derek-weissinger-usafa/Astro-331-Lab-8/Past Documentation/Gemini Hardware Diagram/Gemini (Hamster Ball) .jpg

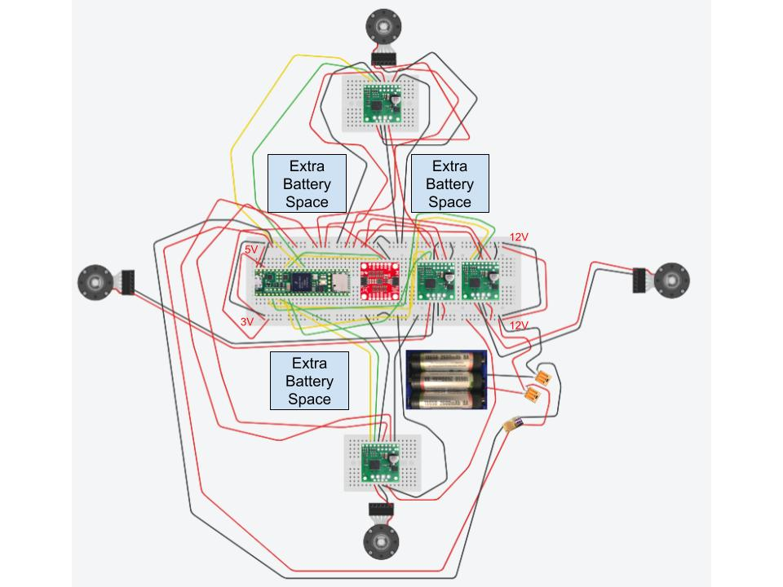
Past Documentation/Gemini Hardware Diagram/Gemini (Hamster Ball) .jpg
