derek-weissinger-usafa/Astro-331-Lab-8/Astro 331 Lab 8 Overview and Requirements.pptx

## Lab 8 3DOF RW Control

2/3 Body Problem
C2C Gowri Ramaprasad
C2C Derek Weissinger
C2C Owen Crawley

Notes: https://www.youtube.com/watch?v=jVXgWGK9Kr8

## Overview

- Using the small air bearing table, develop a reaction wheel control system in 3 degrees of freedom (pitch, yaw, roll).
- Develop a robust sensor fusion algorithm using gyroscopes, magnetometers and accelerometers to accurately determine attitude at any given state.

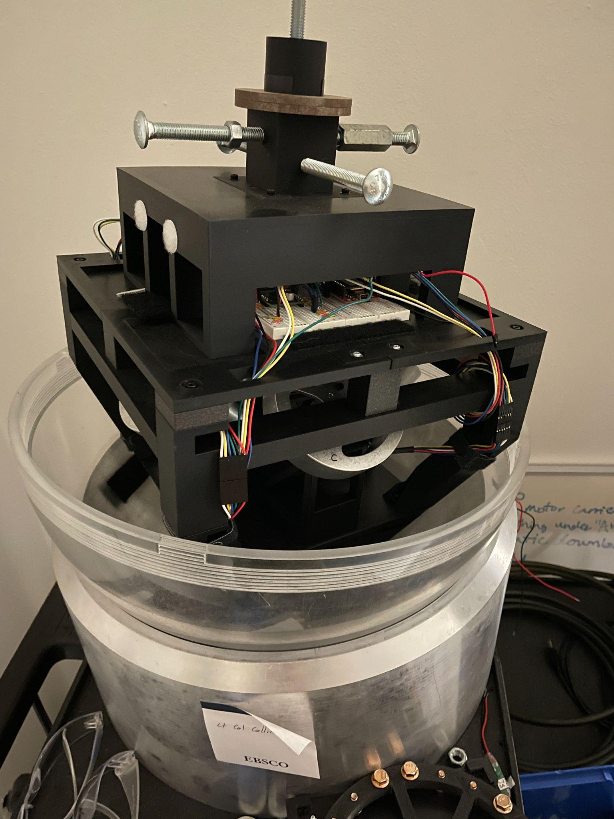
[picture p2: figure]
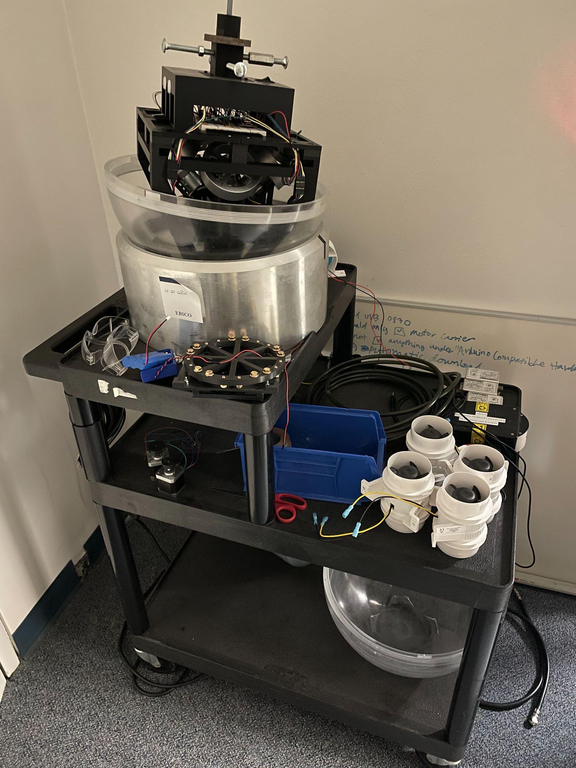
[picture p3: figure]

## Requirements

Primary Requirements:
1. The system shall maintain a specified heading without visible jitter or drift.
2. The system shall be able to determine true attitude +/- 1 degree in all 3 fundamental axes.
3. The system shall automatically detect simulated or real wheel failure and compensate, still fulfilling above requirements.
Stretch Requirement:
1. The system shall slew to a series of 4 points following the optimal path, coming within +/- 1 degree of each point in all 3 fundamental axes.
