derek-weissinger-usafa/Astro-331-Lab-8/Past Documentation/Air Bearing Table Sphere/Simulink Files/Arduino Command/Read me.docx

Read me to start the air bearing table

Matlab preparation:

1. Start Matlab
2. Load “Inertia.mat” file. In DCMotorCharacterization, load “motorResponse1.mat”, “motorResponse2.mat”, “motorResponse3.mat”, “motorResponse4.mat”.
3. Open “commandABT.slx” file
4. Go to Hardware Settings / Hardware Implementation / Target hardware resources / WiFi properties, enter the properties of your WiFi hotspot. In External mode, set XCP on WiFi.
5. Connect the computer to the hotspot.

Table preparation:

1. Check the tension level of the batteries (>12V)
2. Chek also the connection between the batteries and the pins.
3. Connect the Arduino alimentation pin: black to the ground and red to the VIN pin
4. Connect the Arduino board to the computer
5. Set the command angles

Click on “Run on hardware to lunch the table”

1. Once “Connecting to MKR1000” is displayed, disconnect the Arduino board from the computer
2. Maintain the table during the wheel initialization
3. Release when the wheels are initialized (the initial speeds are in the Simulink program, in the “controller” block.
