derek-weissinger-usafa/Astro-331-Lab-8/Notes/laser_scale_2480mm.pdf

+1.5

+2°

+2.5

+3°

+3.5

+4°

+4.5

+5°

this bar must measure 100 mm (print at 100 % / Actual size)

Laser heading scale, wall 2480 mm from the rotation axis: x = 2480 mm × tan θ Ticks: 0.5° to ±5°, 0.1° within ±1°. Positive = table turns counter-clockwise from above (firmware yaw +): dot moves LEFT.

LEFT page (+ side), page 1 of 3. Tape the pages so the shared ticks overlap exactly.

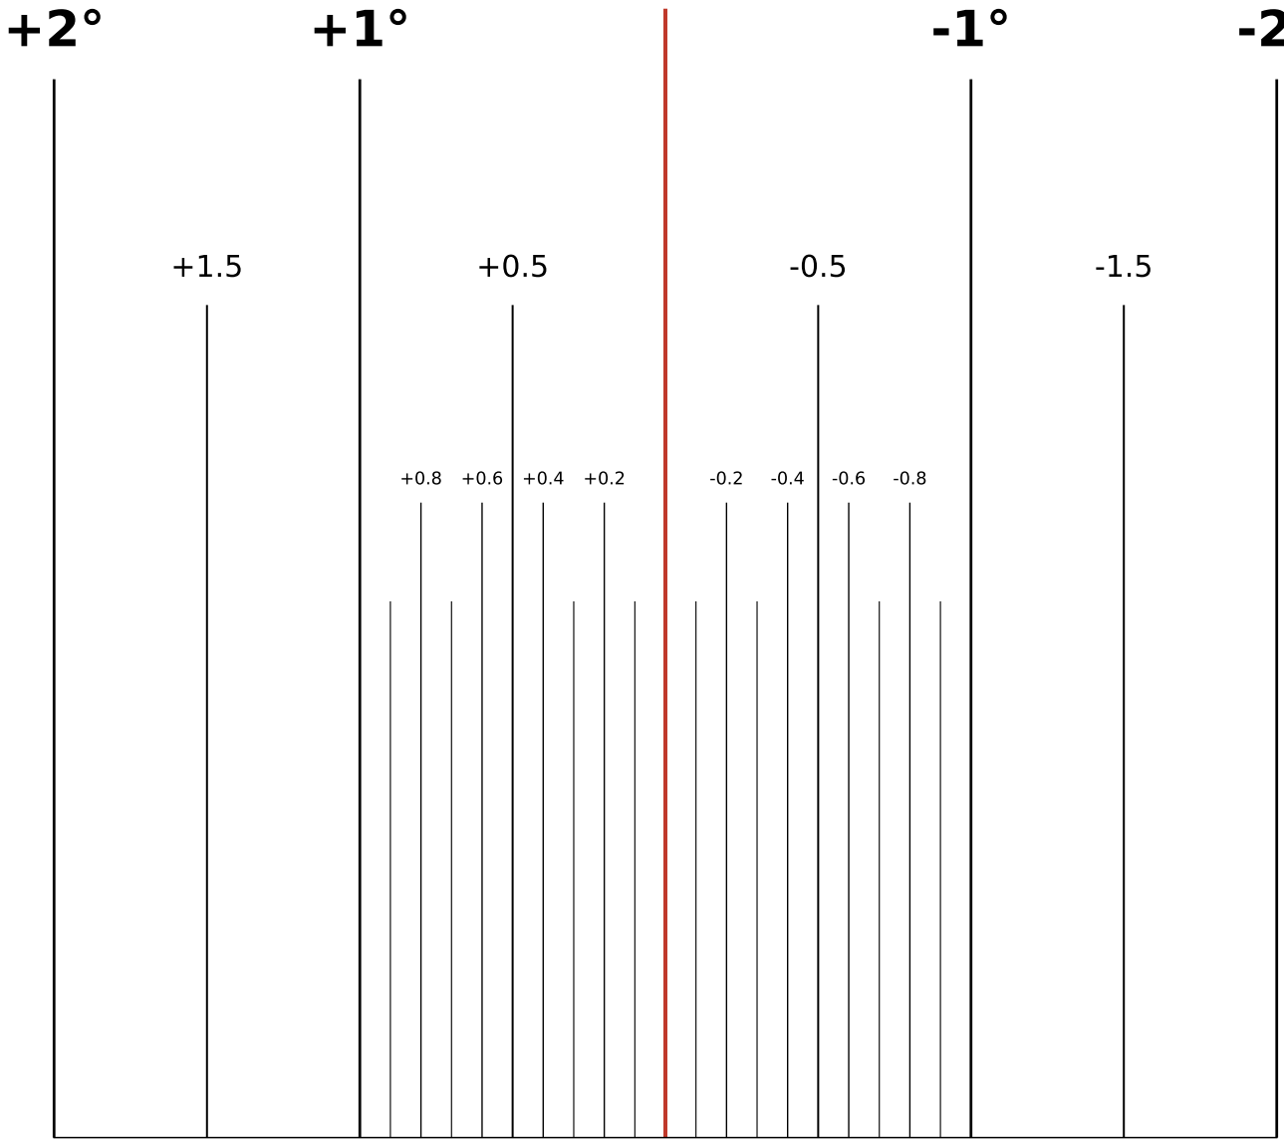
[picture p77: figure]

-2°

0°

Laser heading scale, wall 2480 mm from the rotation axis: x = 2480 mm × tan θ

CENTRE page, page 2 of 3. Tape the pages so the shared ticks overlap exactly.

-5°

-4.5

-4°

-3.5

-3°

-2.5

-2°

-1.5

Laser heading scale, wall 2480 mm from the rotation axis: x = 2480 mm × tan θ

RIGHT page (− side), page 3 of 3. Tape the pages so the shared ticks overlap exactly.
