derek-weissinger-usafa/Astro-331-Lab-8/Reports/figures/writeup_2026-10-31/sim_fixed.csv

t_s | yaw_deg | yaw_ref_deg | roll_deg | pitch_deg | wA | wB | wC | wD | phase | target
0.00 | 17.1893 | 17.1892 | -0.9899 | 0.2198 | -0.018 | -0.018 | -0.019 | -0.019 | S | 0
0.10 | 17.1968 | 17.1961 | -0.9901 | 0.2195 | -0.204 | -0.197 | -0.204 | -0.211 | S | 0
0.20 | 17.2158 | 17.2145 | -0.9904 | 0.2188 | -0.391 | -0.379 | -0.388 | -0.401 | S | 0
0.30 | 17.2463 | 17.2442 | -0.9909 | 0.2178 | -0.580 | -0.563 | -0.570 | -0.587 | S | 0
0.40 | 17.2883 | 17.2854 | -0.9915 | 0.2165 | -0.770 | -0.749 | -0.751 | -0.771 | S | 0
0.50 | 17.3416 | 17.3380 | -0.9921 | 0.2151 | -0.961 | -0.937 | -0.930 | -0.954 | S | 0
0.60 | 17.4064 | 17.4020 | -0.9927 | 0.2135 | -1.152 | -1.124 | -1.108 | -1.136 | S | 0
0.70 | 17.4826 | 17.4774 | -0.9934 | 0.2120 | -1.342 | -1.311 | -1.286 | -1.317 | S | 0
0.80 | 17.5701 | 17.5640 | -0.9939 | 0.2104 | -1.532 | -1.497 | -1.462 | -1.498 | S | 0
0.90 | 17.6689 | 17.6620 | -0.9944 | 0.2090 | -1.721 | -1.680 | -1.639 | -1.680 | S | 0
1.00 | 17.7790 | 17.7711 | -0.9947 | 0.2076 | -1.908 | -1.861 | -1.815 | -1.862 | S | 0
1.10 | 17.9002 | 17.8914 | -0.9950 | 0.2064 | -2.094 | -2.040 | -1.991 | -2.045 | S | 0
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
