derek-weissinger-usafa/Astro-331-Lab-8/Reports/figures/writeup_2026-10-31/sim_slewyaw.csv

t_s | yaw_deg | yaw_ref_deg | roll_deg | pitch_deg | wA | wB | wC | wD | phase | target
0.00 | 17.1893 | 17.1893 | -0.9899 | 0.2198 | -0.018 | -0.018 | -0.019 | -0.019 | S | 0
0.10 | 17.1968 | 17.1961 | -0.9901 | 0.2196 | -0.204 | -0.200 | -0.204 | -0.208 | S | 0
0.20 | 17.2159 | 17.2145 | -0.9904 | 0.2190 | -0.391 | -0.386 | -0.388 | -0.393 | S | 0
0.30 | 17.2463 | 17.2442 | -0.9909 | 0.2181 | -0.580 | -0.574 | -0.570 | -0.576 | S | 0
0.40 | 17.2883 | 17.2854 | -0.9915 | 0.2170 | -0.769 | -0.764 | -0.752 | -0.757 | S | 0
0.50 | 17.3417 | 17.3381 | -0.9921 | 0.2158 | -0.959 | -0.955 | -0.932 | -0.937 | S | 0
0.60 | 17.4065 | 17.4021 | -0.9928 | 0.2145 | -1.149 | -1.145 | -1.111 | -1.115 | S | 0
0.70 | 17.4826 | 17.4774 | -0.9935 | 0.2133 | -1.338 | -1.336 | -1.290 | -1.293 | S | 0
0.80 | 17.5701 | 17.5641 | -0.9941 | 0.2120 | -1.526 | -1.525 | -1.469 | -1.470 | S | 0
0.90 | 17.6690 | 17.6620 | -0.9947 | 0.2108 | -1.713 | -1.713 | -1.647 | -1.647 | S | 0
1.00 | 17.7790 | 17.7711 | -0.9952 | 0.2098 | -1.899 | -1.900 | -1.825 | -1.824 | S | 0
1.10 | 17.9003 | 17.8915 | -0.9956 | 0.2088 | -2.082 | -2.084 | -2.003 | -2.001 | S | 0
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
