derek-weissinger-usafa/Astro-331-Lab-8/Reports/figures/Battery Holder CAD.png

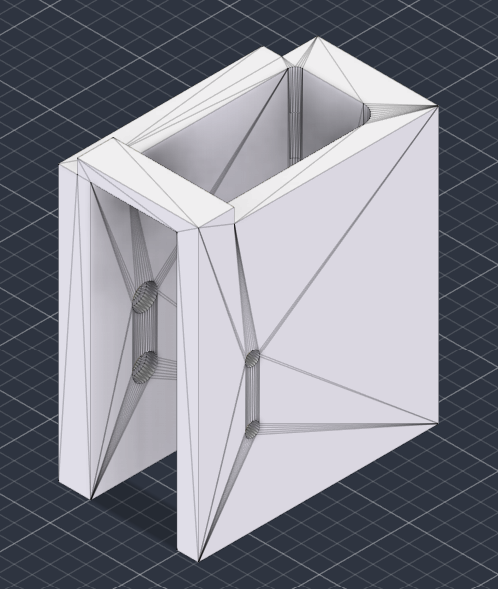
Reports/figures/Battery Holder CAD.png
