derek-weissinger-usafa/Astro-331-Lab-8/Reports/figures/demo_all_2026-11-01/fig1_overview.png

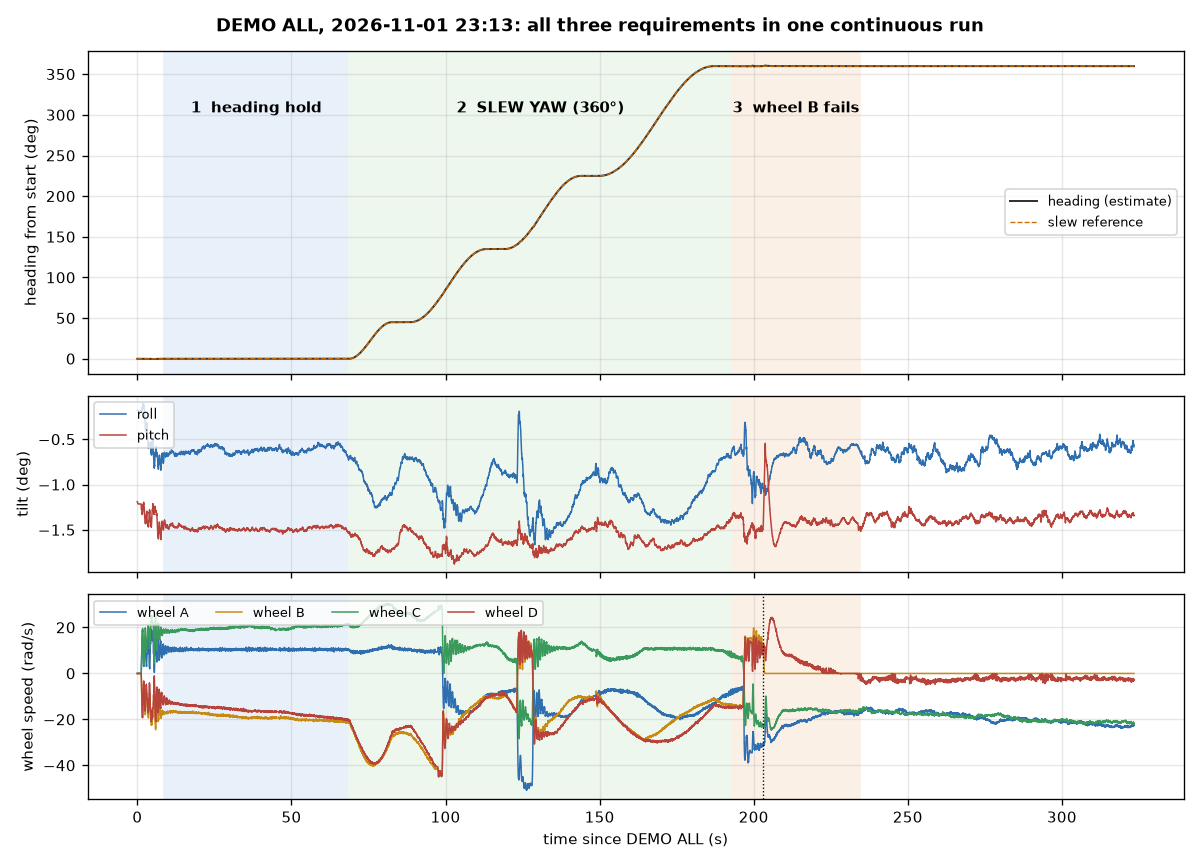
Reports/figures/demo_all_2026-11-01/fig1_overview.png
