derek-weissinger-usafa/Astro-331-Lab-8/Reports/figures/demo_all_2026-11-01/fig2_req1_hold.png

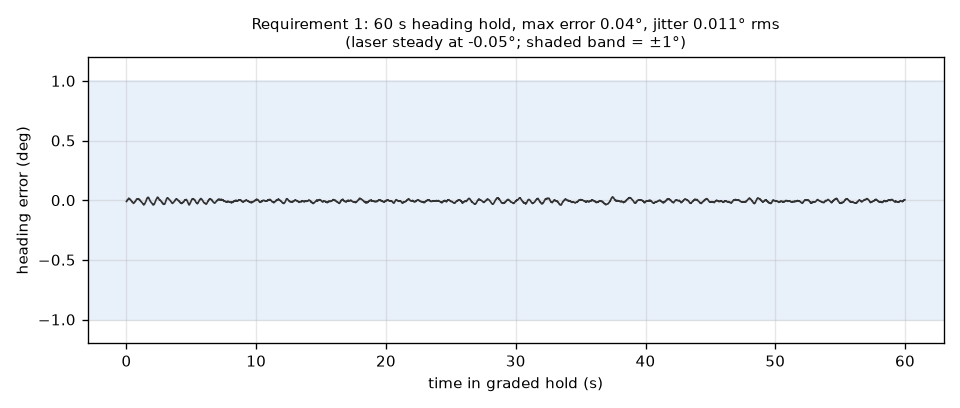
Reports/figures/demo_all_2026-11-01/fig2_req1_hold.png
