derek-weissinger-usafa/Astro-331-Lab-8/Reports/figures/demo_all_2026-11-01/fig3_req2_slews.png

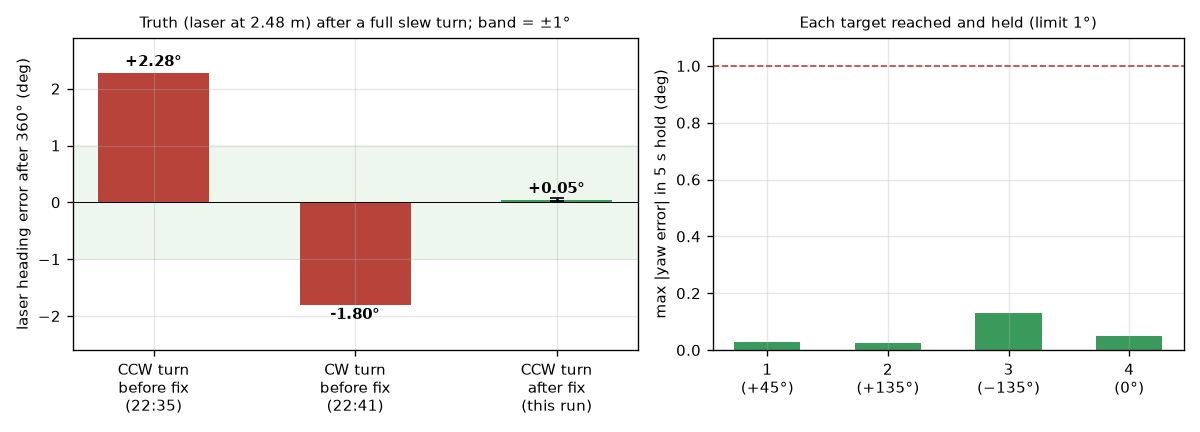
Reports/figures/demo_all_2026-11-01/fig3_req2_slews.png
