derek-weissinger-usafa/Astro-331-Lab-8/Reports/figures/diag_control_loop.png

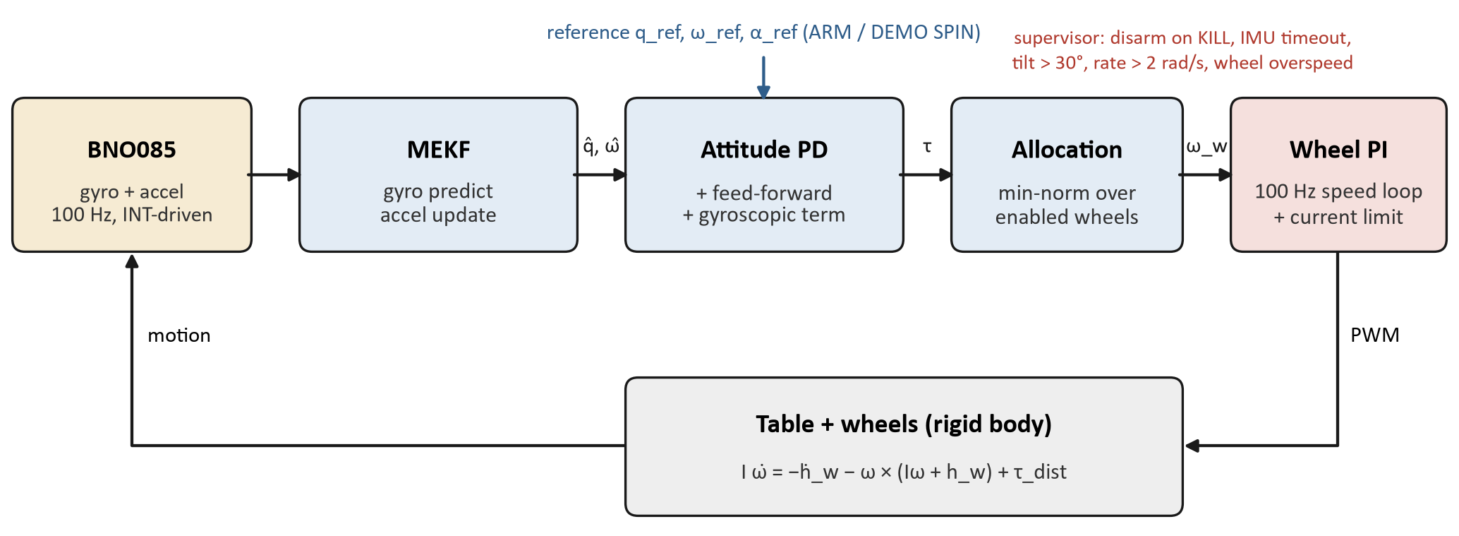
Reports/figures/diag_control_loop.png
