derek-weissinger-usafa/Astro-331-Lab-8/Reports/figures/diag_control_loop_io.png

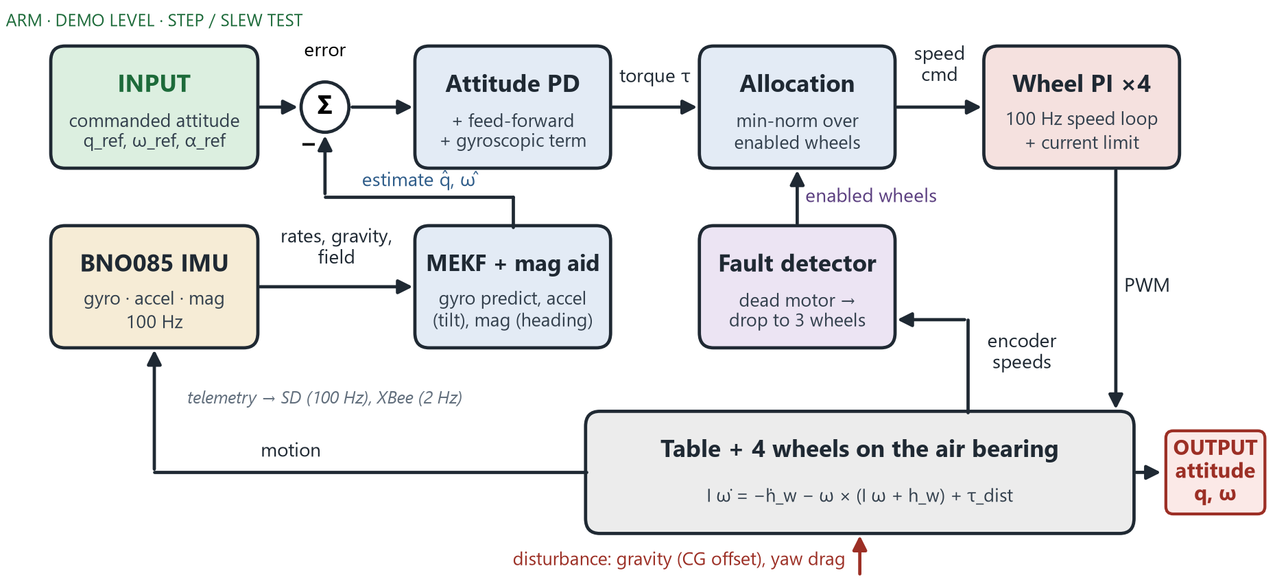
Reports/figures/diag_control_loop_io.png
