derek-weissinger-usafa/Astro-331-Lab-8/Reports/figures/diag_hardware.png

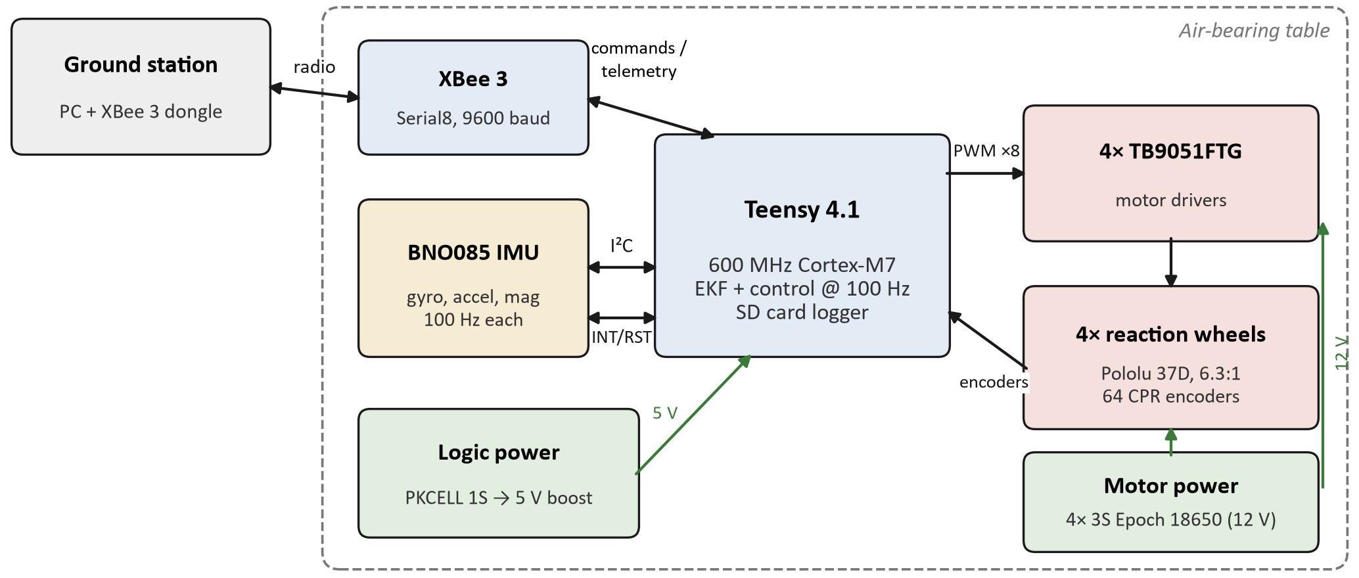
Reports/figures/diag_hardware.png
