derek-weissinger-usafa/Astro-331-Lab-8/Reports/figures/diag_wheel_pyramid.png

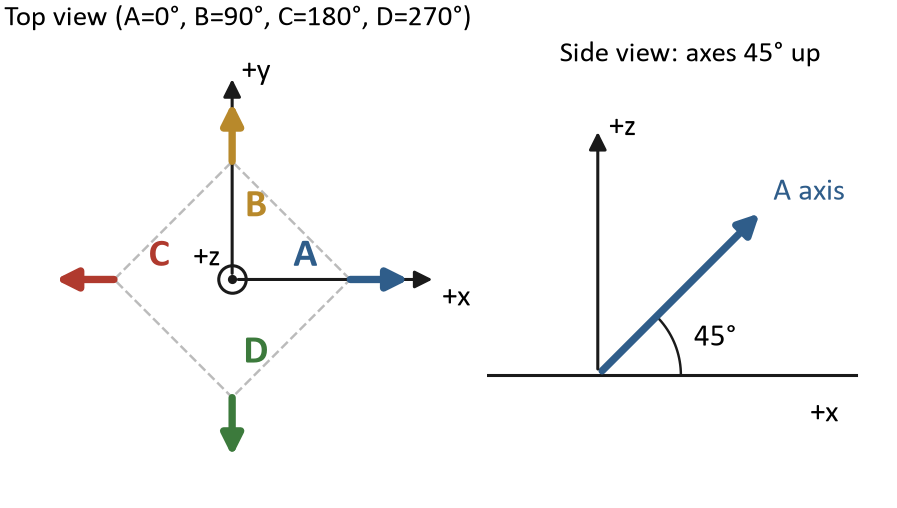
Reports/figures/diag_wheel_pyramid.png
