derek-weissinger-usafa/Astro-331-Lab-8/Reports/figures/fig1_wheel_speed_sweep.png

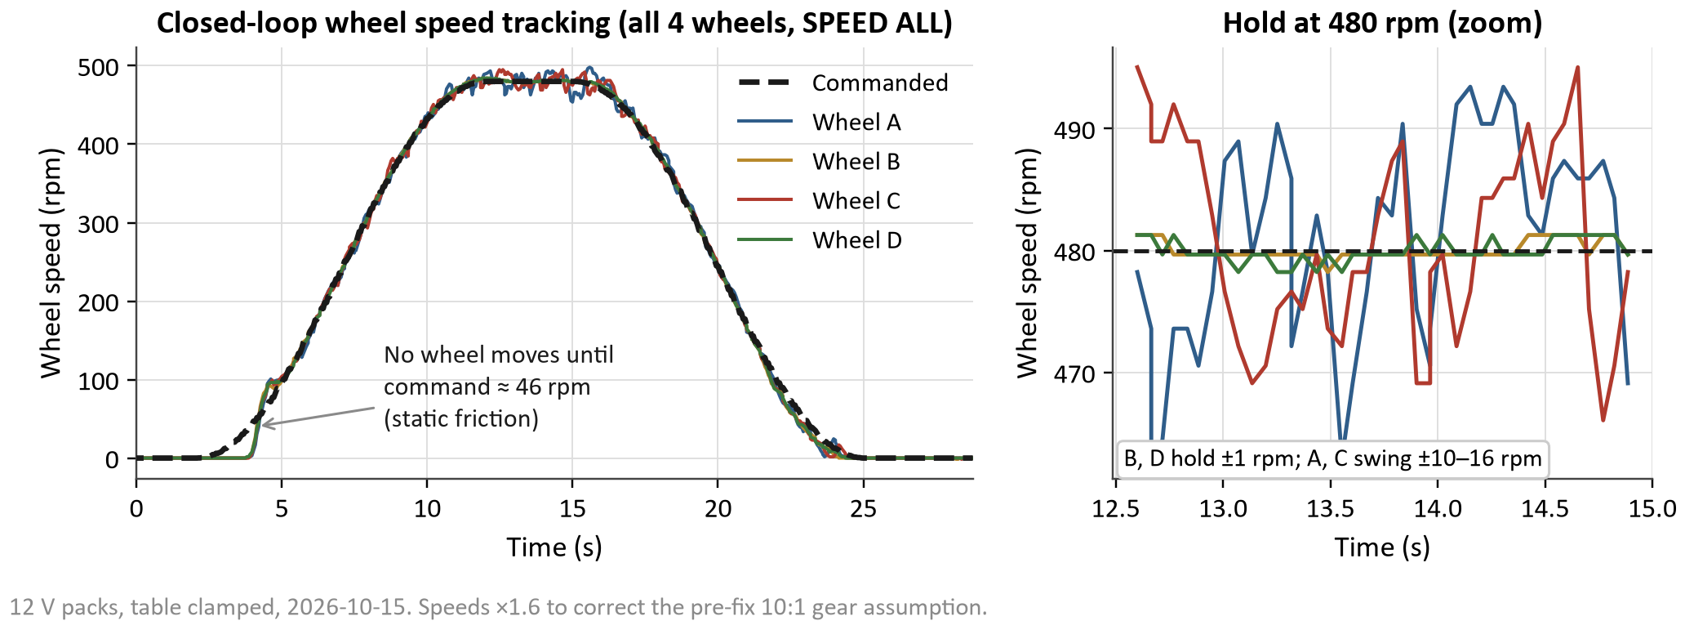
Reports/figures/fig1_wheel_speed_sweep.png
