derek-weissinger-usafa/Astro-331-Lab-8/Reports/figures/fig2_static_attitude.png

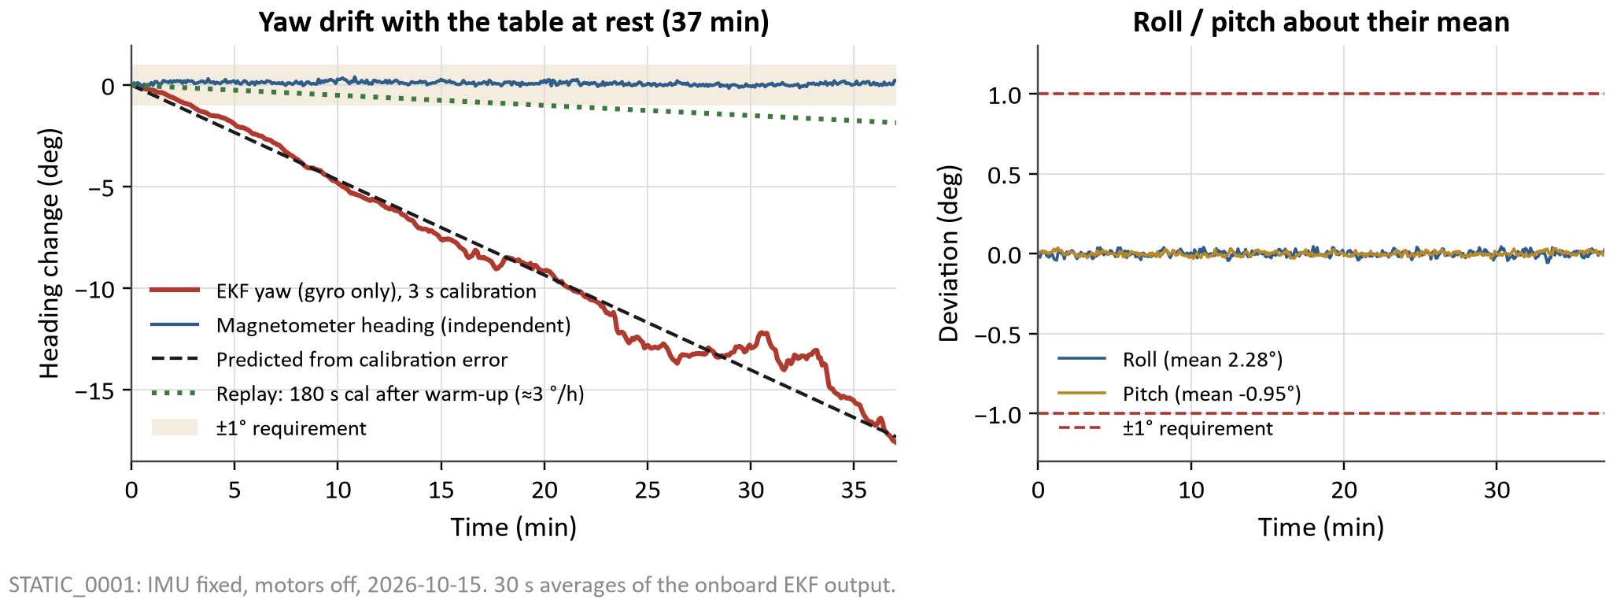
Reports/figures/fig2_static_attitude.png
