derek-weissinger-usafa/Astro-331-Lab-8/Reports/figures/fig3_imu_integrity.png

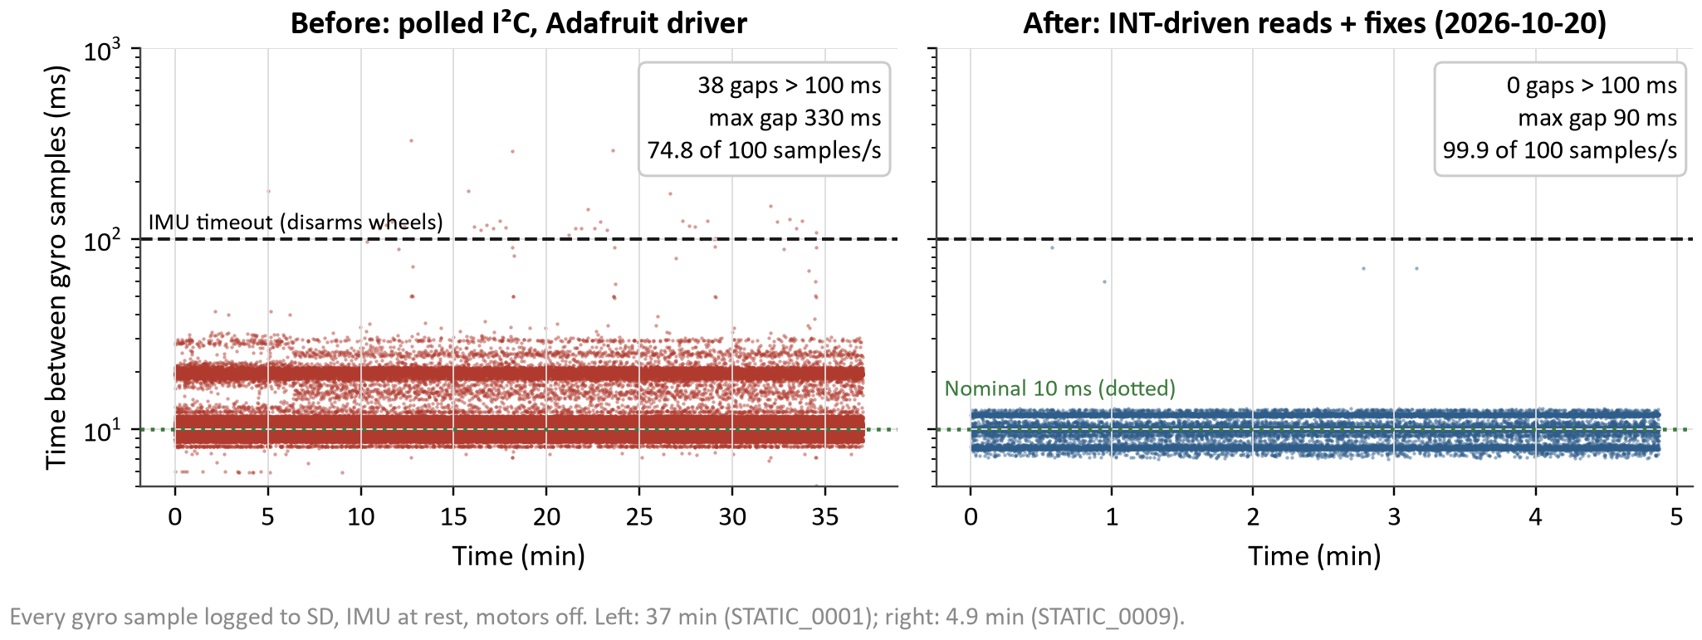
Reports/figures/fig3_imu_integrity.png
