derek-weissinger-usafa/Astro-331-Lab-8/Reports/figures/fig4_mag_disturbance.png

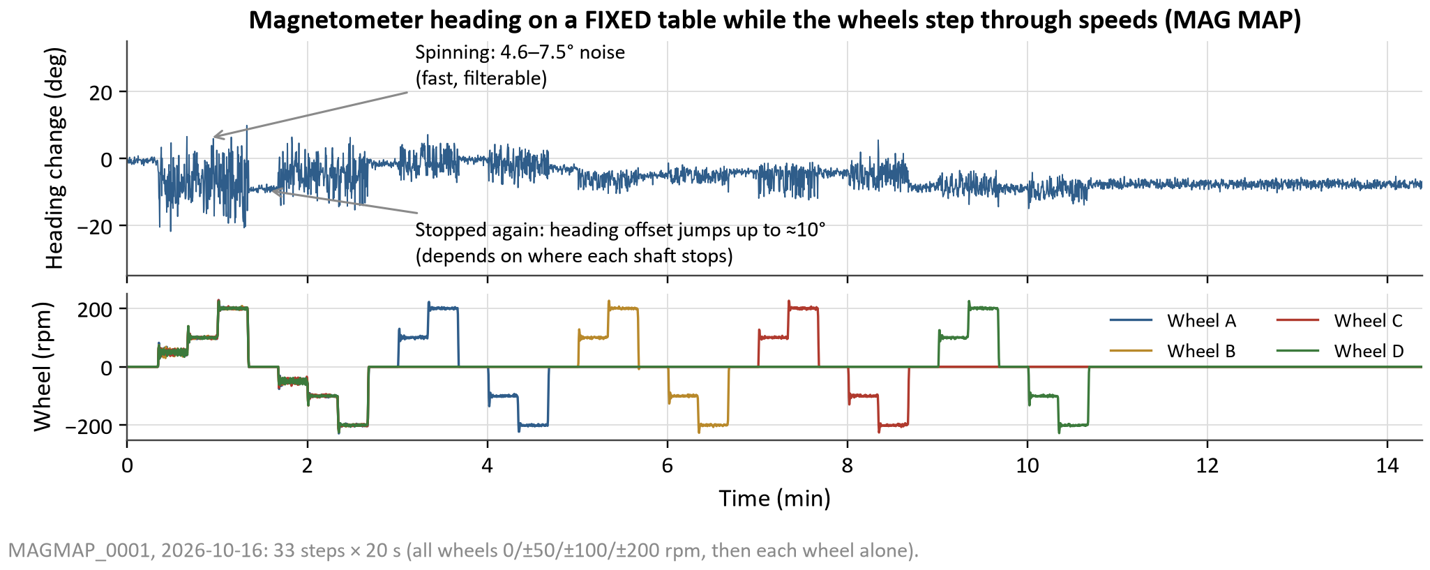
Reports/figures/fig4_mag_disturbance.png
