derek-weissinger-usafa/Astro-331-Lab-8/Reports/figures/fig5_demo_pendulum.png

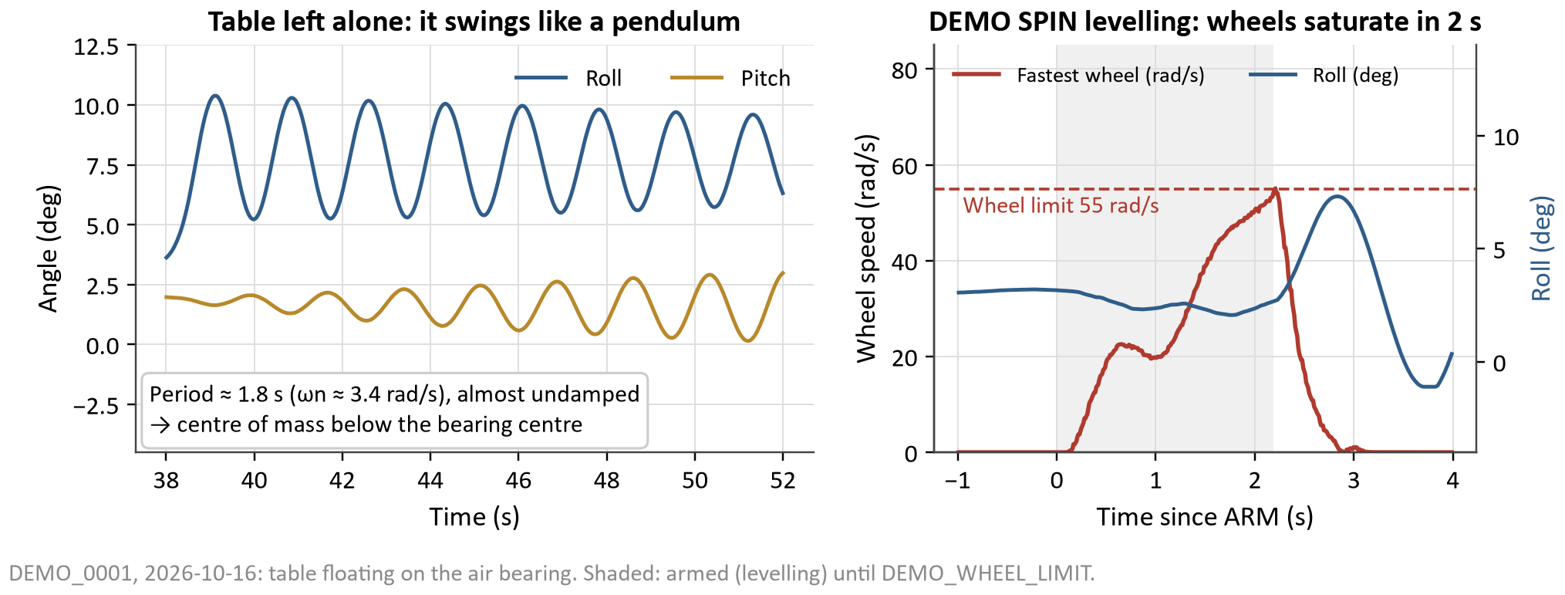
Reports/figures/fig5_demo_pendulum.png
