derek-weissinger-usafa/Astro-331-Lab-8/Reports/figures/fig6_demo2_balanced.png

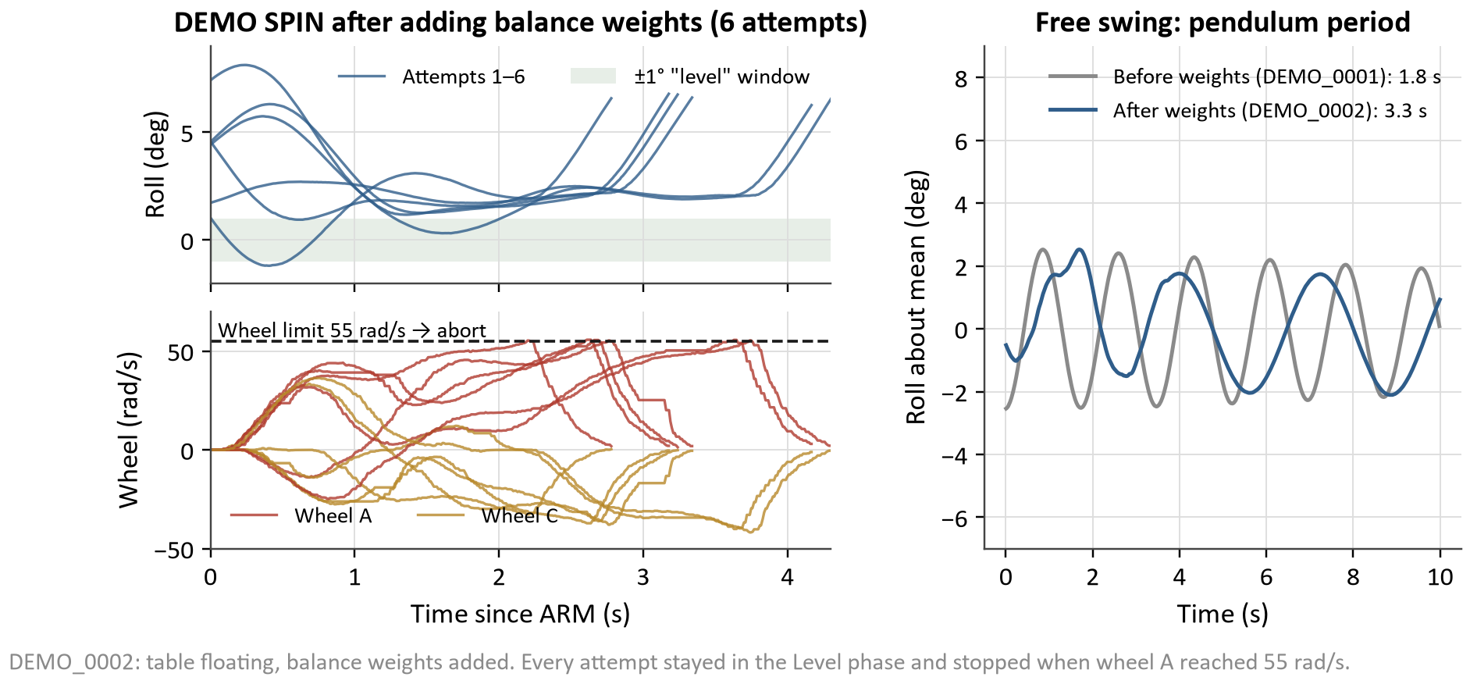
Reports/figures/fig6_demo2_balanced.png
