derek-weissinger-usafa/Astro-331-Lab-8/Reports/figures/fig7_demo_level.png

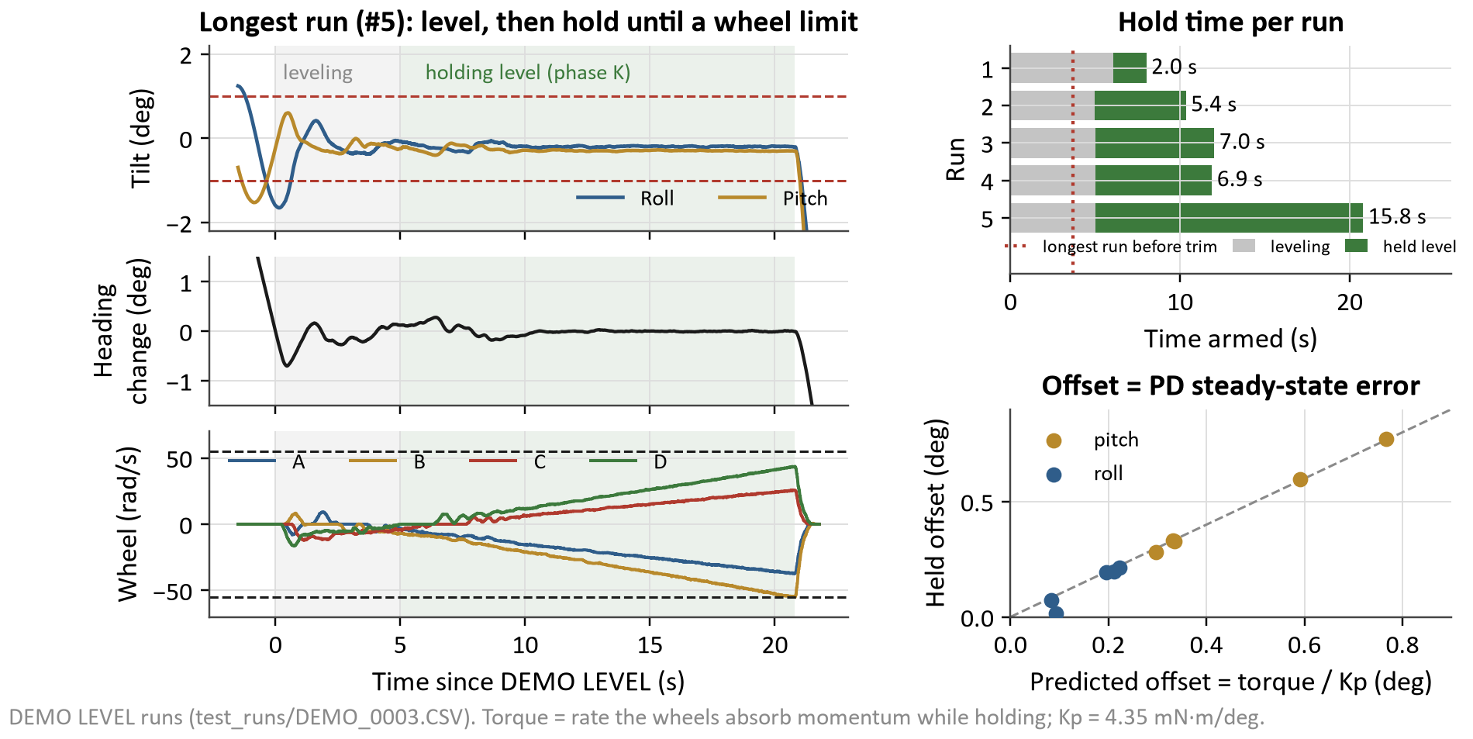
Reports/figures/fig7_demo_level.png
