derek-weissinger-usafa/Astro-331-Lab-8/Reports/figures/fig9_magtest.png

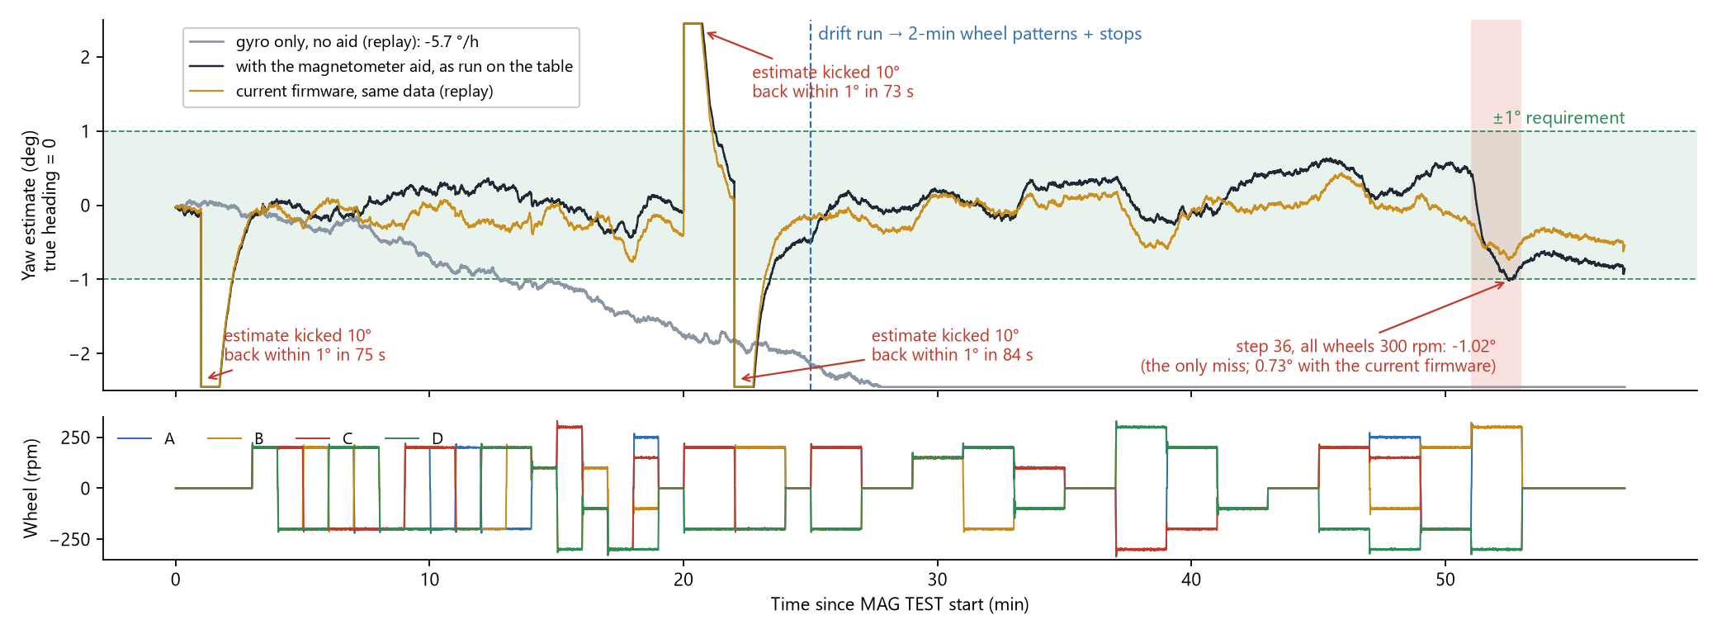
Reports/figures/fig9_magtest.png
