derek-weissinger-usafa/Astro-331-Lab-8/Reports/figures/final_2026-11-02/d3_laser_holds.png

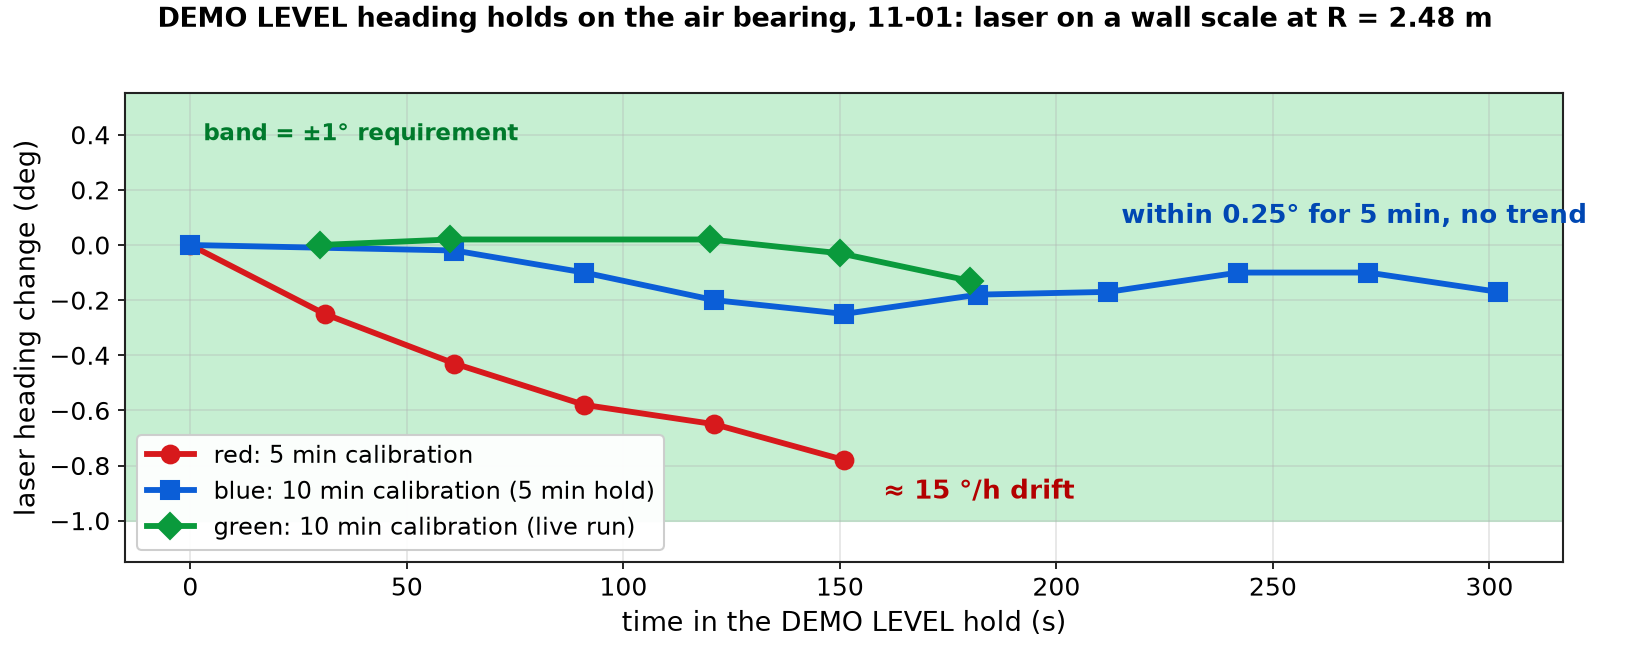
Reports/figures/final_2026-11-02/d3_laser_holds.png
