derek-weissinger-usafa/Astro-331-Lab-8/Reports/figures/final_2026-11-02/d4_heading_leak.png

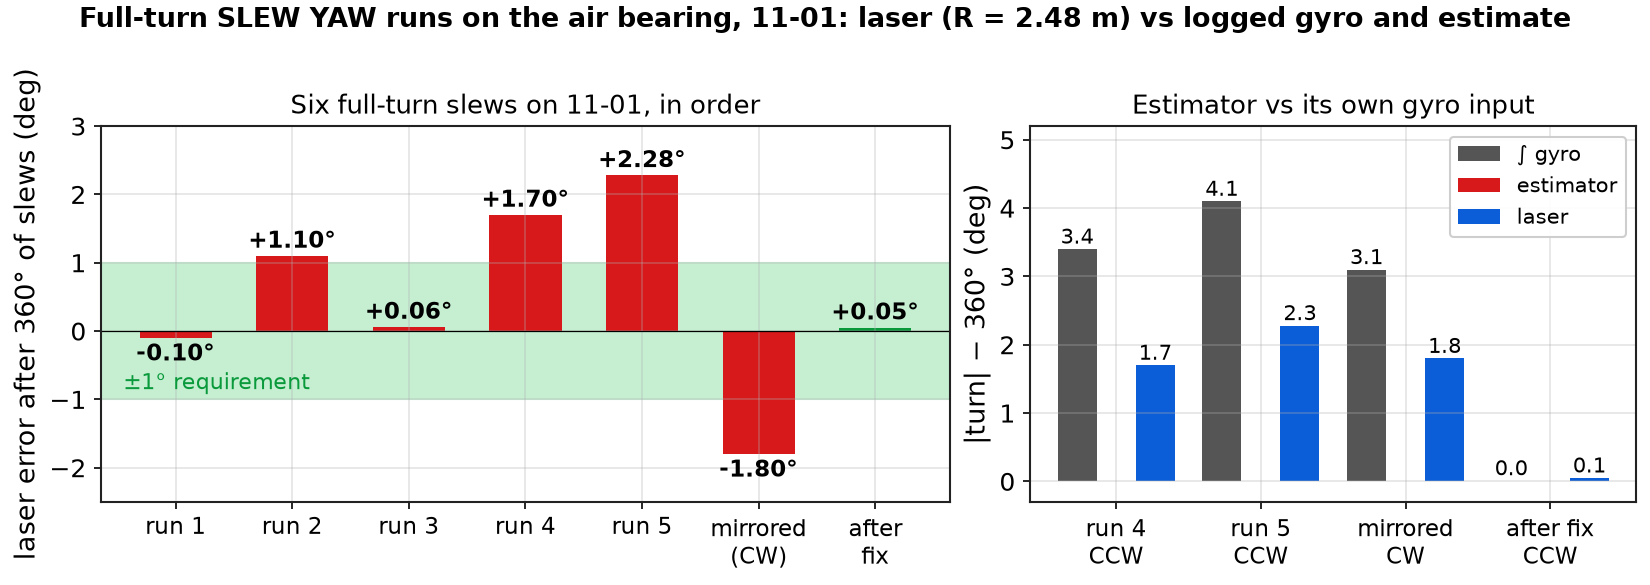
Reports/figures/final_2026-11-02/d4_heading_leak.png
