derek-weissinger-usafa/Astro-331-Lab-8/Reports/figures/final_2026-11-02/d8_req3.png

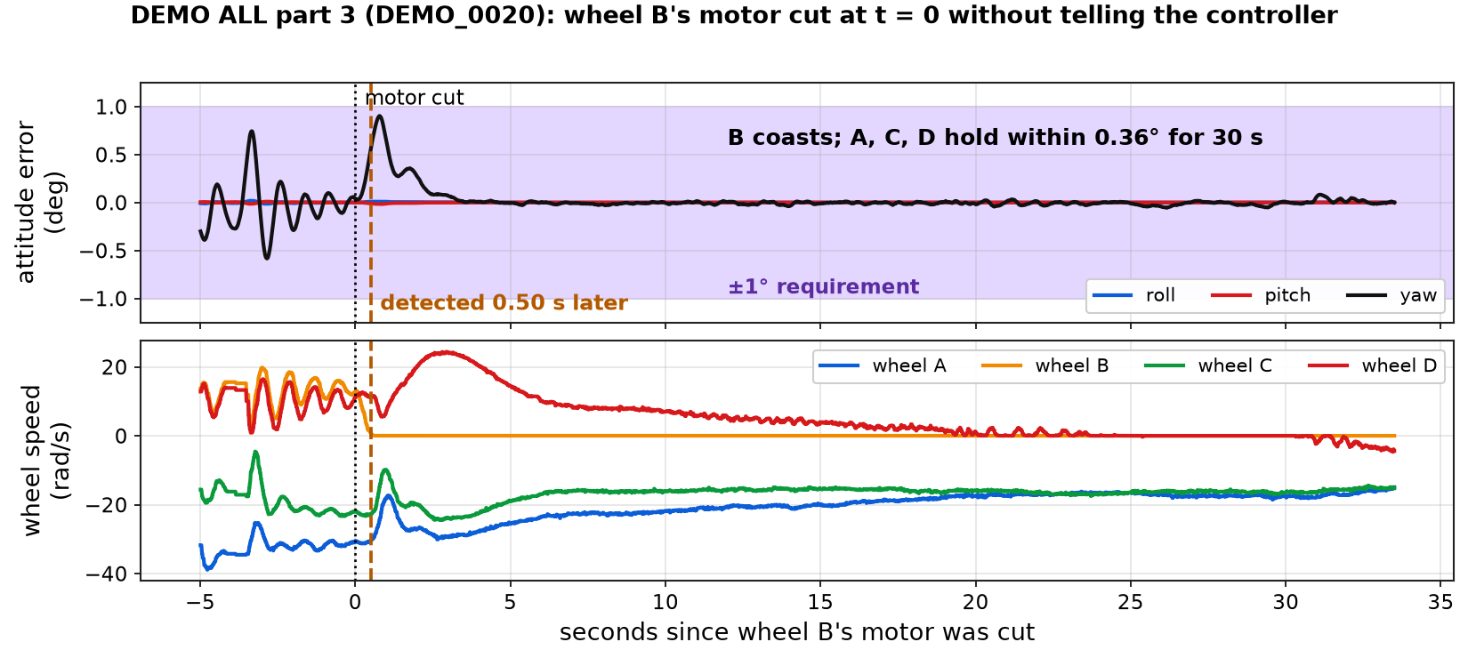
Reports/figures/final_2026-11-02/d8_req3.png
