derek-weissinger-usafa/Astro-331-Lab-8/Reports/figures/sim4_momentum_saturation.png

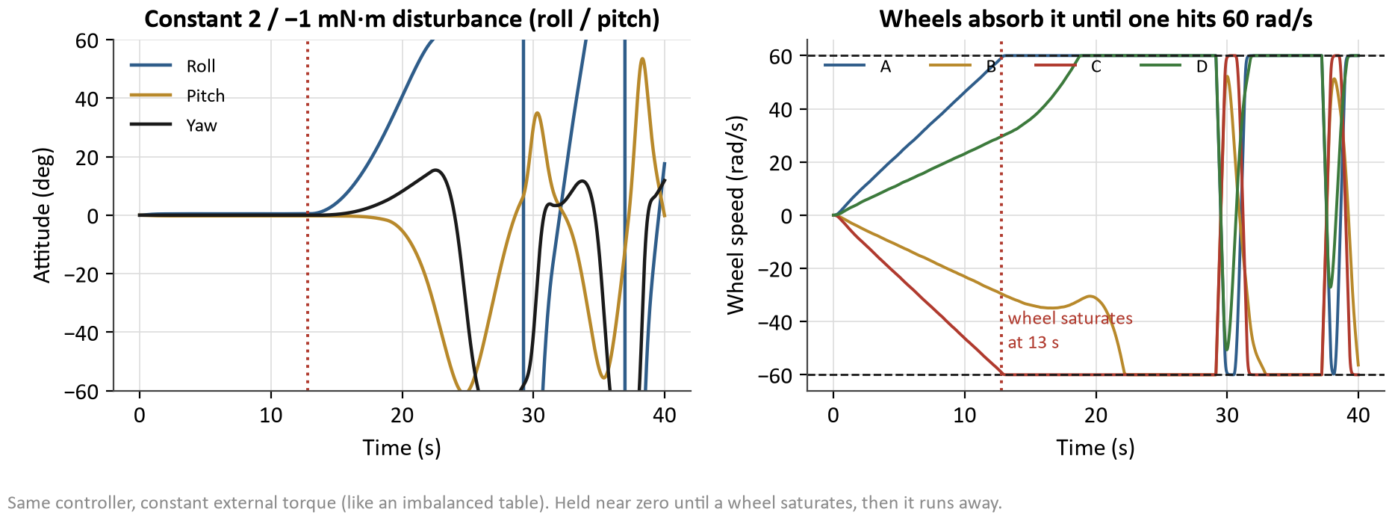
Reports/figures/sim4_momentum_saturation.png
