derek-weissinger-usafa/Astro-331-Lab-8/Reports/figures/sim5_demo_spin.png

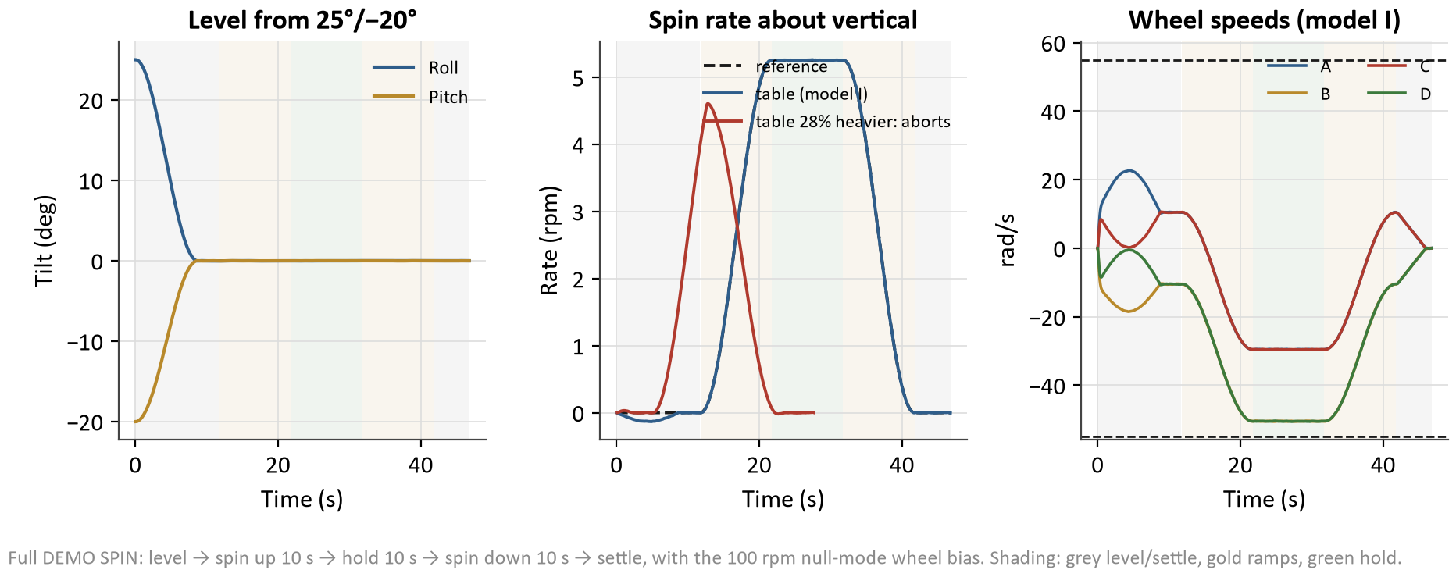
Reports/figures/sim5_demo_spin.png
