derek-weissinger-usafa/Astro-331-Lab-8/Reports/figures/sim6_demo_level_rest.png

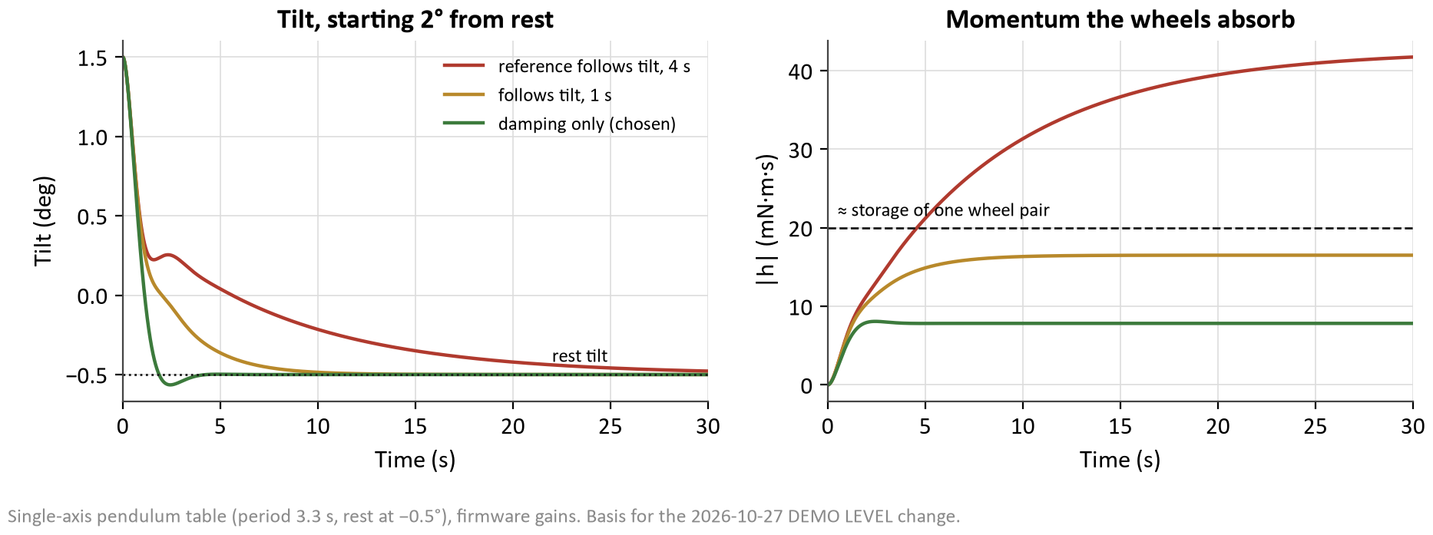
Reports/figures/sim6_demo_level_rest.png
