derek-weissinger-usafa/Astro-331-Lab-8/Reports/figures/sim8_slew_cases.png

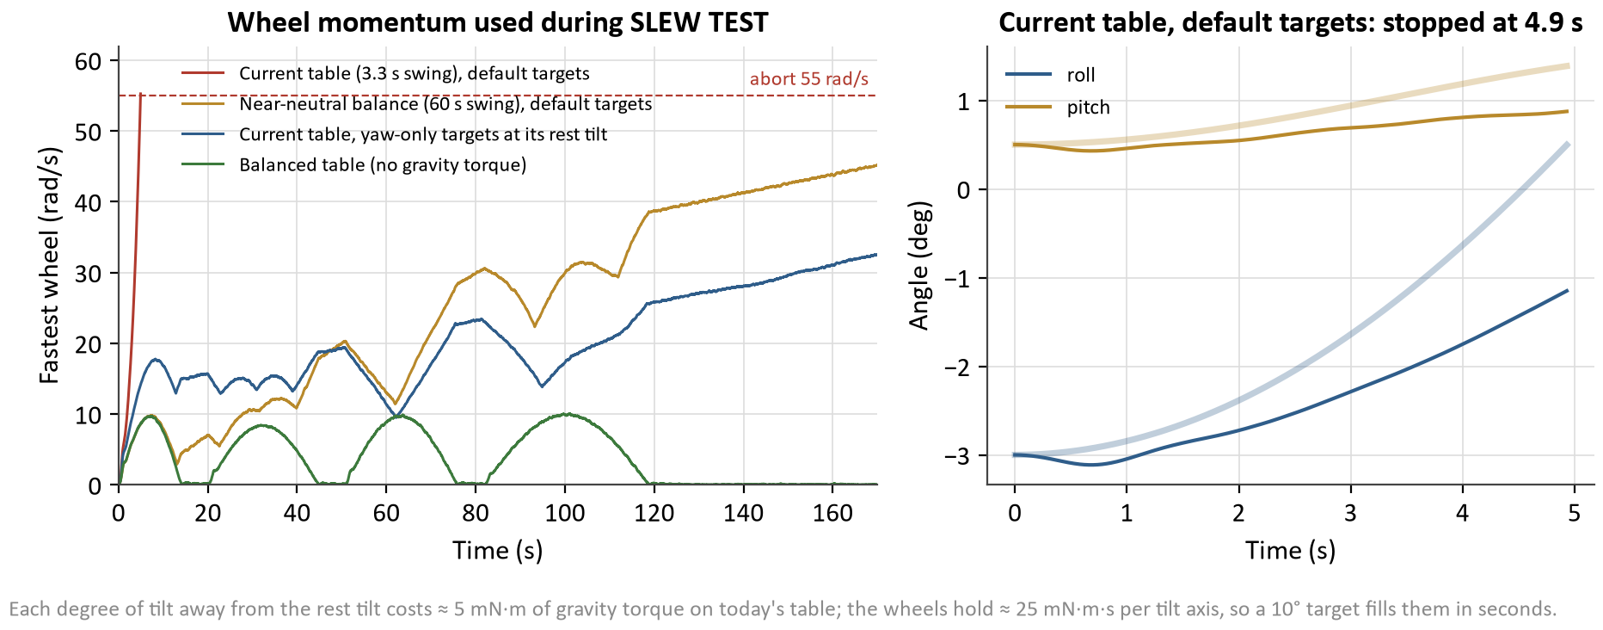
Reports/figures/sim8_slew_cases.png
