derek-weissinger-usafa/Astro-331-Lab-8/Reports/figures/sim9_fault_level.png

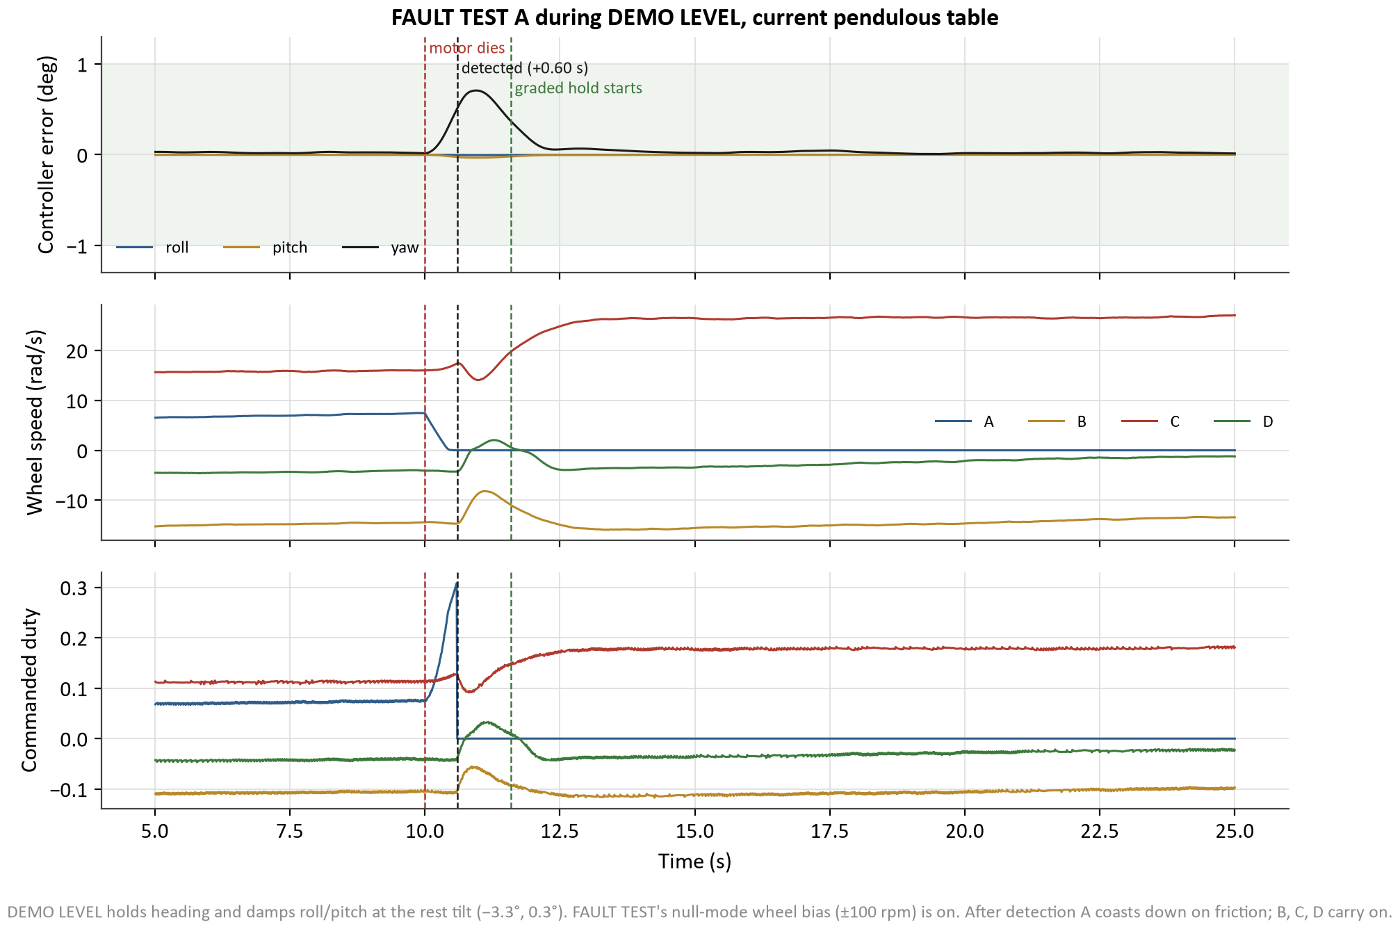
Reports/figures/sim9_fault_level.png
