derek-weissinger-usafa/Astro-331-Lab-8/Reports/figures/sim10_fault_slew.png

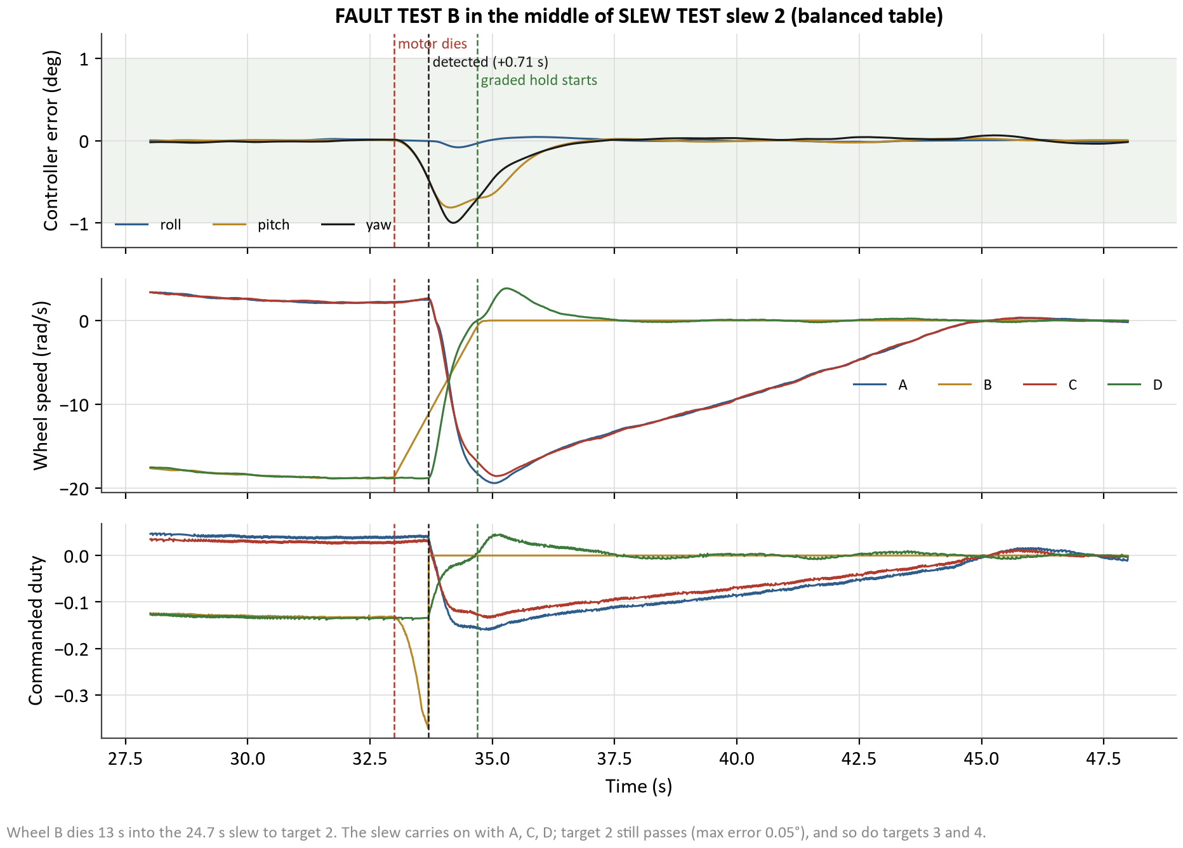
Reports/figures/sim10_fault_slew.png
