derek-weissinger-usafa/Astro-331-Lab-8/Reports/figures/sim11_detector_margin.png

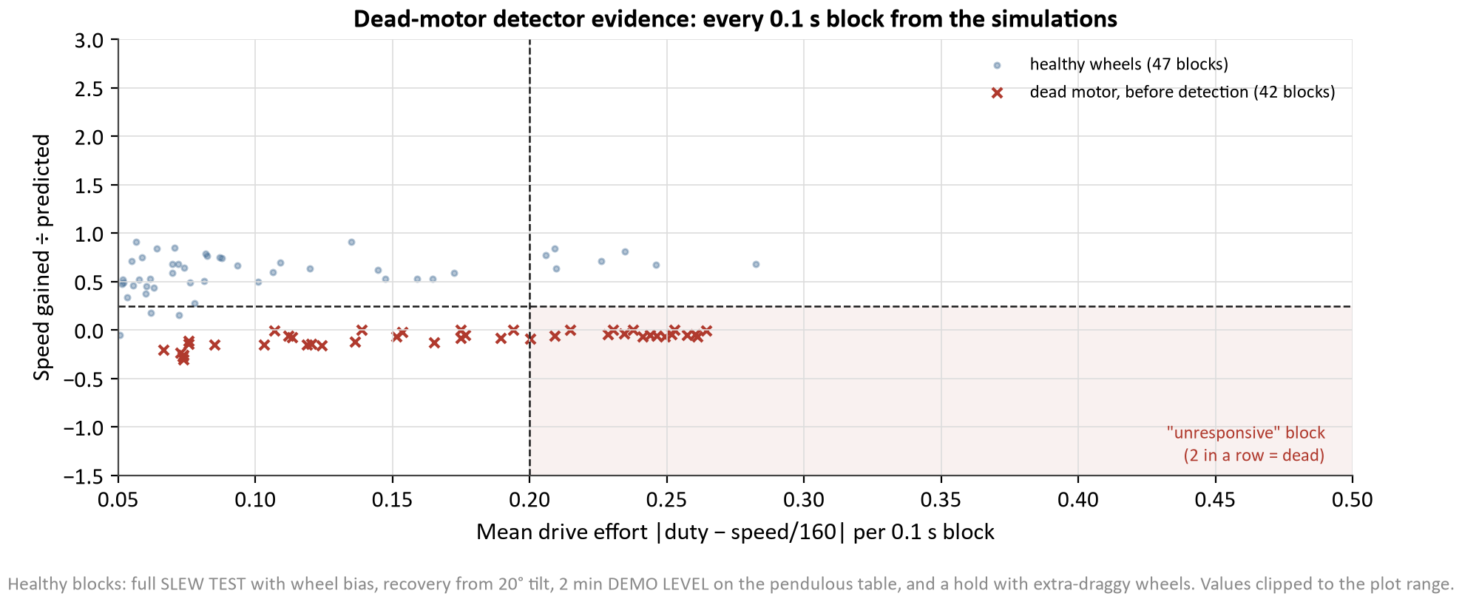
Reports/figures/sim11_detector_margin.png
