derek-weissinger-usafa/Astro-331-Lab-8/Reports/figures/writeup_2026-10-31/f01_magtest.png

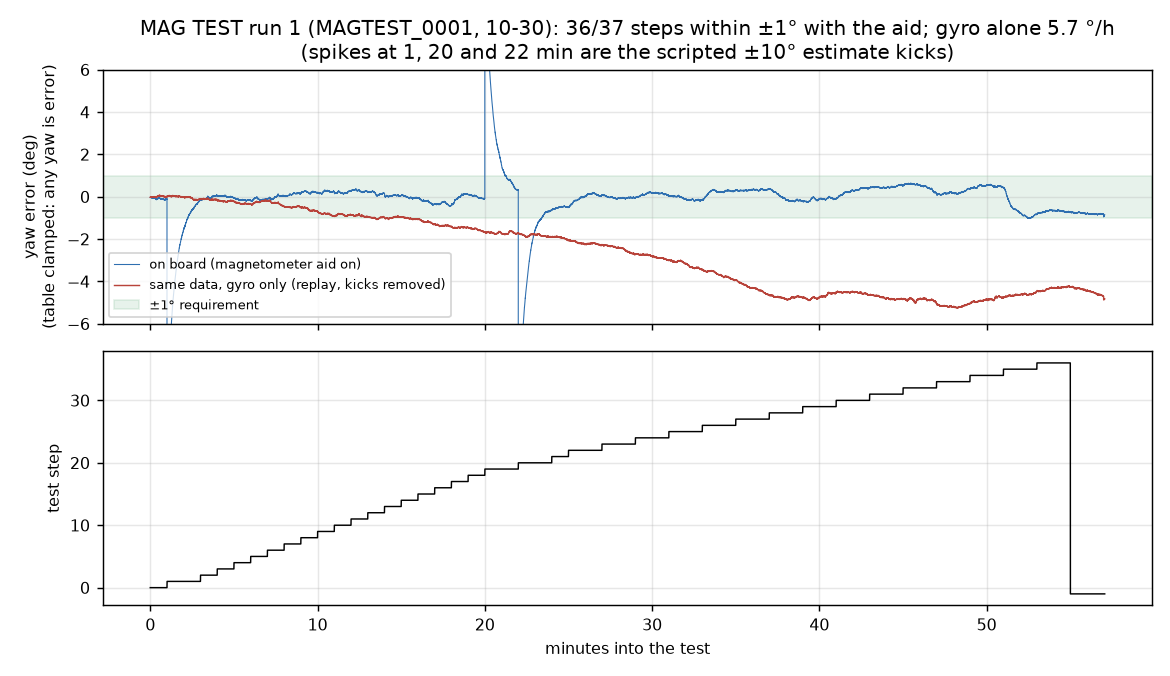
Reports/figures/writeup_2026-10-31/f01_magtest.png
