derek-weissinger-usafa/Astro-331-Lab-8/Reports/figures/writeup_2026-10-31/f02_balance.png

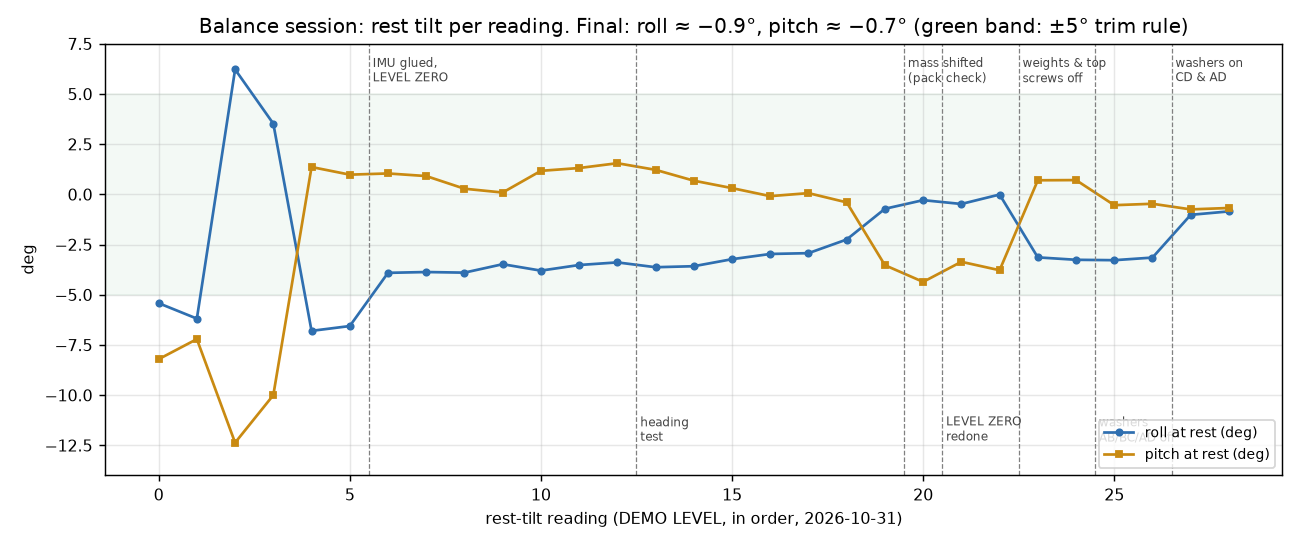
Reports/figures/writeup_2026-10-31/f02_balance.png
