derek-weissinger-usafa/Astro-331-Lab-8/Reports/figures/writeup_2026-10-31/f04_vibration_gaps.png

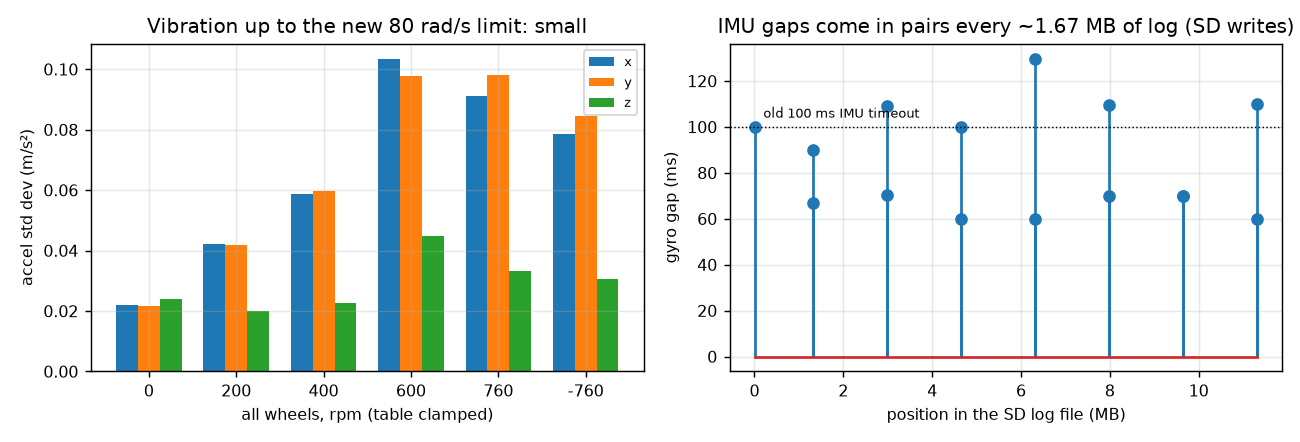
Reports/figures/writeup_2026-10-31/f04_vibration_gaps.png
