derek-weissinger-usafa/Astro-331-Lab-8/Reports/figures/writeup_2026-10-31/f05_heading_hardiron.png

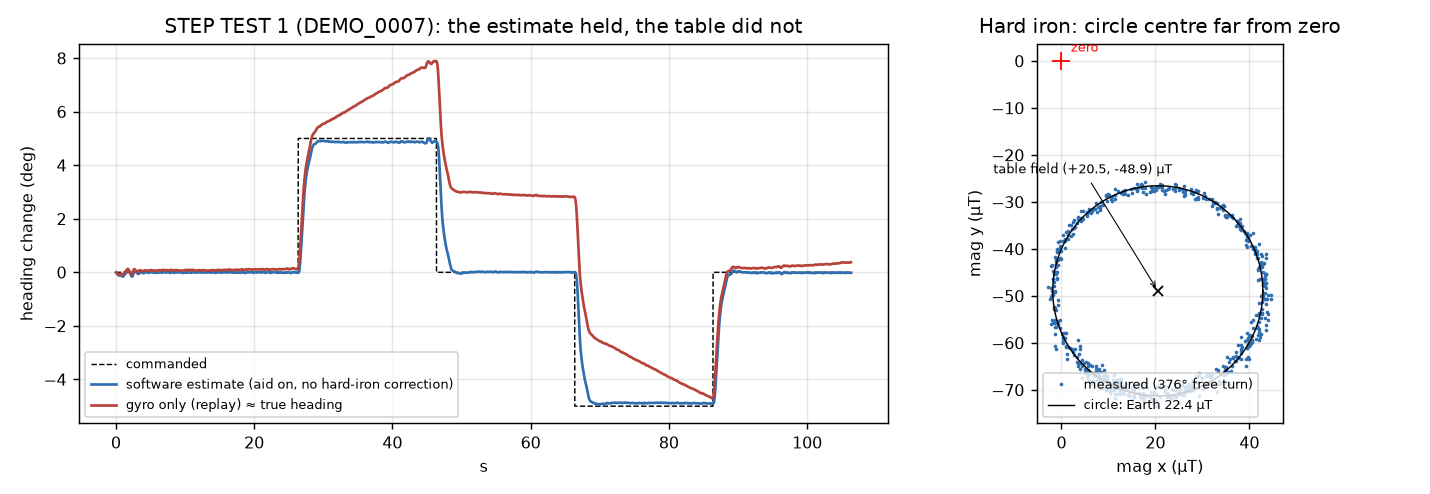
Reports/figures/writeup_2026-10-31/f05_heading_hardiron.png
