derek-weissinger-usafa/Astro-331-Lab-8/Reports/figures/writeup_2026-10-31/f09_fixedtilt_vs_sim.png

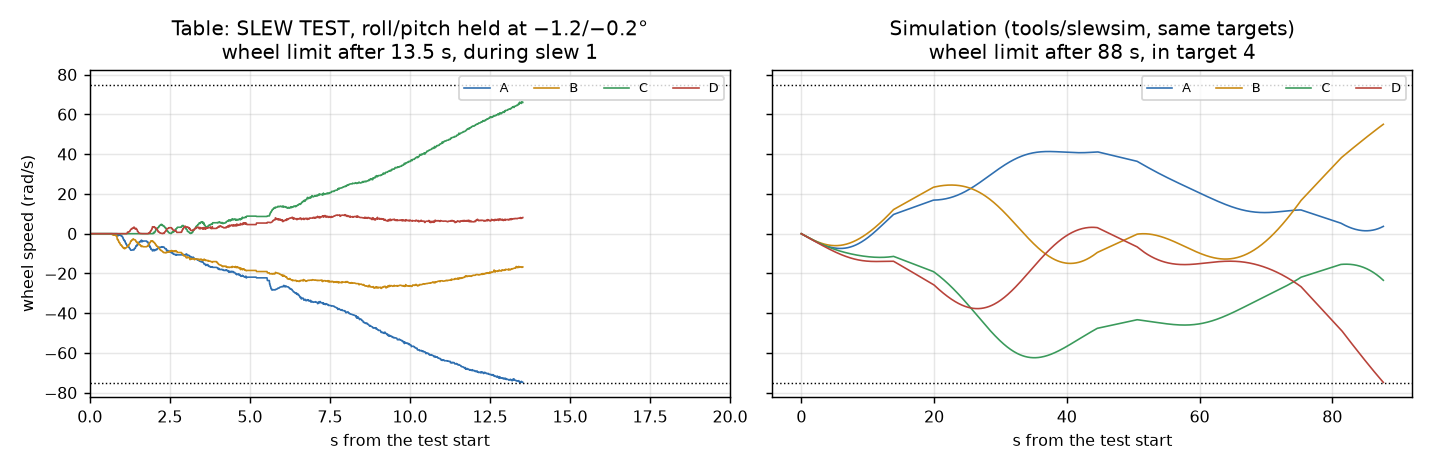
Reports/figures/writeup_2026-10-31/f09_fixedtilt_vs_sim.png
