derek-weissinger-usafa/Astro-331-Lab-8/Reports/figures/writeup_2026-10-31/f10_slewyaw_vs_sim.png

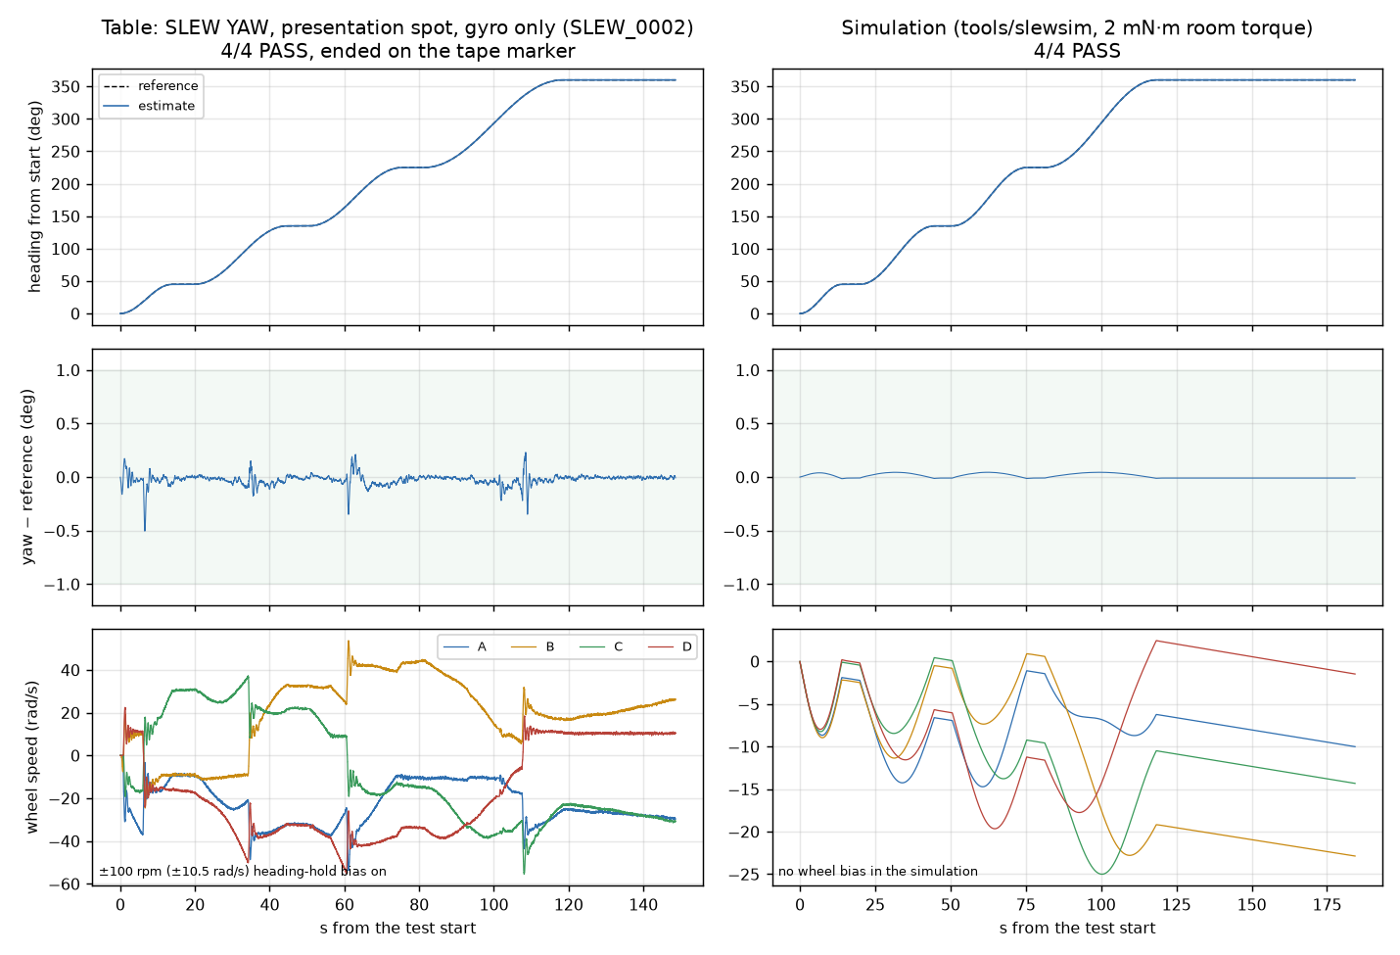
Reports/figures/writeup_2026-10-31/f10_slewyaw_vs_sim.png
