derek-weissinger-usafa/Astro-331-Lab-8/Reports/figures/writeup_2026-10-31/f11_room_distortion.png

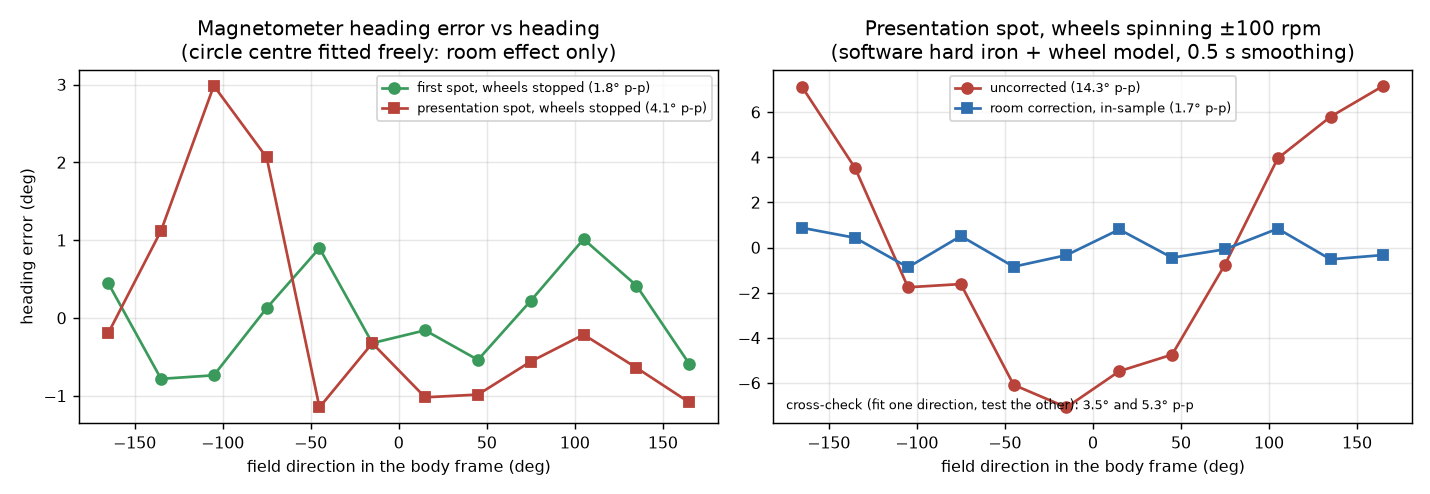
Reports/figures/writeup_2026-10-31/f11_room_distortion.png
