derek-weissinger-usafa/Astro-331-Lab-8/Reports/figures/writeup_2026-10-31/f12_gyroscale.png

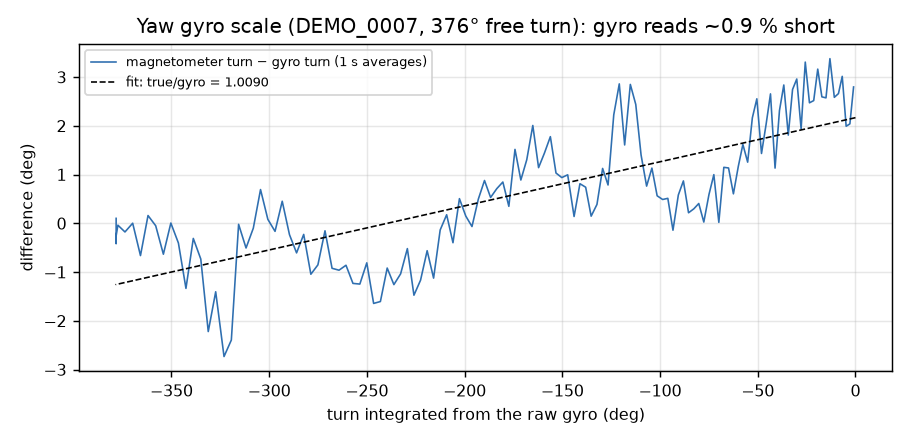
Reports/figures/writeup_2026-10-31/f12_gyroscale.png
