derek-weissinger-usafa/Astro-331-Lab-8/Past Documentation/Air Bearing Table Sphere/CAD/3D Printer/High Bar.stl

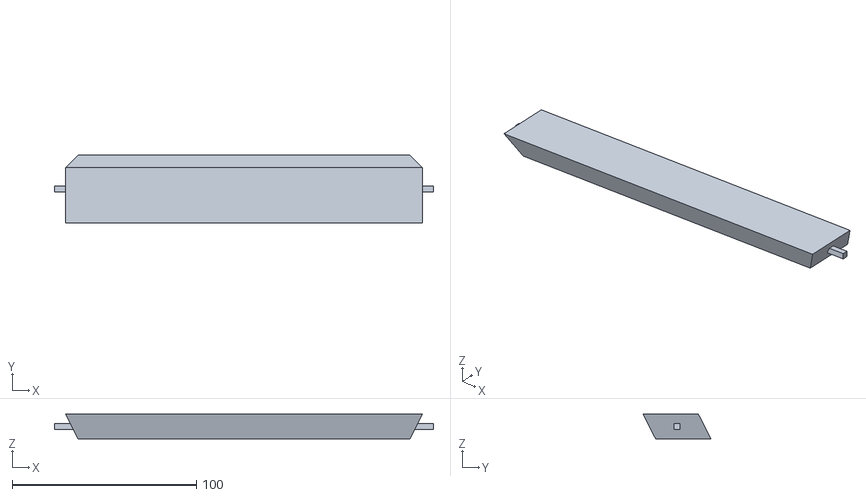
[picture p128: CAD file, 2026-09-30]
Past Documentation/Air Bearing Table Sphere/CAD/3D Printer/High Bar.stl
205.5 x 36.7 x 13.4
