derek-weissinger-usafa/Astro-331-Lab-8/Past Documentation/Air Bearing Table Sphere/Simulink Files/Models/geometry/Carrier.step

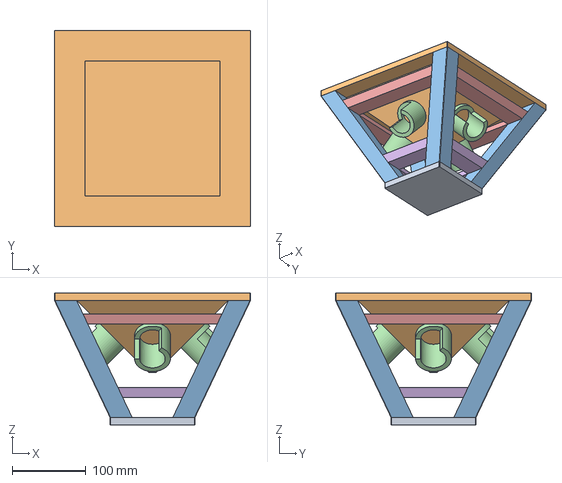
[picture p129: CAD file, 2026-09-30]
Past Documentation/Air Bearing Table Sphere/Simulink Files/Models/geometry/Carrier.step
265.2 x 265.2 x 178.0 mm
