derek-weissinger-usafa/Astro-331-Lab-8/Past Documentation/Air Bearing Table Sphere/CAD/3D Printer/Low Bar.stl

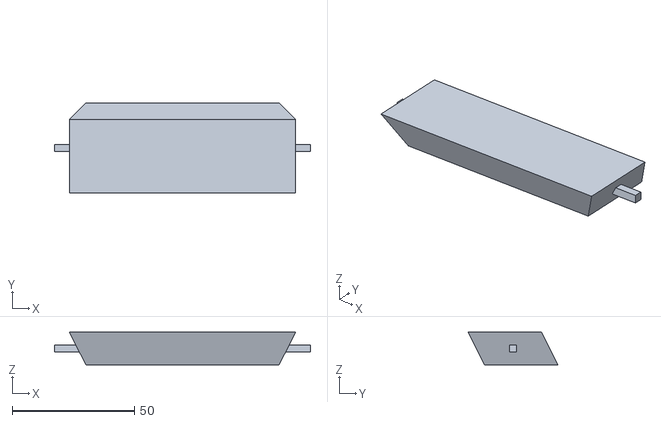
[picture p130: CAD file, 2026-09-30]
Past Documentation/Air Bearing Table Sphere/CAD/3D Printer/Low Bar.stl
104.6 x 36.7 x 13.4
