derek-weissinger-usafa/Astro-331-Lab-8/Past Documentation/Air Bearing Table Sphere/Simulink Files/Models/geometry/Sphere.step

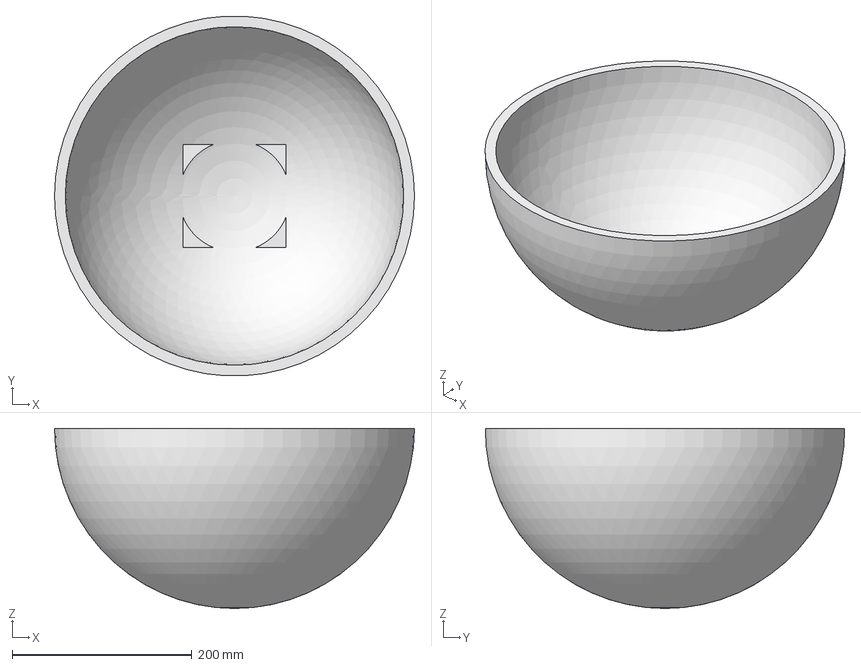
[picture p131: CAD file, 2026-09-30]
Past Documentation/Air Bearing Table Sphere/Simulink Files/Models/geometry/Sphere.step
401.0 x 400.4 x 200.5 mm
