derek-weissinger-usafa/Astro-331-Lab-8/Past Documentation/Air Bearing Table Sphere/CAD/3D Printer/Platform1.stl

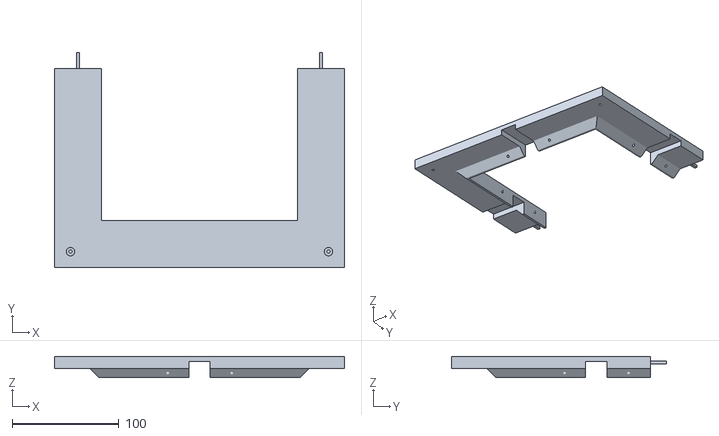
[picture p132: CAD file, 2026-09-30]
Past Documentation/Air Bearing Table Sphere/CAD/3D Printer/Platform1.stl
271.5 x 201.6 x 20.0
