derek-weissinger-usafa/Astro-331-Lab-8/Past Documentation/Air Bearing Table Sphere/Simulink Files/Models/geometry/ReactionWheel.step

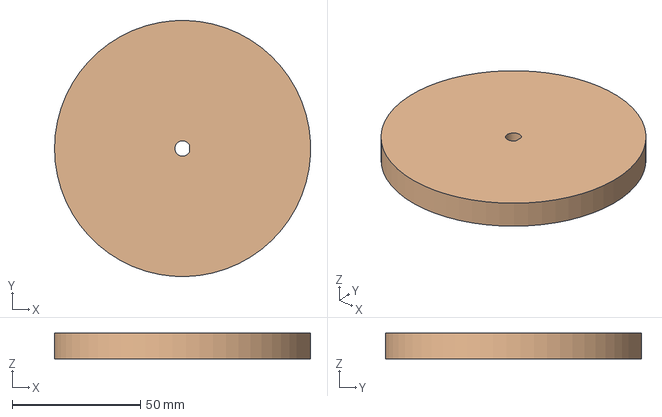
[picture p133: CAD file, 2026-09-30]
Past Documentation/Air Bearing Table Sphere/Simulink Files/Models/geometry/ReactionWheel.step
99.9 x 100.0 x 10.0 mm
