derek-weissinger-usafa/Astro-331-Lab-8/Past Documentation/Air Bearing Table Sphere/CAD/3D Printer/Pyramid.stl

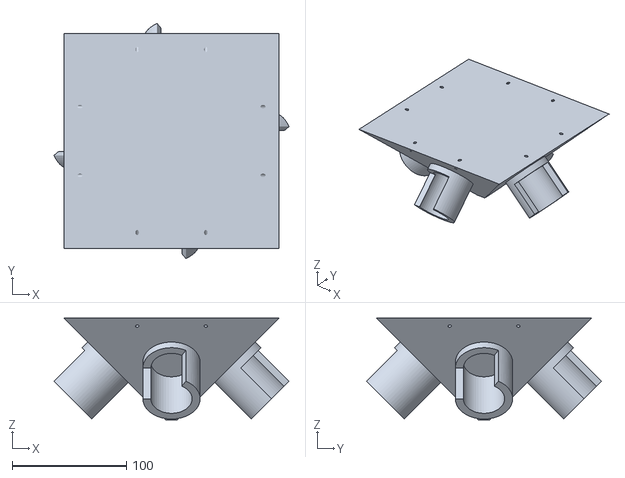
[picture p134: CAD file, 2026-09-30]
Past Documentation/Air Bearing Table Sphere/CAD/3D Printer/Pyramid.stl
205.3 x 205.3 x 89.1
