derek-weissinger-usafa/Astro-331-Lab-8/Past Documentation/Air Bearing Table Sphere/Simulink Files/Models/geometry/Gearmotor_37D_100.step

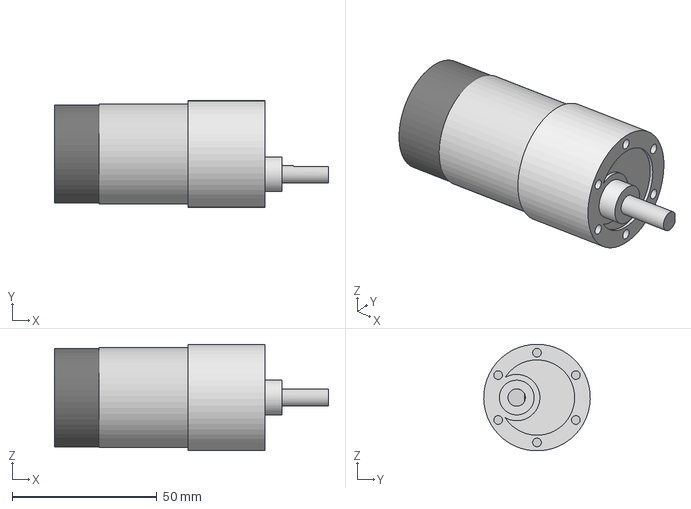
[picture p135: CAD file, 2026-09-30]
Past Documentation/Air Bearing Table Sphere/Simulink Files/Models/geometry/Gearmotor_37D_100.step
94.6 x 36.8 x 36.8 mm
