derek-weissinger-usafa/Astro-331-Lab-8/Past Documentation/Air Bearing Table Sphere/CAD/3D Printer/Platform2.stl

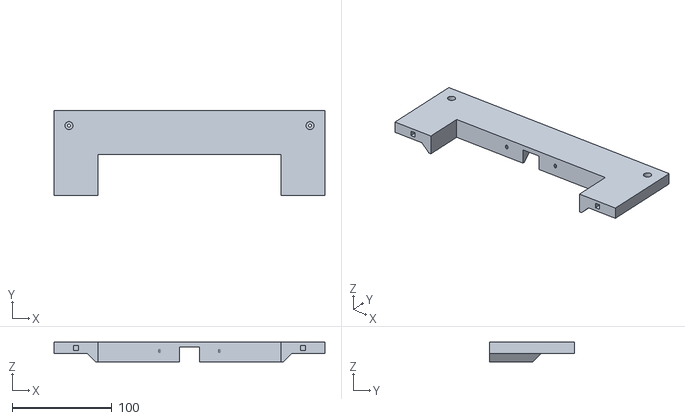
[picture p136: CAD file, 2026-09-30]
Past Documentation/Air Bearing Table Sphere/CAD/3D Printer/Platform2.stl
271.5 x 85.0 x 20.0
