derek-weissinger-usafa/Astro-331-Lab-8/Lab 8 Small Washer Holder 1.3mf

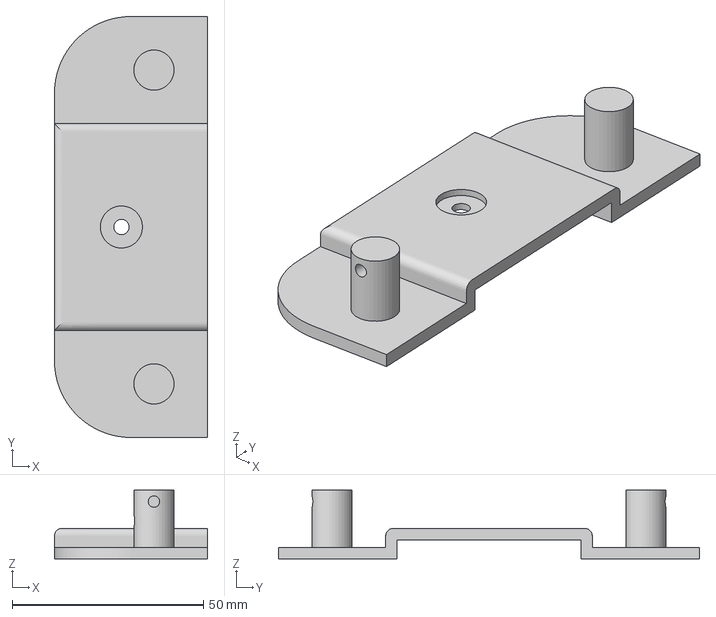
[picture p141: CAD file, 2026-10-29]
Lab 8 Small Washer Holder 1.3mf
40.0 x 110.0 x 18.0 mm
