derek-weissinger-usafa/Astro-331-Lab-8/(list of files, cad)

Other CAD files:
Past Documentation/Air Bearing Table Sphere/CAD/Assembly.f3z
Past Documentation/Air Bearing Table Sphere/CAD/High Bar.f3d
Past Documentation/Air Bearing Table Sphere/CAD/Low Bar.f3d
Past Documentation/Air Bearing Table Sphere/CAD/Pillar.f3d
Past Documentation/CAD files V2/Carrier V6.f3d
Past Documentation/CAD files V2/Motor holder.f3d
Past Documentation/CAD files V2/Mouting hub.f3d
Past Documentation/CAD files V2/ReactionWheel V2.f3d
