derek-weissinger-usafa/Astro-331-Lab-8/power_wiring.html

Astro 331 Lab 8 · Power subsystem · bench sheet

# Motor and logic power wiring

Four 3S Epoch packs (one per wheel), one PKCELL pack for the electronics through a Pololu U3V70F5 5 V boost, a single-pole motor switch on the motor packs' combined negative, and one star ground point.

Before plugging in any pack

1. On every driver, remove the short orange wire that ties VIN to VCC. VIN gets only the pack +, VCC gets only the 5 V rail. Left tied, 12 V reaches the Teensy.
2. Disconnect the drivers from the Teensy's VIN pin. The Teensy VIN is fed only by the U3V70F5 now.
3. Cut the VIN–VUSB trace on the bottom of the Teensy.

## System overview

Pack + (9–12.6 V) 5 V rail Ground / pack − PWM signals ● = connection · lines crossing without a dot do not connect

The orange bundle stands for each driver's own two PWM wires (orange and blue) from the Teensy; they are not shared. The pack + leads never touch each other; only the negatives are joined, and only through the motor switch.

## One driver, pin by pin

Wire all four TB9051FTG carriers the same way. Wheel letter X is A, B, C or D; the table below gives each wheel's Teensy pins.

## Driver pin map

Driver pin | Wire | Goes to
VIN | Pack + (red) | Epoch pack X + only
GND | Ground | Star ground point (its own wire)
OUT1 | Motor red | Gearmotor X
OUT2 | Motor black | Gearmotor X
VCC | 5 V | U3V70F5 VOUT (5 V rail)
PWM1 | Orange | Teensy pin for wheel X (table below)
PWM2 | Blue | Teensy pin for wheel X (table below)
EN | Jumper | VCC (enabled)
ENB | Jumper | GND (enabled)
VM, OCM, DIAG, OCC, logic GND | None | Leave open

## Per-wheel connections

Wheel | Pack → VIN | PWM1 (orange) | PWM2 (blue) | Encoder A (yellow) | Encoder B (white) | Deck spot
A | Epoch pack A | 22 | 23 | 8 | 4 | Corner by driver A
B | Epoch pack B | 14 | 15 | 9 | 5 | Corner by driver B
C | Epoch pack C | 36 | 37 | 10 | 6 | Corner by driver C
D | Epoch pack D | 24 | 25 | 11 | 7 | Corner by driver D

Encoders: blue → Teensy 3.3 V, green → GND, yellow/white → the pins above. They never connect to the driver.

## Rules that keep it safe

- Each pack + goes to one driver's VIN and nothing else. Never join two pack + leads.
- Pack negatives reach ground only through the motor switch.
- Every ground (four driver GNDs, motor switch, Teensy, PKCELL −/boost GND) gets its own wire to the star point.
- Add about 33 µF electrolytic across the U3V70F5's VIN and GND.
- Put a plug on each pack lead so packs come out for charging.

## Power-up order

1. Logic switch on. Wait a few seconds: firmware zeroes the PWM pins up to 3 s after boot.
2. Motor switch on.
3. To shut down: motor switch off, then logic switch off.
