derek-weissinger-usafa/Astro-331-Lab-8/Reports/figures/final_2026-11-02/n1_laser_setup.png

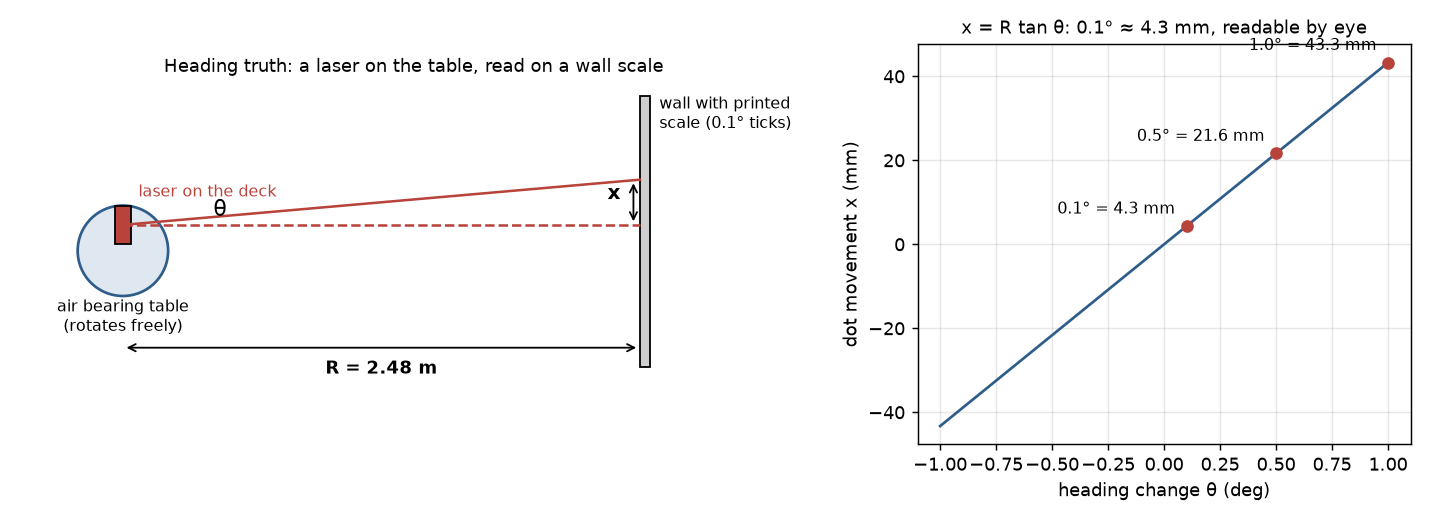
Reports/figures/final_2026-11-02/n1_laser_setup.png
