derek-weissinger-usafa/Astro-331-Lab-8/test_runs/2026-10-15_all4_300rpm_duty_telemetry.csv

host_time_s | line
1792102061.5736742 | 15928,0.99976,-0.02182,0.00281,-0.00025,2.501,-0.322,0.022,0.0536,-0.1175,-0.0330,0.112,0.114,0.541,0,0.0,0.0,0.0,0.0,I,0.000,0.000,0.000,0.000
1792102061.5736742 | S,I,2.5,-0.3,0.0,sig_yaw=0.54,0,0,0,0
1792102061.5736742 | 15978,0.99976,-0.02180,0.00277,-0.00025,2.498,-0.318,0.021,0.0536,-0.1175,-0.0330,0.112,0.114,0.541,0,0.0,0.0,0.0,0.0,I,0.000,0.000,0.000,0.000
1792102061.6767702 | 16038,0.99976,-0.02175,0.00272,-0.00026,2.492,-0.312,0.023,0.0536,-0.1175,-0.0330,0.111,0.114,0.542,0,0.0,0.0,0.0,0.0,I,0.000,0.000,0.000,0.000
1792102061.7405357 | 16088,0.99976,-0.02180,0.00270,-0.00031,2.499,-0.310,0.029,0.0536,-0.1175,-0.0330,0.111,0.114,0.542,0,0.0,0.0,0.0,0.0,I,0.000,0.000,0.000,0.000
1792102061.792238 | 16148,0.99976,-0.02177,0.00269,-0.00030,2.495,-0.309,0.027,0.0536,-0.1175,-0.0330,0.111,0.114,0.542,0,0.0,0.0,0.0,0.0,I,0.000,0.000,0.000,0.000
1792102061.792238 | 16198,0.99976,-0.02181,0.00272,-0.00033,2.500,-0.312,0.031,0.0536,-0.1175,-0.0330,0.111,0.114,0.542,0,0.0,0.0,0.0,0.0,I,0.000,0.000,0.000,0.000
1792102061.8936324 | 16268,0.99976,-0.02186,0.00274,-0.00033,2.505,-0.314,0.031,0.0536,-0.1175,-0.0330,0.111,0.114,0.543,0,0.0,0.0,0.0,0.0,I,0.000,0.000,0.000,0.000
1792102061.9439764 | 16318,0.99976,-0.02187,0.00270,-0.00031,2.506,-0.311,0.029,0.0536,-0.1175,-0.0330,0.111,0.114,0.543,0,0.0,0.0,0.0,0.0,I,0.000,0.000,0.000,0.000
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
1792102070.57258 | 24965,0.99976,-0.02059,0.00225,-0.00762,2.357,-0.276,0.867,0.0555,-0.1166,-0.0331,0.110,0.113,0.582,0,3.6,1.3,6.6,2.7,I,0.000,0.000,0.000,0.000
