derek-weissinger-usafa/Astro-331-Lab-8/test_runs/2026-10-15_all4_300rpm_telemetry.csv

host_time_s | line
1792101567.1701965 | S,I,2.5,-0.3,9.9,sig_yaw=12.71,0,-0,0,-0
1792101567.1701965 | 1652295,0.99603,-0.02201,0.00081,-0.08630,2.505,-0.311,9.898,0.0586,-0.1156,-0.0182,0.130,0.566,12.707,0,0.0,-0.0,0.0,-0.0,I
1792101567.222423 | 1652355,0.99603,-0.02204,0.00082,-0.08628,2.508,-0.312,9.895,0.0586,-0.1156,-0.0182,0.130,0.567,12.708,0,0.0,-0.0,0.0,-0.0,I
1792101567.2868726 | 1652405,0.99603,-0.02205,0.00084,-0.08625,2.510,-0.314,9.892,0.0586,-0.1156,-0.0182,0.130,0.567,12.708,0,0.0,-0.0,0.0,-0.0,I
1792101567.3382943 | 1652474,0.99603,-0.02199,0.00083,-0.08623,2.503,-0.312,9.889,0.0587,-0.1156,-0.0182,0.130,0.566,12.709,0,0.0,-0.0,0.0,-0.0,I
1792101567.3899522 | 1652537,0.99603,-0.02200,0.00083,-0.08624,2.503,-0.312,9.891,0.0586,-0.1156,-0.0182,0.130,0.566,12.710,0,0.0,-0.0,0.0,-0.0,I
1792101567.5051067 | 1652593,0.99603,-0.02195,0.00082,-0.08625,2.498,-0.310,9.891,0.0587,-0.1156,-0.0182,0.130,0.565,12.711,0,0.0,-0.0,0.0,-0.0,I
1792101567.5051067 | 1652654,0.99603,-0.02196,0.00084,-0.08624,2.499,-0.313,9.890,0.0587,-0.1156,-0.0182,0.130,0.566,12.712,0,0.0,-0.0,0.0,-0.0,I
1792101567.5573032 | 1652705,0.99604,-0.02191,0.00083,-0.08619,2.493,-0.311,9.885,0.0587,-0.1156,-0.0182,0.130,0.565,12.713,0,0.0,-0.0,0.0,-0.0,I
1792101567.6602767 | 1652764,0.99604,-0.02187,0.00088,-0.08613,2.489,-0.316,9.877,0.0587,-0.1156,-0.0182,0.130,0.564,12.714,0,0.0,-0.0,0.0,-0.0,I
1792101567.6602767 | # MANUAL rpm A=300 B=300 C=300 D=300
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
1792101576.0850503 | 1661221,0.99159,-0.02119,-0.00078,-0.12770,2.420,-0.221,14.672,0.0595,-0.1170,-0.0217,0.133,0.552,12.722,0,5.9,2.8,8.3,3.9,I
1792101576.1491525 | 1661281,0.99189,-0.02116,-0.00059,-0.12530,2.414,-0.237,14.394,0.0596,-0.1169,-0.0214,0.133,0.552,12.716,0,2.5,1.8,6.8,2.5,I
