derek-weissinger-usafa/Astro-331-Lab-8/test_runs/2026-10-15_handturn_B_telemetry.csv

host_time_s | line
1792103319.9622748 | 1274110,0.89538,-0.01562,0.01037,0.44491,2.132,-0.268,-52.850,0.0656,-0.0922,-0.0506,0.111,0.194,4.334,0,-0.0,-1.6,0.0,0.0,I,0.000,0.000,0.000,0.000
1792103319.9622748 | 1274160,0.89540,-0.01555,0.01053,0.44487,2.133,-0.287,-52.846,0.0656,-0.0921,-0.0506,0.111,0.194,4.334,0,-0.0,-2.0,0.0,0.0,I,0.000,0.000,0.000,0.000
1792103319.9622748 | 1274219,0.89537,-0.01561,0.01046,0.44493,2.135,-0.277,-52.853,0.0656,-0.0922,-0.0506,0.111,0.195,4.334,0,-0.0,-2.4,0.0,0.0,I,0.000,0.000,0.000,0.000
1792103319.9622748 | 1274269,0.89533,-0.01545,0.01046,0.44502,2.119,-0.285,-52.864,0.0658,-0.0921,-0.0506,0.112,0.195,4.335,0,-0.0,-2.6,0.0,0.0,I,0.000,0.000,0.000,0.000
1792103320.1659858 | 1274329,0.89540,-0.01565,0.01030,0.44487,2.132,-0.259,-52.845,0.0656,-0.0923,-0.0506,0.111,0.195,4.335,0,-0.0,-2.1,0.0,0.0,I,0.000,0.000,0.000,0.000
1792103320.1659858 | 1274379,0.89532,-0.01543,0.01044,0.44504,2.116,-0.285,-52.867,0.0658,-0.0921,-0.0506,0.111,0.195,4.335,0,-0.0,-1.7,0.0,0.0,I,0.000,0.000,0.000,0.000
1792103320.1659858 | 1274449,0.89532,-0.01529,0.01044,0.44504,2.101,-0.291,-52.868,0.0660,-0.0921,-0.0506,0.112,0.195,4.336,0,-0.0,-0.8,0.0,0.0,I,0.000,0.000,0.000,0.000
1792103320.3686194 | 1274499,0.89534,-0.01535,0.01038,0.44499,2.105,-0.282,-52.861,0.0660,-0.0922,-0.0506,0.112,0.195,4.336,0,-0.0,-1.4,0.0,0.0,I,0.000,0.000,0.000,0.000
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
1792103358.6509206 | 1312818,0.90091,-0.01616,0.01127,0.43357,2.229,-0.360,-51.406,0.0633,-0.0955,-0.0505,0.115,0.204,4.454,0,-0.0,-0.0,0.0,0.0,I,0.000,0.000,0.000,0.000
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
