derek-weissinger-usafa/Astro-331-Lab-8/test_runs/2026-10-15_handturn_C_telemetry.csv

host_time_s | line
1792103082.5303197 | 1036693,0.96560,-0.02172,-0.00214,-0.25911,2.468,-0.408,30.033,0.0593,-0.1168,-0.0326,0.137,0.545,12.372,0,-0.0,-0.0,3.1,0.0,I,0.000,0.000,0.000,0.000
1792103082.5310018 | 1036743,0.96563,-0.02172,-0.00207,-0.25902,2.466,-0.415,30.022,0.0593,-0.1168,-0.0326,0.137,0.544,12.373,0,-0.0,-0.0,2.1,0.0,I,0.000,0.000,0.000,0.000
1792103082.5310018 | 1036813,0.96571,-0.02172,-0.00218,-0.25870,2.469,-0.403,29.984,0.0592,-0.1169,-0.0325,0.137,0.543,12.373,0,-0.0,-0.0,1.0,0.0,I,0.000,0.000,0.000,0.000
1792103082.5310018 | 1036864,0.96573,-0.02164,-0.00233,-0.25863,2.464,-0.383,29.977,0.0593,-0.1170,-0.0325,0.135,0.543,12.374,0,-0.0,-0.0,-0.2,0.0,I,0.000,0.000,0.000,0.000
1792103082.7325537 | 1036922,0.96571,-0.02184,-0.00207,-0.25869,2.479,-0.418,29.983,0.0593,-0.1169,-0.0325,0.139,0.547,12.375,0,-0.0,-0.0,-0.0,0.0,I,0.000,0.000,0.000,0.000
1792103082.7325537 | 1036972,0.96569,-0.02174,-0.00228,-0.25878,2.474,-0.392,29.994,0.0593,-0.1169,-0.0325,0.136,0.546,12.376,0,-0.0,-0.0,-0.0,0.0,I,0.000,0.000,0.000,0.000
1792103082.7325537 | 1037022,0.96570,-0.02180,-0.00222,-0.25874,2.480,-0.401,29.989,0.0593,-0.1169,-0.0325,0.137,0.546,12.376,0,-0.0,-0.0,0.3,0.0,I,0.000,0.000,0.000,0.000
1792103082.9473648 | 1037072,0.96565,-0.02181,-0.00230,-0.25890,2.482,-0.393,30.009,0.0593,-0.1169,-0.0325,0.136,0.547,12.377,0,-0.0,-0.0,1.4,0.0,I,0.000,0.000,0.000,0.000
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
1792103120.6209831 | 1074801,0.96742,-0.02193,-0.00180,-0.25223,2.485,-0.434,29.216,0.0579,-0.1145,-0.0309,0.146,0.560,12.638,0,-0.0,-0.0,0.0,0.0,I,0.000,0.000,0.000,0.000
1792103120.6209831 | 1074851,0.96742,-0.02187,-0.00179,-0.25224,2.477,-0.433,29.218,0.0579,-0.1145,-0.0309,0.146,0.558,12.639,0,-0.0,-0.0,0.0,0.0,I,0.000,0.000,0.000,0.000
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
