derek-weissinger-usafa/Astro-331-Lab-8/test_runs/2026-10-15_single_A_300rpm_telemetry.csv

host_time_s | line
1792102609.8759446 | S,I,2.5,-0.4,18.3,sig_yaw=6.43,-0,0,0,0
1792102609.8759446 | 564188,0.98700,-0.02202,-0.00030,-0.15923,2.497,-0.368,18.321,0.0601,-0.1159,-0.0334,0.117,0.301,6.430,0,-0.0,0.0,0.0,0.0,I,0.000,0.000,0.000,0.000
1792102609.9291937 | 564246,0.98700,-0.02204,-0.00031,-0.15923,2.499,-0.367,18.321,0.0601,-0.1159,-0.0334,0.117,0.301,6.431,0,-0.0,0.0,0.0,0.0,I,0.000,0.000,0.000,0.000
1792102609.9920871 | 564298,0.98699,-0.02204,-0.00032,-0.15925,2.500,-0.367,18.324,0.0601,-0.1159,-0.0334,0.117,0.301,6.431,0,-0.0,0.0,0.0,0.0,I,0.000,0.000,0.000,0.000
1792102609.9920871 | 564348,0.98699,-0.02205,-0.00031,-0.15928,2.501,-0.367,18.326,0.0601,-0.1158,-0.0334,0.117,0.301,6.432,0,-0.0,0.0,0.0,0.0,I,0.000,0.000,0.000,0.000
1792102610.0436418 | 564398,0.98699,-0.02206,-0.00027,-0.15924,2.501,-0.372,18.322,0.0601,-0.1158,-0.0334,0.117,0.301,6.433,0,-0.0,0.0,0.0,0.0,I,0.000,0.000,0.000,0.000
1792102610.107493 | 564448,0.98699,-0.02208,-0.00030,-0.15925,2.504,-0.369,18.323,0.0601,-0.1159,-0.0334,0.117,0.302,6.434,0,-0.0,0.0,0.0,0.0,I,0.000,0.000,0.000,0.000
1792102610.1617064 | 564508,0.98699,-0.02212,-0.00030,-0.15925,2.508,-0.369,18.323,0.0601,-0.1158,-0.0334,0.117,0.302,6.434,0,-0.0,0.0,0.0,0.0,I,0.000,0.000,0.000,0.000
1792102610.2268167 | 564558,0.98699,-0.02211,-0.00029,-0.15927,2.507,-0.370,18.325,0.0601,-0.1158,-0.0334,0.117,0.302,6.435,0,-0.0,0.0,0.0,0.0,I,0.000,0.000,0.000,0.000
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
1792102611.1274483 | 565448,0.98699,-0.02195,-0.00043,-0.15929,2.492,-0.352,18.328,0.0604,-0.1159,-0.0334,0.116,0.304,6.447,0,6.9,0.0,0.0,0.0,M,0.239,0.000,0.000,0.000
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
