derek-weissinger-usafa/Astro-331-Lab-8/Reports/figures/fig8_motor_bringup.png

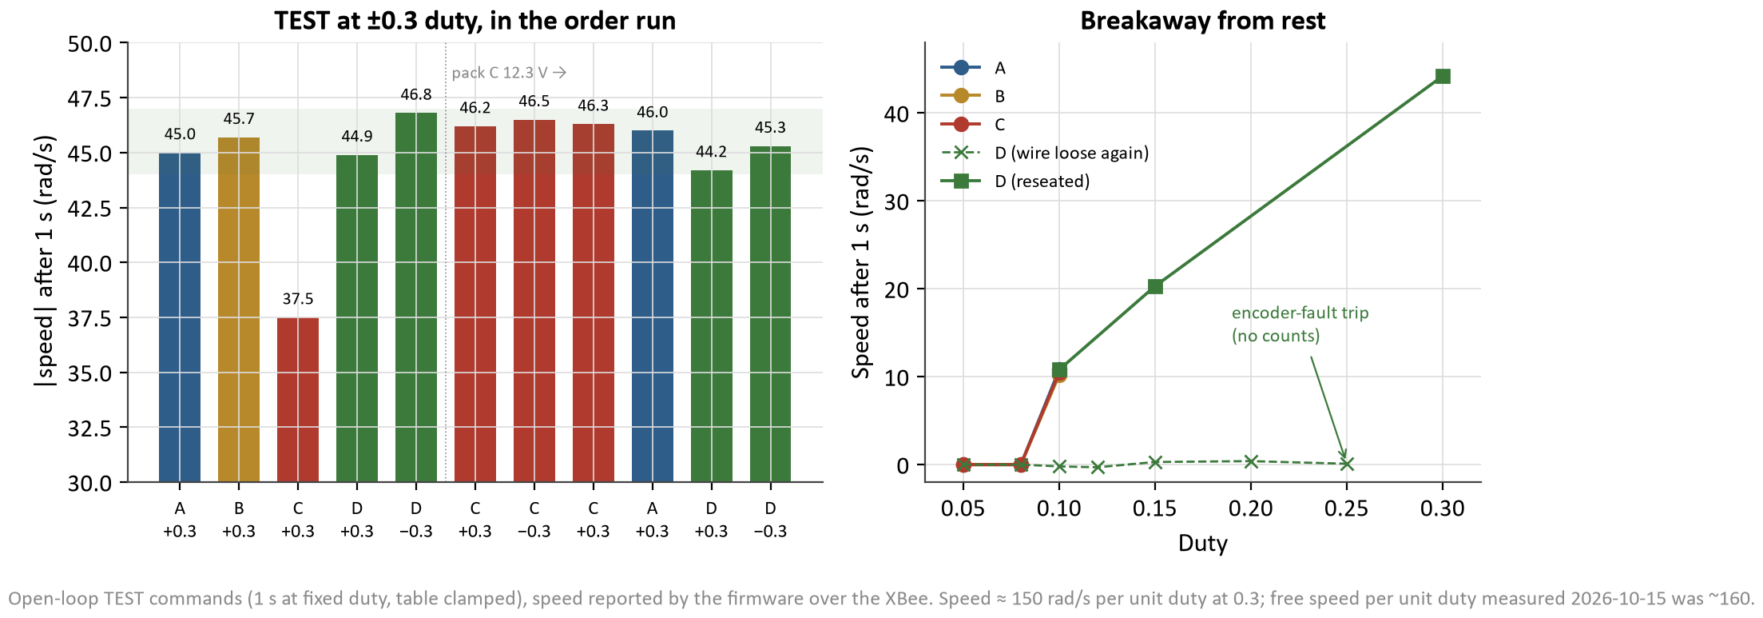
Reports/figures/fig8_motor_bringup.png
