derek-weissinger-usafa/Astro-331-Lab-8/Reports/figures/sim1_ekf_verification.png

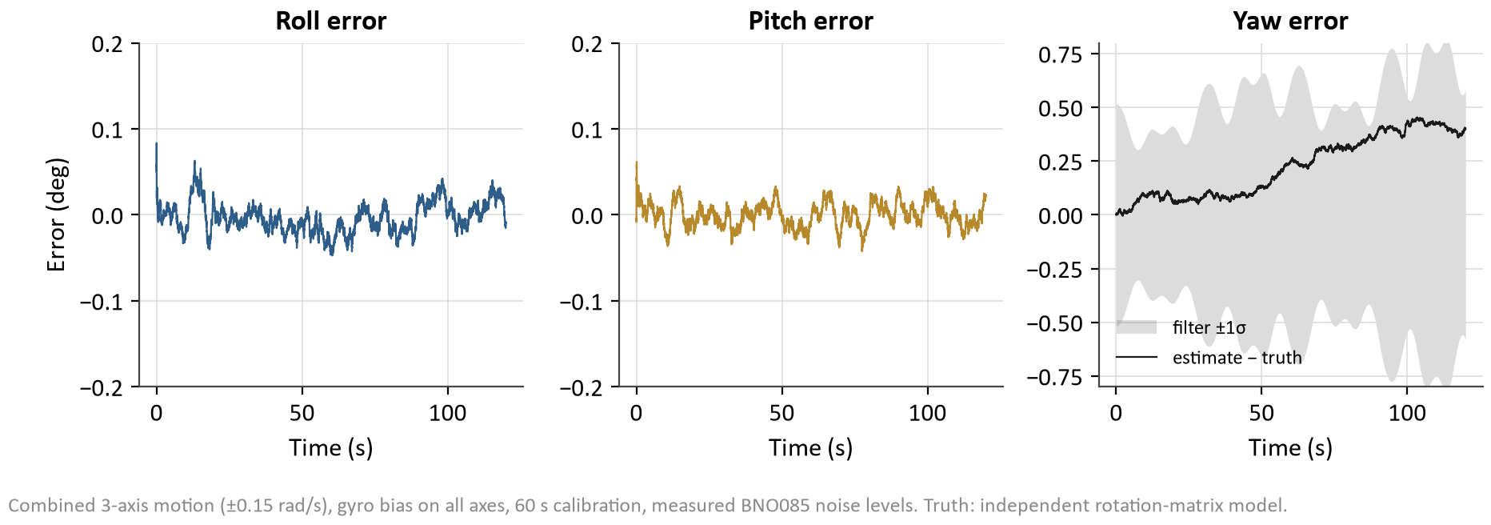
Reports/figures/sim1_ekf_verification.png
