derek-weissinger-usafa/Astro-331-Lab-8/Reports/figures/sim2_yaw_drift_calibration.png

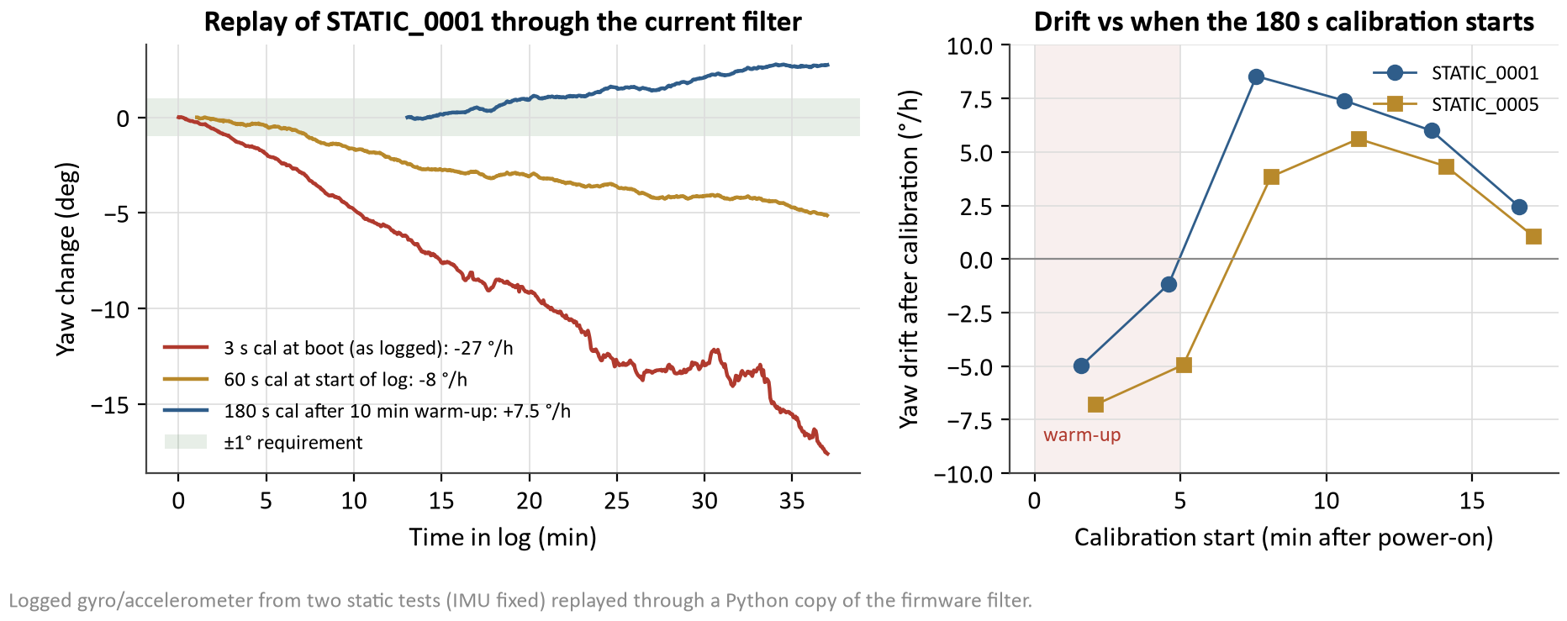
Reports/figures/sim2_yaw_drift_calibration.png
