derek-weissinger-usafa/Astro-331-Lab-8/Reports/figures/sim7_slew_test.png

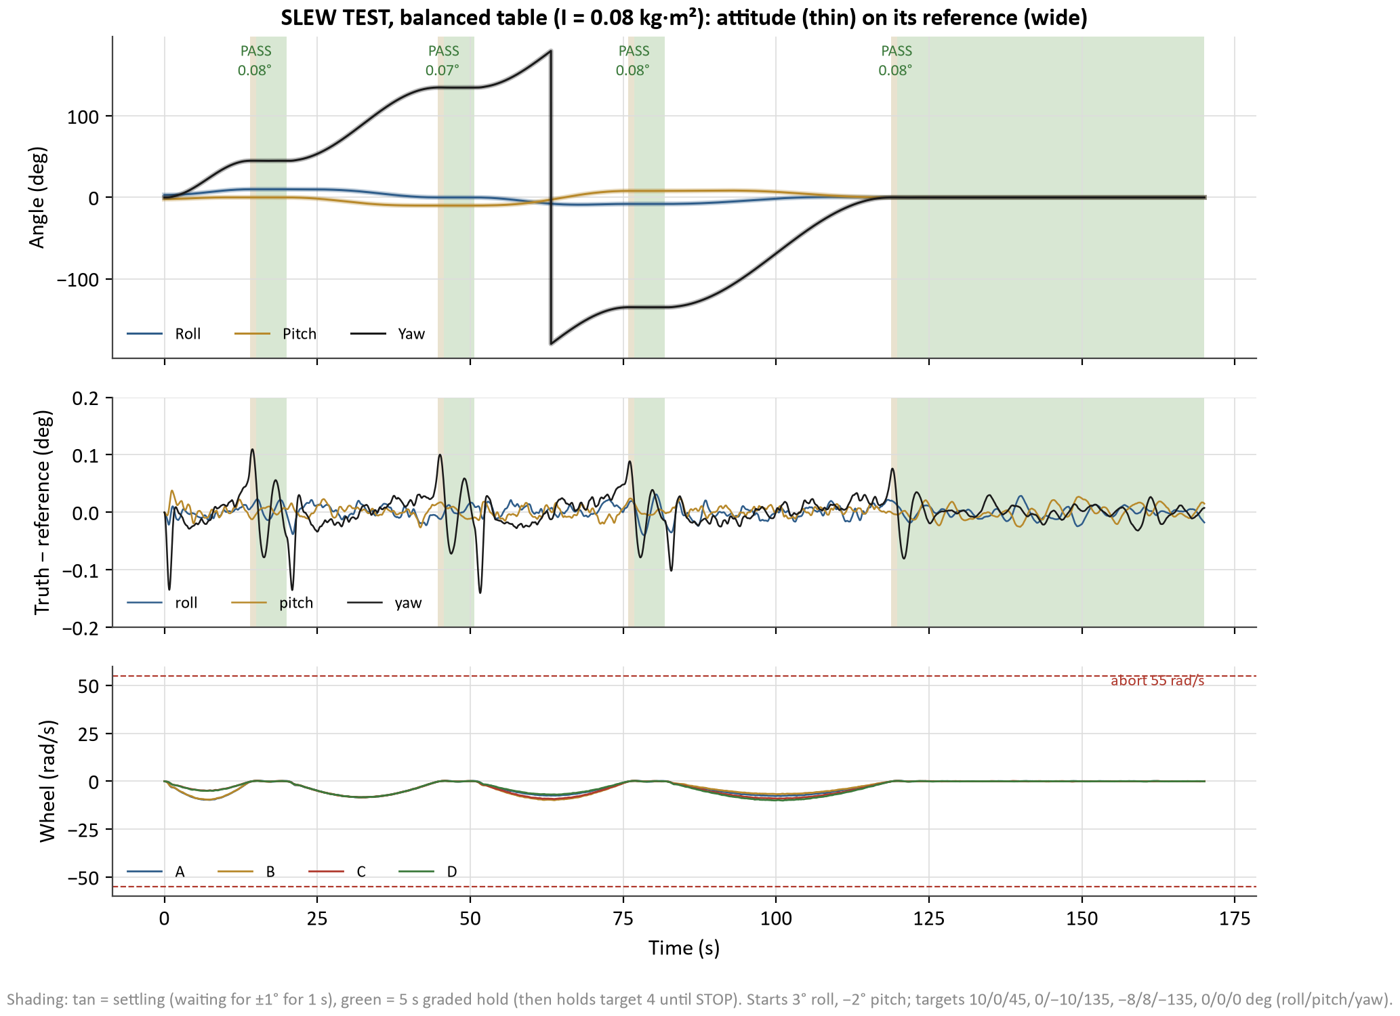
Reports/figures/sim7_slew_test.png
