derek-weissinger-usafa/Astro-331-Lab-8/PROGRESS_LOG.md

# Lab 8 progress log

Running record of what has been built, tested and found, for the team and for the progress
reports. Newest work is at the bottom of §2. Firmware details and commands live in `CLAUDE.md`,
the prioritised to-do list in `TODO.md`, and the 2026-10-15 bench notes in `HANDOFF_2026-10-15.md`.
Data and analysis pages are in `test_runs/` (index in §5).

Last updated 2026-10-21.

---

## 1. Status against the requirements

| Requirement | Status |
|---|---|
| 1. Hold a heading, no jitter or drift | Controller written and simulated; **not yet run closed-loop on the table**. Blocked by the gravity finding in §2.7: the table is bottom-heavy and rests ~3° off level, so the wheels can only hold level for ~1 s. Heading (yaw) has no gravity torque and is not blocked. |
| 2. Attitude to ±1° in all axes | Roll/pitch: accelerometer-aided EKF, well within ±1° when static. Yaw: gyro-only (magnetometer excluded), drift ~3 °/h after warm-up + 180 s calibration (replay). IMU data path now reliable (§2.8). |
| 3. Detect and compensate a wheel failure | `FAULT TEST` first draft (§2.14): dead-motor detection, 3-wheel control, graded test. Simulated 9/9 PASS; not yet run on the table. |
| Stretch: 4-attitude slew | `SLEW TEST` firmware first draft (§2.13): build-verified and simulated, not yet run on the table. |

---

## 2. Work completed (chronological)

### 2.1 Project setup and hardware identification (2026-09-29 → 10-02)
- PlatformIO project for the **Teensy 4.1**; `CLAUDE.md` documents hardware, pins, wiring, build steps.
- Identified the real hardware: Teensy 4.1, Adafruit **BNO085** IMU (I2C, STEMMA QT), Digi **XBee 3** radio,
  4× Pololu 37D gearmotors with TB9051FTG drivers. The past student's documentation (Arduino MKR1000,
  ICM-20948/MPU-6050, Simulink over Wi-Fi) is **outdated hardware**; it is used only for dynamics and
  motor-characterisation reference.
- Owen transcribed and confirmed the Teensy pin assignments (`teensy_pin_out.pdf`, `include/pins.h`).

### 2.2 Attitude determination (2026-10-02)
- **Multiplicative EKF** (`src/attitude_ekf.cpp`): 6-state error (attitude + gyro bias), gyro propagation,
  accelerometer update with magnitude gating. Frame: body z up, right-handed; x = roll, y = pitch, z = yaw.
- **Magnetometer deliberately excluded** (motor interference), so yaw is relative to power-on and drifts at
  the residual gyro-z bias. Magnetometer is logged for analysis only.

### 2.3 Power system and controller (2026-10-06 → 10-13)
- Owen: power plan and wiring (four 3S Epoch 18650 motor packs, one per wheel; separate PKCELL logic pack with
  a U3V70F5 5 V boost, verified 5.09 V; low-side motor switch; star ground; bench sheet `power_wiring.html`).
- **Attitude controller** (`src/attitude_ctrl.cpp`): quaternion PD with trajectory feed-forward and gyroscopic
  compensation. **Wheel geometry/allocation** (`include/wheel_geometry.h`): 4-wheel pyramid at 45°,
  minimum-norm allocation over the enabled wheels plus a null-mode speed term.
- **Wheel speed loop** (`src/wheel_motor.cpp`): encoder speed + 100 Hz PI, duty cap, slew limit, and a
  back-EMF current limit (no current sensor).
- **Data logger** (`src/data_logger.cpp`): CSV rows to SD and XBee. Found and fixed a silent bug: the
  Teensy's Serial8 TX buffer is 40 bytes, so every XBee line longer than that was dropped
  (`addMemoryForWrite`).
- Owen: encoder pins corrected to the as-built wiring, encoder signs, `SPEED` manual closed-loop mode with
  ramping and low-pass.

### 2.4 Bench session (2026-10-15) — see `HANDOFF_2026-10-15.md`
- **Gear ratio is 6.3:1, not 10:1** (gearbox labels + hand-turn `COUNTS`: ~400 counts per wheel turn).
  Wheel speeds logged before this fix read **1.6× low**.
- Measured free speed ~160–167 rad/s per unit duty at 12 V; speed-loop gains rescaled; 12 V settings.
- Added `COUNTS`/`ZERO` commands, duty telemetry, bench scripts (`tools/speed_sweep.py`, `tools/wheel_hold.py`).
- Findings: B and D healthy; **wheel A rubs** and its pack is ~1 V low; **wheel C** needs high duty and
  oscillates (cause still unknown).

### 2.5 Static IMU test #1 (2026-10-15) — `test_runs/STATIC_0001_analysis.html`
- `BEGIN STATIC TEST` SD logging added.
- **Yaw drift −27 °/h** with the original 3 s gyro calibration → calibration lengthened to **60 s**
  (`CALIBRATE [s]` added).
- Gyro z noise (Allan variance): ARW 2.17e-4 rad/s/√Hz, bias-instability floor ~2 °/h.
- Discovered **IMU sample loss**: ~1/3 of gyro samples missing and 38 freezes > 100 ms (fixed in §2.8).
- Accelerometer magnitude reads 0.981 g (small scale error; harmless, the filter only uses direction).

### 2.6 Motors-on static test and magnetometer map (2026-10-16)
- `test_runs/STATIC_motors_off_vs_on_analysis.html`: the BNO085 **z-gyro bias shifts ~0.007 °/s (~25 °/h of yaw)
  over the first ~5 min after power-on**. Procedure for yaw-sensitive runs: power on, wait ~10 min, `CALIBRATE 180`.
  EKF bias tuning tightened and the z bias locked to the calibration → replay drift **~3 °/h**.
- `MAG MAP` test (`test_runs/MAGMAP_0001_analysis.html`): spinning motors add fast (filterable) magnetometer noise;
  a **stopped** wheel leaves a static offset that depends on where its shaft stops (up to ~5 µT ≈ 5° of heading per
  wheel, ~9 µT for all four); vibration resonance near 50 rpm.
- `DEMO SPIN` (level, then spin about +z) now holds a **100 rpm null-mode wheel bias** so no shaft sits still.

### 2.7 First `DEMO SPIN` on the air bearing (2026-10-16) — `test_runs/DEMO_0001.CSV`
- Three attempts, each stopped by `DEMO_WHEEL_LIMIT` within 1–2 s of the levelling phase.
- **Root cause: the table is a pendulum.** When left alone it rocks in roll/pitch with a ~1.8 s period
  (ωn ≈ 3.3–3.5 rad/s, almost undamped), about a resting tilt of ~3° roll / 1–2° pitch. The centre of mass is
  below the bearing's centre of rotation and slightly off to one side.
  - Gravity stiffness ≈ I·ωn² ≈ **0.9 N·m/rad (~16 mN·m per degree)**. Holding level 3° from rest needs ~50 mN·m;
    the wheels store only ~24 mN·m·s about x, so they fill in ~0.5 s. The controller stiffness (0.25 N·m/rad) is
    weaker than gravity.
  - A pendulum + momentum fit of attempts 2–3 **verified the wheel geometry and signs** on all three axes and gave
    inertia estimates of **0.045–0.13 kg·m² (x/y)** and **0.074–0.082 kg·m² (z)** vs the 0.0623 model.
  - Attempt 1: the table did not respond at all (perfectly still for 35 s, no yaw drift), unlike every later
    idle period — it was probably held or not floating.
- Proposed fixes, **deferred by the team**: trim the balance so the resting attitude is level; change `DEMO SPIN`
  to hold the natural resting tilt (wheels only damp the swing) and spin about the true vertical; add a `BALANCE`
  command that reports the resting tilt and gravity torque for trimming.

### 2.8 IMU reliability: INT/RST wiring and sample-loss fixes (2026-10-20)
Wiring: BNO085 **INT → Teensy pin 20, RST → pin 21**. (During the work a loose ground left the breakout
unpowered; symptom: green LED blinking, nothing on the I2C bus.)

| Test | Gyro samples lost | Longest gap | Gaps > 100 ms |
|---|---|---|---|
| STATIC_0001 (before) | ~33% | 330 ms | 38 |
| SD logging on, first INT build | 102 in ~5 min | — (lat 40 ms) | — |
| + IMU serviced in `yield()` | 12 in ~5 min | — (lat 43 ms) | — |
| STATIC_0008 (+ SD DMA mode) | 370 (1.0%), 314 of them from 2 chip resets | 800 ms | 3 |
| **STATIC_0009 (current)** | **25 of ~29,250 (0.085%)** | **90 ms** | **0** |

What changed (`src/imu_bno085.cpp`, `src/main.cpp`, `src/data_logger.cpp`):
1. **Library bug (the main cause of the old ~1/3 loss):** Adafruit's `getSensorEvent()` keeps only the last
   report of each I2C transfer, and the BNO085 packs gyro + accel + mag into one transfer, so gyro reports were
   overwritten. The driver now registers its own SH2 callback and queues every report.
2. **RST:** the firmware hardware-resets the IMU before every start. Uploads no longer need a power cycle.
3. **INT:** the IMU is read when INT falls (edge captured in an interrupt), with a 5 ms backup poll.
   **INT must be a plain input** — with the Teensy's internal pull-up the line never read low and the chip sent
   nothing. Each sample is timestamped from the INT edge plus the chip's own report delay.
4. **SD stalls:** SD writes blocked `loop()` for up to ~40 ms. The firmware now reads the IMU inside `yield()`
   (which the SD driver calls while waiting), the SD card runs in **DMA mode** (FIFO mode busy-waits without
   yielding), and the logger skips a write while the card is busy.
5. **Remaining gaps are inside the BNO085:** 60–90 ms output stalls in pairs ~22.4 s apart, repeating every
   ~132 s (same pattern in STATIC_0008 and 0009). Disabling the chip's own calibration and calibration saves did
   not remove them; cause unknown. They are below the 100 ms IMU timeout, so they don't disarm the wheels.
6. **EKF across gaps:** the filter used to skip any gyro interval > 50 ms, losing the rotation during a stall
   (~3° of yaw per stall while spinning at 0.55 rad/s). It now integrates gaps up to the 100 ms IMU timeout.
7. **Diagnostics:** `STATUS` reports `miss` (lost samples), `lat` (worst INT-to-read delay, ms), `int`, `svc`,
   `ev`, `rst` (chip resets; 1 = the boot reset), `en`. If the IMU is missing at boot the firmware retries every
   second and prints which I2C addresses answered.

### 2.9 Preliminary data review deck (2026-10-21)
- `Reports/Astro 331 Lab 8_2_3 Body Problem_Prelim_Pres_FILLED.pptx`: 16 slides built on the team template
  (requirements verification table, theory, build progress, 5 data slides with Measure/Compare/Explain/Next,
  future plans, GenAI documentation). Figures and diagrams are in `Reports/figures/` for reuse in the final report.
- To confirm before submitting: slide 4 pass criteria (proposed thresholds), slide 16 GenAI format, Gowri's
  contributions, "2025 Fall" in the slide master, and adding a hardware photo.

### 2.10 DEMO SPIN after balancing, and DEMO LEVEL (2026-10-21)
- The team added balance weights. `test_runs/DEMO_0002.CSV`: six DEMO SPIN attempts. Every one stayed in the
  Level phase (the spin never started) and stopped when wheel A reached the 55 rad/s limit, 2.2–3.7 s after ARM.
- Roll came down from 4–7° to ~1–2° in ~1.3 s (looked level) but settled at ~2°, outside the ±1° needed to start
  the spin. Holding 2° takes ~8 mN·m against gravity, which fills wheel A in ~3 s; the stop then brakes the wheels
  and kicks the table (~8° roll swing).
- The weights worked on pitch and stiffness: free-swing period 1.8 → 3.3 s (gravity's pull ~3× weaker), resting
  pitch ≈ −0.3°. Roll still rests ≈ 3.3° (−y side heavy). Next: trim roll toward +y.
- New **`DEMO LEVEL`** command: level, then hold level with no spin and no wheel bias until STOP / wheel limit;
  reports the hold time. Prelim deck: new slide 14 "Data: DEMO SPIN After Balancing" (`Reports/figures/fig6_demo2_balanced.png`).

### 2.11 DEMO LEVEL tests after the roll trim — `test_runs/DEMO_LEVEL_analysis.html`
- `test_runs/DEMO_0003_OLD.CSV` (saved on the SD card as DEMO_0002; renamed 2026-10-31): five `DEMO LEVEL` runs. All reached level
  (±1° for 3 s) 5–6 s after the command and held steadily (roll/pitch σ ≤ 0.07°, heading within 0.5°) for
  2.0, 5.4, 7.0, 6.9 and **15.8 s** (20.8 s armed) before wheel B hit 55 rad/s.
- Leftover gravity torque fell from ≈ 8 mN·m (roll) to 1.3–3.3 mN·m (now pitch), so the pitch wheel (B) saturates.
- The tilt held while "level" (0.3–0.8° pitch, ≤ 0.2° roll, IMU frame) equals torque ÷ Kp: the expected PD
  steady-state error. A visibly larger deck tilt would be IMU mounting offset (to measure with a bubble level).
- Yaw disturbance ≈ 0.12 mN·m → ≈ 6–7 min of heading hold if roll/pitch hold the table's natural rest tilt
  (now within ≈ 0.5° of level) instead of exact level. Figure: `Reports/figures/fig7_demo_level.png`.
- **Firmware change (2026-10-27):** `DEMO LEVEL` now holds the natural rest tilt: heading held with the full PD,
  roll/pitch only damped (reference tilt = measured tilt), so gravity sets the tilt and the wheels carry no
  steady roll/pitch torque. Chosen over a slowly-tracking reference after a single-axis simulation: pure
  damping stored ~8 mN·m·s for a 2° start vs ~42 mN·m·s with 4 s tracking. Not yet run on the table.

---

### 2.12 Magnetometer calibration and yaw aid (2026-10-27) — `Reports/Magnetometer_Yaw_Aid_Report_2026-10-27.md`
- Fixed-table tests (raw 100 Hz USB stream): a stopped wheel's field depends on its shaft angle (1–5 µT ≈ 3–13°);
  a spinning wheel's mean is repeatable and nearly speed-independent, but reversing it shifts the mean 0.6–1.6 µT.
  Per-wheel direction/speed model fitted for A–C (≤ 0.8° per wheel).
- Firmware: heading-only magnetometer EKF update (also estimates the z gyro bias), `mag_aid` module, `MAG ON/OFF`,
  `KICK`, `RAW ON/OFF`, `WHEEL x ON|OFF`, automatic encoder-fault wheel disable.
- Result: wheels stopped, a 10° yaw error decays with τ ≈ 25 s; wheels spinning, not yet within ±1°
  (gating flicker, 1.4–2.9° error in mixed-direction combos).
- **Wheel D's encoder has a dead channel** (D spun ~500 rpm reading 0). Repair before 4-wheel tests.
- 2026-10-29: aid fixes (speed hysteresis, one reference per wheel-direction pattern, learning only while the
  estimate is fresh). Test 5 (spinning, wheels A+B; C wouldn't start, D off): yaw within ±0.94° in un-kicked
  combos, kicks recover while spinning (τ ≈ 25 s) with ~0.9° left after a kick. 3/4-wheel spinning untested.
- **2026-10-29: Teensy lost power after test 5** — boost outputs 5 V but no 5 V at the Teensy VIN pin, no
  3.3 V, no LEDs, not seen on USB. Blocks all testing; see report §1.7 and `TODO.md` §0.
- **2026-10-30: resolved with the spare Teensy.** The old board's 3.3 V rail was shorted on the board itself
  (0.8 Ω bare, very hot when powered): it is dead. No wiring cause found (driver VIN–VCC / VM–VCC and every
  motor-lead-to-encoder check read open). The spare was flashed (5ec01a5) and brought up
  in stages with 3.3 V and heat checks: IMU clean after reseating its wiring (1 reset, 0 lost samples), XBee OK,
  encoders A–C OK, `TEST x 0.3` A +45.0 / B +45.7 / C +37.5 rad/s (C ~17% slow). Its VIN–VUSB pads are still
  joined (the cut didn't separate them), so uploads are done over USB with the battery off and tests are run over
  the XBee (procedure in `CLAUDE.md`, "Uploading and running").
- **2026-10-30: wheel D's encoder** — a wire was almost pulled out. Reseated, `TEST D ±0.3` gives +44.9 / −46.8 rad/s,
  but it failed again ~30 min later and needed a second reseat: the connection is **intermittent** and must be soldered
  or crimped with strain relief. Wheel C's slow first start (37.5 rad/s) did not repeat: pack C 12.3 V, retests
  46.2–46.5 rad/s, same breakaway (0.08–0.10 duty) as A and B. Full write-up: `Reports/Teensy_Recovery_2026-10-30.html`.
- **2026-10-30: magnetometer wheel model recalibrated with all four wheels** (`MAG MAP`, fixed table, run over the XBee;
  `test_runs/MAGMAP_0003_analysis.html`). A–C repeat Owen's 2026-10-27 values within ~0.15 µT; wheel D measured for the
  first time; speed hardly matters; all four reversing together adds up within 0.2–0.45°. New constants in `mag_aid.cpp`
  (built, not yet uploaded). The raw field now carries a large table-fixed offset (|B| 64 µT vs ~52 µT Earth), so a
  hard-iron calibration is needed before tests where the table yaws.

### 2.13 SLEW TEST, stretch requirement (2026-10-29, first draft)
- New `SLEW TEST` command (`slew_test.h/.cpp`): four target attitudes, shortest-rotation (eigenaxis) slews on a
  smooth profile from any starting attitude, reach each within ±1° in roll/pitch/yaw and hold 5 s, PASS/FAIL per
  target. After the 4th target it keeps holding it until `STOP`. The tilt safety limit is 25° while it runs (the
  bubble has no top). `SLEW SET` / `SLEW LIST` change and show targets. Build-verified; not yet run on the table.
- 3-D simulation: balanced table 4/4 PASS (worst error ≈ 0.02°). The current pendulous table saturates a wheel
  2.3 s into the first slew; yaw-only targets at the natural rest tilt pass 4/4. The default ±10° tilts need the
  free-swing period ≳ 55 s (gravity stiffness ≤ 0.001 N·m/rad, CG within ~0.02 mm of the bearing centre).

### 2.14 FAULT TEST, requirement 3 (2026-10-29, first draft)
- **Detection** (`wheel_fault.h/.cpp`, always on while Armed): a motor driven hard (effort = duty − speed/160
  ≥ 0.2) whose wheel gains < 25% of the predicted speed for 0.2 s is declared dead, taken out of service and
  coasted at the zero-current duty (EN/ENB are hard-wired, so plain "off" would brake it and dump its momentum
  into the table). The other three wheels carry on with whatever is running; allocation already handled 3 wheels.
- **Test:** `FAULT TEST <A-D> [s]` kills that motor's output after the delay without telling the controller
  (the rest of the firmware still sees the commanded duty, like an open lead), with the wheels idling at ±100 rpm
  in the null mode so the failure shows up at once. Graded: right wheel detected within 1 s, back within ±1° within
  10 s, then ±1° for 30 s. `FAULT TEST REAL` grades a failure you cause yourself (pull a lead); `FAULT CLEAR` undoes it.
  Logs gain `wheel_status`, `err_roll/pitch/yaw_deg` (controller error) and `fault_phase`.
- **Motor-level simulation** (back-EMF, friction, pack differences, encoder quantisation, firmware speed loop):
  9/9 graded runs PASS: each wheel during DEMO LEVEL on today's pendulous table, mid-slew and mid-hold in SLEW TEST,
  and an unplugged motor. Detected 0.6–0.8 s after the failure, peak error ≤ 1.0°. 0 false alarms in 4 healthy
  runs. SLEW TEST re-simulated with the same model: balanced 4/4 PASS (≤ 0.08°); today's table with ±10° targets
  stops at the wheel limit 4.9 s in; yaw-only targets at the rest tilt pass 4/4.
  Deliverable: `Reports/Slew_and_Fault_Simulation.html`.

### 2.15 MAG TEST, fixed table, all four wheels (2026-10-30) — `test_runs/MAGTEST_0001_report.html`
- Run over the XBee: ~10 min warm-up, `CALIBRATE 180`, `MAG TEST` (37 graded steps, 57 min: stopped, 14 wheel direction
  patterns at 100–300 rpm, three ±10° estimate kicks, 30 min drift run). Log `test_runs/MAGTEST_0001.CSV`.
- **On board: 36/37 PASS.** Every step stayed within ±1° except step 36 (drift run, all wheels 300 rpm, pattern ++--): 1.02°.
  Kicks pulled back in 73–84 s. Aid in use 78–100% of each step (92% overall). Drift run: max 1.02°, trend −0.40 °/h.
- **Without the aid** (same log replayed on the PC with `MAG OFF`): yaw drifts **5.7 °/h** even after the warm-up and the
  180 s calibration, so it would leave ±1° after ~12 min.
- **Cause of the miss (log replay, `tools/replay`):** each new direction pattern's reference was learned at the yaw error
  of that moment, so errors random-walk from pattern to pattern (step 36 went in at −0.6°; its pattern was learned at
  200 rpm, and at 300 rpm the field sat a further +0.43° off). Replaying the same log with **predicted** references
  (each new pattern's reference from a known one via the MAGMAP_0003 wheel model, fitted on a different run) passes
  **37/37, worst 0.77°**, 0.25° rms vs 0.33°. Also tried and rejected: gating above 250 rpm (gyro gaps let drift in, 1.29°),
  slower correction σ 0.5 (13 fails, slow kick recovery), no stopped re-learn (no gain). σ 0.2 with prediction: 37/37,
  worst 0.67°, kicks back in 45–51 s — tuned on this same log, so try it on the table with `SET MAG_SIGMA 0.2`.
- **Firmware change:** prediction is now the default (`kMagPredictNewPatterns`, `mag_aid.h`); uploaded 2026-10-31, not yet run on the table.
- **Data loss:** 1,529 SD rows lost, all within one 4-min window (10–15 min in, steps 10–13) in short gaps ≤ 17 rows /
  249 ms: SD-card write stalls overflowing the 32 KB buffer; estimation on board was unaffected. 354 IMU samples missed
  (0.1%, steady ~30 per 5 min): the known BNO085 behaviour (STATIC_0009: 0.085%).
- The replay reproduces the logged yaw to 0.047° rms (0.18° max) over the whole run, aid included.

### 2.16 MAG TEST rerun with predicted references (2026-10-31) — `test_runs/MAGTEST_0002_report.html`
- Firmware with prediction as the default; ~3 min after power-on (board warm from the upload), `CALIBRATE 180`
  (z bias −0.0333 °/s), `MAG TEST`. **Stopped at step 15: 10/15 PASS**: steps 8, 9, 11, 12, 15 at 1.02–1.21°, all on or
  right after first visits to new wheel patterns (−−−−, +−−−, −−++).
- **Prediction failed this time.** Per pattern, the wheel-corrected field sat up to **+1.24° (−−−−) and +1.07° (+−−−)** off
  the ++++ reference (run 1: −0.1…+0.4°), growing with the number of reversed wheels: the reversal model moved ~1° between
  sessions. The raw field strength also differed (71.1 µT in run 1, 64.7 µT now; MAGMAP_0003 64.0): the magnetic
  surroundings changed between the runs (something magnetised near the IMU, or the table placed/turned differently).
- **Replays of both logs** (learned / predicted, worst outside kicks): run 1 1.02° / 0.77°, run 2 0.78° / 1.49°. Blends of
  the two, faster correction (σ 0.2) and no stopped re-learn were all inconsistent across the two runs (worst 0.8–1.3°).
  Each new pattern's reference carries 0.3–1.2° of error either way: that is the floor of this magnetometer placement.
- **Firmware:** back to learning new patterns in place (`kMagPredictNewPatterns = false`; prediction only when the aid is
  stale). Heading holds change pattern only once or twice (wheel-bias planner), where learning's random walk barely
  starts. **SD logger:** rows were again lost in a 5–6 min burst (2,398 rows, 7–13 min into the file). The logger now writes
  whole, sector-aligned blocks of up to 8 KB (it wrote one 512 B sector per call, and the 1 s flush left the file
  misaligned) and the RAM buffer is 96 KB (was 32 KB). Uploaded 2026-10-31, not yet tested on a long log.
- Moving the magnetometer away from the wheels (fields fall as 1/r³) would lower that floor, but the team can't change the
  IMU mounting, so it stays a fixed limit: keep pattern changes few during holds.
- **Final presentation not yet updated for this run** (deferred): it still shows the run-1 prediction replay as the
  current firmware (TODO.md).

### 2.17 DEMO LEVEL heading holds on the air bearing, aid on vs off (2026-10-31) — `test_runs/DEMO_0003.CSV`
(The 2026-10-21 DEMO LEVEL log that used this name is now `DEMO_0003_OLD.CSV`.) ~10 min warm-up, `CALIBRATE 180` on the
stand (z bias −0.0379 °/s), table floated, then two holds over the XBee; wheel bias on (100 rpm, `null_bias.h`).
- **Test 1, aid on (214 s):** settled at the rest tilt in 6.3 s (roll 0.89°, pitch −2.77°). Yaw estimate held ±0.2°
  (controller error 0.02° rms). The aid was in use 94% of the time (one +−+− reference learned, gated 1%), field residual
  +0.20° mean / 0.32° rms. Wheels ≤ 34 rad/s, no pattern changes.
- **Test 2, aid off (189 s):** settled in 6.1 s; estimate held, controller error 0.07° rms (0.65° max during the planner
  switching below). Wheels up to 46 rad/s.
- **Truth:** no laser yet; the heading marks showed the heading held by eye. An independent magnetometer heading
  (tilt-compensated, wheel-corrected, gyro-free) moved −0.3…−0.45° over test 1 and ≤ 0.16° over the first 95 s of test 2
  (−0.5° after the pattern change): heading held within ~0.5°, limited by the field's speed dependence as the wheels
  filled. Too short to separate aid on from off; that needs long holds and the laser.
- **Bias:** while the table turned freely before test 1 (~100° of yaw) the aid moved the z bias −0.0379 → −0.0419 °/s
  (uncorrected hard iron). Test 2's flat start says the aid's value was close to right: the stand calibration was off.
- **Wheel-bias planner chatter (fixed, uploaded):** in test 2, when wheel B reached the 45 rad/s peak budget at 112 s,
  the planner changed pattern (by design, to cut the peak 45 → 30 rad/s) and then flipped between two patterns 15 times in
  6 s: all candidates had ~7.6 rad/s clearance (a near tie), and a wheel stuck near 0 by static friction during each change
  moved the decision. Fix (`null_bias.h`): decide on 0.5 s low-passed speeds, treat clearances within 1 rad/s as equal,
  and hold each change ≥ 5 s (uploaded 2026-10-31). Replaying test 2's wheel speeds through it: 1 change; motor-level simulation unchanged
  (hold 370 s vs 347 s without bias, 2 changes, 0.1° yaw error, fault test still passes).
- **Balance (free swings after each STOP, `tools/balance.py`):** swing period 2.87 s (10-21: 3.2–3.5 s), centre of mass
  6.1 mm below the bearing centre (was 4.5 mm), 0.24 mm −x / 0.12 mm −y off-centre, rest tilt +1.17° roll / −2.25° pitch
  (was −0.14° / −0.18°). The period is independent of the IMU mount, so the mass distribution changed since 10-21.
- **SD logger fix:** 0 rows lost over 9 min / 17 MB (earlier losses began 7–13 min in, so a longer log is still needed).
  IMU: 168 samples missed (0.3%), and one chip reset while the table was being floated: strain-relieve the STEMMA/INT/RST
  wiring.

### 2.18 Balance session and dead-motor false alarms (2026-10-31) — `test_runs/balance_iterations_2026-10-31.txt`, `DEMO_0004/0005.CSV`
- **Balance:** iterative trim with rest-tilt readings (`tools/rest_tilt.py`: BIAS 0 + DEMO LEVEL over the XBee). The IMU mount
  rocked (glued; `LEVEL ZERO` with a phone level, then re-done 1.5 h later: the glue crept 1.1° in pitch). Repeat readings
  scatter ~0.3°, plus ~0.3° that turns with heading (fixed in the room); readings at one heading (tape markers, wheel C at
  the tape) agree within ~0.15°. Then the loose heavy weights and top screws came off (swing 4.3 → 2.9 s, CG ~5.7 →
  ~13 mm below the bearing centre: twice as stiff, ~1,150 g·mm per degree, so a re-seated pack moves it only ~0.4°), and
  washers in the diagonal seats trimmed it (3 × 8 g on CD and on AD: +2.3° roll, as predicted). A wheel-A kick on the
  floating table swung it in roll only, confirming the IMU axes match the wheel layout. **Final rest tilt ≈ −0.9° roll /
  −0.7° pitch.**
- **Decision: stop fine balancing.** Requirements 1–3 run at the rest tilt (DEMO LEVEL), so they don't need it; tilted slews
  need the CG within ~0.02 mm, impossible by hand with packs re-velcroed at every charge (±1° per pack). Trim only if the
  rest tilt exceeds ~±5°.
- **Dead-motor false alarms (fixed, built, not uploaded):** 14 flags in the two logs (13 on D, 1 on A), every one a wheel
  starting from rest while the speed loop wound its duty up to 0.23–0.30 without the wheel moving (static friction). Healthy
  starts break away at 0.10–0.15 (up to 0.27). The detector now needs effort ≥ 0.4 (near the current limit) for a wheel at
  standstill; a replay of both logs gives 0 flags. Spinning-wheel detection (FAULT TEST) is unchanged. Uploaded; wheel D
  then tripped the encoder check instead (stuck > 0.5 s above 0.2 duty), so that threshold is now 0.4 too
  (uploaded). Wheel speed limit raised 60 → 80 rad/s (full motor torque up to ~79 rad/s at 12 V; uploaded).
- **Wheel D was weak, then wasn't:** 1 s at 0.3 duty reached 33–36 rad/s vs 46–47 for A–C (packs all 12.0 V). Later, after
  the pack-voltage check and a power cycle: encoder exact (10 hand turns = 4,002 counts), no drag by hand, and D 45.6–46.8 rad/s
  both directions (C 45.9–46.2). Likely an intermittent connection in D's power path (pack lead, driver terminals, motor
  leads) disturbed during the check: inspect it. Health check before runs: `TEST A..D 0.3` (table held), all ≈ 46 rad/s.
- **Vibration check at the new limit** (table clamped, `SPEED ALL` 0→760→−760 rpm, `STATIC_0008 31 Oct.CSV`): accel sd 0.02 m/s²
  at rest, ≤ 0.10 m/s² up to ±760 rpm, gyro unchanged; all wheels held 756–764 rpm at 0.47–0.48 duty. 80 rad/s is fine.
- **IMU sample loss is SD-logging stalls, not vibration:** pairs of 60–130 ms gaps (5–12 reports lost) every ~1.67 MB of log
  (~53 s), wheels stopped or spinning alike (same in DEMO_0004/0005: 0.3% lost, 140 ms at log open). Gaps over the 100 ms IMU
  timeout were skipped by the EKF (rotation lost); the timeout is now 300 ms so they are integrated (uploaded).
  Root cause in the SD path still open.

### 2.19 STEP TEST and first FAULT TEST on the air bearing (2026-10-31) — `DEMO_0007.CSV` (SD)
Warm board, `CALIBRATE 180` clamped (z bias −0.0493 °/s), table floated, wheel bias 100 rpm.
- **STEP TEST (requirement 1):** ±5° heading steps: rise 1.52–1.56 s, 0% overshoot, settle 1.79–1.90 s, final error
  ≤ 0.12°, jitter ≤ 0.04° rms (baseline 0.010°). **Measured I_zz = 0.0776 kg·m²** (model 0.0623; `SET IZZ` for this
  power-on, not yet in `control_params.h`). Yaw drag ≤ 0.07 mN·m.
- **Truth check failed by eye:** after the last step back to 0 the table sat visibly off the tape marker, toward the first
  step, while the estimate said 0.015°: a heading-estimate error (requirement 2). During the +5° step the magnetometer aid
  showed a 3.9° residual (spinning-pattern mode). To analyse from the SD log (raw gyro vs estimate); laser pointer needed.
- **FAULT TEST B (requirement 3) PASS:** wheel B made dead after 10 s of DEMO LEVEL; detected in 0.91 s, back within ±1° in
  0.9 s (peak error 0.01/0.02/0.79° roll/pitch/yaw), 30 s hold max 0.70° yaw. Graded on the controller's own error, so it
  inherits any heading-estimate error.

### 2.20 Stretch requirement: SLEW TEST on the table, and SLEW YAW (2026-10-31)
- **SLEW TEST with yaw-only targets** (45/135/−135/0°, roll/pitch fixed at the rest tilt −1.2/−0.2°): stopped on the wheel
  limit 13.5 s into the first slew. Wheels A/C filled in opposite directions (roll momentum): the table wanted ~−1.5° roll at
  that heading, and 0.3° of mismatch costs ~3 mN·m. Tilted targets (8–10°) would cost ~110 mN·m and fill the wheels in < 1 s.
- **`SLEW YAW` (new, simulated, uploaded; not yet run on the table):** yaw follows the slew profile, roll/pitch are damped at the rest
  tilt. Host simulation with the firmware code (`tools/slewsim/`): 4/4 PASS with 0–4 mN·m of room-fixed torque, peak wheel
  16–34 rad/s. Same simulation, fixed-tilt SLEW TEST: wheel limit in target 4.

### 2.21 Heading error explained: the table's hard iron (2026-10-31, `DEMO_0007.CSV`)
- Gyro-only replay of the STEP TEST: the table really turned +5.9→+7.4°, then sat **+2.7°** off the start at the first "0"
  (what was seen at the tape marker), −3.1→−4.5°, then +0.05–0.2° at the end. The magnetometer aid had pulled the estimate
  2.9° (STEP TEST) and up to 8.6° while the table was turned by hand.
- Circle fit of the horizontal field over a 376° free turn (wheels stopped, aid off): Earth's horizontal field 22.4 µT, and a
  table-fixed field of **(+20.5, −48.9) µT**, 2.4× Earth's. Never calibrated before (fixed-table MAG TESTs can't see it).
- Replay with it removed: STEP TEST pull 0.7°, hand turns 0.9°. Now `kMagHardIronUt` (uploaded). Still large around the
  SLEW TEST (wheels near 75 rad/s, beyond the 31 rad/s the wheel-field model was mapped to).
- `SLEW YAW` uploaded with it (not yet run on the table).

### 2.22 SLEW YAW 4/4 PASS on the air bearing; wheel D (2026-10-31, `DEMO_0008.CSV`, `DEMO_0009.CSV`)
- **STEP TEST rerun** (hard iron on, I_zz 0.0776): rise 1.22–1.66 s, overshoot 1–4%, settle 1.57–1.96 s, final error
  ≤ 0.003°, jitter ≤ 0.03° rms; I_zz measured 0.0759. **Back on the tape marker at the first return to 0 by eye** (was
  2.7° off before the hard-iron fix). I_zz 0.0768 (mean) now the firmware default (uploaded).
- **`SLEW YAW` 4/4 PASS** (yaw +45, +135, −135, 0° from the start; 13.9 / 24.7 / 24.7 / 37.0 s slews, each reached
  1.0 s after its slew): worst hold errors yaw 0.04–0.05°, roll 0.12–0.17°, pitch 0.06–0.08° from the rest tilt. Graded
  on the estimate; truth only by eye so far (laser pending).
- **Wheel D:** in DEMO_0008 it did not turn at all on three Armed starts (encoder steady, duty up to the 0.45 limit), so
  those flags were correct; the first SLEW YAW stopped on the wheel limit because A/C had absorbed D's share. After the
  wiring check and a power cycle, D spun normally (±0.3 duty ≈ 46–47 rad/s) and ran 4 DEMO LEVEL starts and the full
  SLEW YAW without a flag. Intermittent: poor connection or a latched driver. If it recurs: spin-test before touching,
  then cycle only the motor switch.

### 2.23 SLEW YAW overshoot = yaw gyro scale factor (2026-10-31, `DEMO_0009.CSV`, `DEMO_0007.CSV`)
- After SLEW YAW (4/4 PASS, 360° of slews in total) the table sat a few degrees past the tape marker. In DEMO_0009 the
  aid was stale/gated and the z bias constant the whole run, so the estimate was pure gyro: the gyro itself under-read.
- Magnetometer heading (hard iron removed, per-turn field centre) vs integrated gyro over two free turns in DEMO_0007
  (378°, 342°): true/gyro = 1.0090 and 1.0085. Hand test against the marker (MAG OFF, 3 turns each way, XBee):
  CCW 1060.4° read for 1080°, CW ~1050°, but with several degrees of alignment and creep uncertainty per leg.
- Firmware: `kGyroScaleZ` = 1.009 applied to every gyro z sample (`SET GYRO_SZ` to adjust; uploaded with I_zz 0.0768).

### 2.24 Presentation spot: magnetometer distorted; demos gyro-only (2026-10-31, `SLEW_0001.CSV`)
- Table moved to the presentation spot. `SLEW YAW` 4/4 PASS again (worst yaw 0.03–0.13°); with the 1.009 gyro scale it
  ended slightly short of the tape marker (before: a few degrees past), so the true scale is ~1.006–1.009.
- Field here: Earth's horizontal component 15.4–15.8 µT (old spot 22.4) and a heading error that depends on the table's
  heading: 6–9° p-p with a free circle centre (old spot 1.9°), 37–40° p-p against the firmware's hard iron with the wheels
  stopped (stopped motor shafts add a ~5 µT offset that changes every time the wheels stop).
- Room-distortion correction written (`MagAid::setRoomCorrection`, `SET MAG_C1/S1/C2/S2`, `tools/mag_room_fit.py`,
  replay `--room`; uploaded, coefficients 0). Spinning-wheel calibration turns (null pattern ±100 rpm, MAG OFF, 100 Hz SD log,
  0.5 s smoothing, firmware wheel model): 14.2° p-p uncorrected, 2.0° in-sample, but only 3.5° / 5.3° when fitted on one
  turn direction and tested on the other. Stopped-wheel fits have entirely different coefficients and don't carry over.
- **Decision for the presentation runs: magnetometer aid off** (now the firmware default, `kMagAidDefaultOn` = false, uploaded with the room-correction code at 0; `MAG ON` to use it). After a warm `CALIBRATE 180` with the yaw
  scale corrected, gyro-only heading drifts ~3 °/h (< 0.2° over a few minutes), better than the aid's ±2–2.5° here.
  Spinning-wheel correction if long holds need the aid: c1 −7.64, s1 +1.82, c2 +0.37, s2 −0.15 deg.

### 2.25 SLEW YAW gyro-only at the presentation spot: on the marker (2026-10-31, `SLEW_0002.CSV`)
- Aid off by default, gyro scale 1.009, I_zz 0.0768, 5 min warm-up + `CALIBRATE 180` (z bias −0.0431 °/s).
- **`SLEW YAW` 4/4 PASS**, each target reached 1.0 s after its slew; worst hold errors yaw 0.03–0.05°, roll 0.10–0.16°,
  pitch 0.09–0.12° from the rest tilt. **After 360° of slews the table ended dead on the tape marker** (by eye), the first
  run where the true heading matched at the end (before the hard-iron fix: 2.7° off after a 5° step; before the gyro scale:
  a few degrees past after 360°; with the magnetometer aid at this spot: slightly short).
- Requirement 2 still needs a measured truth (laser) rather than a visual check.
- **Write-up of 10-30/31 with figures, simulation methods and sim-vs-table comparison:** `Reports/Lab8_Writeup_2026-10-30_31.html` (figures made by `Reports/figures/writeup_2026-10-31/make_figs.py`).

### 2.26 Tilted targets: raising the CG and `SLEW TILT` (2026-11-01)
- 11 g laser at ~290 mm: swing 3.0–3.1 s, CG 12.1 mm below the pivot (predicted 12.3). Battery packs re-seated after
  charging moved the rest pitch ~+2° (rest roll −0.63°, pitch +1.35° at the markers); 2 washers AD → CD to trim.
- Plan for the stretch with tilts: raise the CG to ~0.5–1 mm with ~220 g at the top screw seats (~250 mm above the pivot;
  tipping point ~240 g), approached by swing period (target ~11–15 s), trimming sideways at each step. First step +126 g at
  255 mm (expected CG ~5.5 mm, swing ~4.6 s); not yet measured (IMU ground wire came loose).
- **`SLEW TILT`** (built, simulated, uploaded): rest-tilt scan, targets as offsets from it, gravity feedforward, momentum
  unloading by tilting against gravity between targets, budget check, faster slews. Simulation (`tools/slewsim`, firmware code):
  1 mm ±2° and 0.5 mm ±3° pass 4/4 with up to 1.5 mN·m room torque and GRAV_K ±30% off; 2 mm fails even ±1°. A room-fixed
  torque made the rest tilt drift as the table turned and the damping fought it (wheel limit in the scan) until the scan
  reference was given the slow tilt rate.
- **Balancing toward ~1 mm stopped at ~3 mm** (swing ~6.2 s, k ~0.15 N·m/rad): the table's response stopped matching the
  model (a ~1,700 g·mm shift while lining up, trims landing 2× too far or moving the other axis, two apparent tip-overs
  that were large rest tilts). Readings scatter ~1° back to back at this stiffness. Left at roll +0.45°, pitch −2.3°:
  4 nuts per side on two 55 g screws along y at 235 mm (B group ~53 mm, D ~45–48 mm), washers CD 7 / AD 1 / BC 1 (7 g);
  126 g top weight and 48 g of low brackets removed; laser on top.
- **SLEW YAW made robust to the lower stiffness** (built, simulated, NOT uploaded): at 3 mm a room-fixed torque makes the
  rest tilt drift as the table turns and the damping fought it (simulation: 1.5 mN·m → wheel limit). The yaw-only reference
  now includes the slow tilt rate, like the SLEW TILT scan: 4/4 PASS at 3 mm and 13 mm with 0.5–3 mN·m, lower peak wheel
  speeds. Needs an upload and one table run to confirm.
- **First SLEW TILT on the table (DEMO_0012):** budget check refused ±0.4° (19.8 > 19.7 mN·m·s) as designed; with ±0.5/0.35°
  targets the scan hit the wheel limit after 40 s. Tilt stayed steady while the wheels filled at 0.70 / 0.39 mN·m (x/y):
  a ~0.05 °/s x/y gyro bias error times the damping gain is a steady torque that gravity holds still and the wheels supply.
  **Fix (uploaded):** momentum leak in SLEW YAW and the scan (reference rate += h_xy/(Kd·10 s)); h_xy then settles at
  ~Kd·bias·10 s. Simulation with a gyro bias (new `sim` argument): without the leak the scan fails at 58 s (table: 40 s);
  with it, SLEW TILT ±0.5° at 3 mm passes 4/4 with 0.05–0.1 °/s bias, and SLEW YAW passes at 3 and 13 mm with peak
  wheels 26–40 rad/s (63 without the leak). SLEW YAW with the slow-drift + leak changes still needs its table confirmation.

### 2.27 First measured heading truth: SLEW YAW −0.1° after 360° (2026-11-01, `SLEW_0003.CSV`)
- Firmware with the slow-drift reference and momentum leak (uploaded), CG ~3 mm below the pivot, aid off, 5 min warm-up +
  `CALIBRATE 180` (z bias −0.0446 °/s). Laser on the deck, wall 2480 mm from the bearing centre, printed scale
  (`Reports/laser_scale_2480mm.pdf`, `tools/laser_scale.py`).
- **`SLEW YAW` 4/4 PASS**; worst hold errors yaw 0.03–0.59°, roll 0.08–0.46°, pitch 0.04–0.19° (target 2 was the largest);
  wheels ≤ ~41 rad/s, back near ±10 rad/s at the end.
- **Laser at the end, after 360° of slews: −0.1°** (dot 4.3 mm right of zero). Requirement 2 heading accuracy measured, 10×
  inside ±1°, and it confirms the 1.009 yaw gyro scale (residual ~0.03%).
- **Laser hold (DEMO LEVEL, same calibration):** estimate held within 0.02° throughout, but the dot drifted clockwise:
  −0.25 / −0.43 / −0.58 / −0.65 / −0.78° at 31 / 61 / 91 / 121 / 151 s (~−0.004 to −0.006 °/s, ~14–20 °/h). The yaw
  calibration was taken only 5 min after power-on; the notes call for ~10 min, because the BNO085's z bias keeps shifting as
  it warms. Stopped to recalibrate warm (board ~30 min on) and repeat.

### 2.28 Wheel D encoder lead, pack A lead, unexplained reboots (2026-11-01, `DEMO_0013.CSV`)
- `TEST D` read 0 rad/s while D's motor turned; 10 hand turns gave ~−20 counts (expected ~4000). Encoder power (3.3 V) was
  fine and the encoder outputs toggled at the motor end but not at the Teensy: a break in the lead that both signals pass
  through, conducting only in some positions (counts came and went while the lead was handled).
- After reseating: 10 hand turns −3999, `TEST D 0.3` 46.3 rad/s. Then `DEMO LEVEL` (warm `CALIBRATE 180` at 17:05, z bias
  −0.0476 °/s) disarmed after ~1 s: B, C, D flagged dead motors, `DISARM ALLOC`. Cause: pack A's battery lead had come
  off (A no drive) and D's encoder dropped out again under motor vibration (D spun, read 0); B is believed to have run fast
  during a reboot, when the PWM pins float for up to ~3 s before `WheelMotor::begin()`.
- Pack A reconnected: A/B/C 45.6–47 rad/s at 0.3 duty. D's lead reseated with no strain: 10 turns −3995, `TEST D 0.3`
  46.7 / 46.6 rad/s. **All four wheels good, but D's lead is only reseated: replace its four wires with soldered,
  strain-relieved joints before the demo.**
- **The Teensy rebooted ~3 times without a power-cycle** (~16:48, ~17:09, ~17:19), each time while wiring was being handled.
  Suspect a 3.3 V–GND short in D's damaged lead (blue/green run in it); check blue–green continuity while flexing the lead.
  Possibly related to the old Teensy's shorted 3.3 V rail (10-30).
- Laser hold (requirement 1) still to measure: warm calibration + `DEMO LEVEL` on the laser.

### 2.29 Requirement 1 measured: 5-minute laser hold within 0.25° (2026-11-01 evening, `DEMO_0014.CSV`)
- After dinner the table rested near its stop (pitch ~−25°, roll ~+8°; cause not found). Rebalanced stiff: top screws,
  nuts and the 126 g weight off, laser on, washers AB 5 / BC 2 / CD 2 / AD 0; swing 3.2–3.6 s, CG ~9–11 mm below the
  pivot; rest tilt at the tape marker roll −2.5°, pitch +0.1°. Washer moves responded 2–4× the swing-fit sensitivity and
  a pure-y move showed up in pitch (as on 10-31): the assumed seat-to-axis layout is probably wrong.
- Power-on 17:54, warm-up ~13 min, `CALIBRATE 180` at 18:05 (z bias −0.0442 °/s). `DEMO LEVEL` (heading-hold bias 100 rpm),
  laser on the 2480 mm wall:

  | t (s) | 0 | 61 | 91 | 121 | 151 | 182 | 212 | 242 | 272 | 302 |
  |---|---|---|---|---|---|---|---|---|---|---|
  | Laser (°) | −0.20 | −0.22 | −0.30 | −0.40 | −0.45 | −0.38 | −0.37 | −0.30 | −0.30 | −0.37 |
  | Estimate (°) | 0.00 | −0.20 | −0.21 | −0.20 | −0.20 | −0.21 | −0.21 | −0.20 | −0.20 | −0.21 |

  (The −0.2° at t = 0 is the spin-up kick before the hold captured its heading; the estimate saw it too.)
- **True heading stayed within a 0.25° band for 5 min, no trend (net −0.17°), no visible jitter: requirement 1 met.**
  Stopped at 333 s with wheel D at ~65 rad/s (yaw drag would have ended it on the 75 rad/s limit ~30 s later).
  The earlier 14–20 °/h drift (§2.27) was the short warm-up.
- **SLEW YAW, 4 wheels (18:41):** targets 1–3 PASS (max yaw err 0.04 / 0.83 / 0.06°), then **`DISARM IMU_TIMEOUT`** 2 s
  into target 4: the BNO085 went silent 524 ms and was reset (4th chip reset since the 17:54 boot, 900 reports lost).
  Suspect wheel D's damaged encoder lead dipping the shared 3.3 V rail (also the IMU and Teensy supply; see §2.28).
- **SLEW YAW, 3 wheels (18:49; D's encoder blue/3.3 V wire unplugged, `WHEEL D OFF`, recalibrated, z bias −0.0495 °/s):
  4/4 PASS**, max errors yaw 0.02 / 0.05 / 0.10 / 0.09°, roll ≤ 0.29°, pitch ≤ 0.13°. No new IMU chip resets during the
  run (counters before/after: rst 4/4, maxgap 524/524 ms, +30 reports lost). With D off, B sits near 0 in pure yaw
  (only wheel with a y component); A and C carry the yaw.
- **Laser at the end: +1.1°** (start 0°; the targets make one full CCW turn). Outside ±1°, against −0.1° in `SLEW_0003`.
  Likely bias drift after tonight's IMU chip resets (the z bias moved 0.005 °/s between the 18:05 and 18:44
  calibrations); a 60 s post-run drift check was not taken.
- **SLEW YAW repeat, 3 wheels (18:53, same calibration, D still unplugged): 4/4 PASS**, max errors yaw 0.05 / 0.05 /
  0.06 / 0.08°, roll ≤ 0.31°, pitch ≤ 0.18°; no new IMU chip resets (rst 4/4). **Laser at the end: +0.06°** after the
  full 360° turn (requirement 2 confirmed again; the +1.1° run was a one-off, likely bias settling after the resets).
  Holding afterwards: −0.18° ~60 s later (a 0.24° wander, as in the 5-minute hold; within the hold's 0.25° band).

### 2.30 Live run through all requirements, D reconnected (2026-11-01 night, `DEMO_0015.CSV`)
- Fresh boot 21:18, 9 min warm-up, `CALIBRATE 180` at 21:28 (z bias −0.0424 °/s; IMU clean: 1 reset at boot, 0 lost).
  First `DEMO LEVEL` flagged all four wheels dead at once: motor switch off (its leads were loose); `FAULT CLEAR`, retried.
- **Requirement 1:** `DEMO LEVEL` 3 min, laser −0.05 / −0.03 / −0.03 / −0.08 / −0.18° at 0.5 / 1 / 2 / 2.5 / 3 min (0.15° band);
  estimate within ±0.03° (a wheel pattern switch at 212 s moved it +0.15° briefly).
- **SLEW YAW (4 wheels): 4/4 PASS** (max yaw err 0.02 / 0.61 / 0.03 / 0.03°, roll ≤ 0.41°). Laser +1.7° at the end and
  steady 60 s later: a fixed offset, not drift; the start looked unsettled, so likely a wrong zero (SLEW YAW takes its
  reference heading at the instant it starts). An earlier attempt started 1 s after STOPping the hold, while the braked
  wheels kicked the table (target 1 at 1.00°); stopped by hand.
- **Requirement 3: `FAULT TEST B` during `DEMO LEVEL`: PASS**, detected 0.90 s, back within ±1° 1.3 s after the failure
  (peak yaw err 1.38°), 30 s hold max 0.41° yaw / 0.01° roll, pitch on A/C/D (D at ~−55 rad/s). Laser −0.48° steady
  through the whole test: the failure was not visible on the wall.
- IMU: one 459 ms gap while Idle after a STOP (no chip reset, nothing disarmed) with D reconnected; otherwise clean.
- **`DEMO ALL` written and uploaded:** the three parts in one armed run (CLAUDE.md), slews referenced to the heading the
  hold kept, so the start reference problem above can't recur.

### 2.31 `DEMO ALL` on the table (2026-11-01 night, `DEMO_0016`–`DEMO_0018.CSV`)
- **Start failures:** at 21:59, 22:09 and 22:29 (and 21:33 with plain `DEMO LEVEL`) all four wheels were flagged dead within
  ~1 s of arming and one or two wheels (D; A and D) ran at full speed until the motor switch was turned off. Checks: driver
  logic GND to Teensy GND OK, motor-switch path OK, D's driver inputs (VCC, EN, ENB, PWM at 0 V) and wiring OK, D still at
  idle with motors on, packs > 12 V, each wheel's `TEST 0.3` 45–47 rad/s (D's encoder read 0 once, then fine), `SPEED ALL 100`
  and a clamped 6 s `DEMO LEVEL` fine. Not firmware (same code path as `DEMO LEVEL`; also happened on the old firmware). Every
  failure came right after the table was handled to unclamp and line up; the motor-switch leads are loose (not yet
  soldered) and D's encoder lead was then strain-relieved, after which the run below started cleanly. Suspect an
  intermittent joint under the combined start-up current. IMU gaps of 459–499 ms (no chip reset) accompanied these events.
  The SD logs record every encoder and duty at 100 Hz through each failure (not yet analysed).
- **22:35 run: complete, all parts PASS by the firmware's grading:** 1 hold 60 s max err 0.13°, jitter 0.015° rms, drift
  +0.001°; 2 SLEW YAW 4/4 (max yaw 0.04 / 0.04 / 0.26 / 0.03°); 3 wheel B detected 0.87 s, recovered 1.5 s (peak 1.42° yaw),
  30 s hold max 0.37°. No disarm between parts.
- **Laser:** −0.18° at the end of part 1, **+2.1° after the slews (2.3° off)**, +1.9° after the wheel failure (it barely
  moved). The estimate came back within 0.08°, so the yaw estimate loses ~2° over the full CCW turn (0.6% if a scale error).
  With the +1.7° earlier (§2.30) that is two 4-wheel runs tonight; this afternoon's SLEW YAW gave −0.1° (§2.27).
  **Open:** run SLEW YAW with mirrored targets (−45, −135, +135, 0: a full CW turn): an error that flips sign is a gyro
  scale error (retune `kGyroScaleZ`); one that stays positive is a bias while the wheels spin fast during slews.

### 2.32 Yaw lost in the EKF's accelerometer update; gyro scale re-fitted (2026-11-01 night)
- **Mirrored SLEW YAW** (full CW turn, 4/4 PASS by the firmware): laser **−1.8°** from a 0° start, against +2.3° CCW. The
  error flips with the turn direction: the estimate under-counts every turn by ~2° (~0.57%).
- Not lost samples: the logs' timestamps match the BNO085's sequence counter (sum ratio 0.99975, no zero or doubled steps).
  But integrating the logged gyro z (scaled 1.009, minus bias) over each full-turn run gives **364.1° CCW / −363.1° CW**
  while the EKF's yaw turned exactly 360° (laser truth 362.3° / 361.8°): the estimator took ~1% off.
- **Cause:** the accelerometer update. While the table turns, the MEKF's yaw error becomes correlated with its tilt error, so
  the full gain also rotated the estimate about the vertical (how much depended on each run's tilt/covariance history:
  laser results −0.1 to +2.3° with the same scale). `kGyroScaleZ` = 1.009 (fitted 10-31 with the leak present) had been
  compensating part of it.
- **Fix (uploaded):** `EkfParams::accelNoHeading` (default on): the attitude rows of the accelerometer gain are projected
  off the measured vertical, so gravity corrects roll/pitch only. `kGyroScaleZ` re-fitted to **1.0045** by replaying the
  logs through the fixed EKF (`tools/replay`, new `--leak` and `--gyro-sz` options): predicted end errors with the old
  firmware +2.66 / −1.52 / +2.01° against the laser's +2.28 / −1.80 / +1.7° (a common ~+0.3° offset, z bias; the scale
  part fits to ±0.1°). The `--leak` replay reproduces the logged yaw within 0.1–0.5°, checking the replay itself.
  The +1.7° at 21:41 (§2.30) was this error too, not a wrong zero.
- **To confirm:** one laser SLEW YAW (or `DEMO ALL`) on the new firmware; expect within ~±0.5° after the full turn.

### 2.33 Start failures = SD file creation stalling the wheel loop (2026-11-01 night)
- The next `DEMO ALL` (23:00, fresh boot after the upload) failed at arm again (all four flagged, A and D at full speed).
  **Every start failure today was the first arm after a boot** (17:07, 18:13, 21:33, 21:59, 22:09, 22:29, 23:00); every
  later arm worked (21:34–21:46, 22:33, 22:35).
- `DEMO_0016`/`0017` at 100 Hz: ~0.2 s after arming, the encoder counts of all four wheels jump ~1000 (2.5 turns) between
  two rows while the measured speeds stay 0 and the duty stays frozen: `loop()` (and with it the 100 Hz wheel loop) was
  blocked for a fraction of a second. The first arm after a boot opens a new `DEMO_####.CSV`, and the card's first write
  to a new file searches the FAT for free space; the IMU kept being read through `yield()`, so the control burst and then
  one huge wheel-loop step made the dead-motor detector flag every wheel, and frozen or burst duties ran some up. The
  459–499 ms IMU gaps were the same stalls.
- **Fixes (built, not yet uploaded):** `DataLogger::startFile` writes and flushes the header (padded to whole sectors with a
  `#` comment line) before returning, so the slow first allocation happens while the wheels are still stopped; and
  `wheelLoop` treats a step longer than `kWheelLoopStallS` (50 ms) as a stall: fault checks skip it, the speed loop uses a
  normal step, and it reports `# WHEEL LOOP STALLED n ms`.
- So D's encoder lead, the motor-switch leads and the packs were not the cause of the start failures (D's lead is still
  worth replacing: it did drop out on its own this afternoon).

### 2.34 `DEMO ALL`, all requirements, laser-verified (2026-11-01 23:13, `DEMO_0020.CSV`)
- Firmware with both fixes (§2.32 heading leak + `kGyroScaleZ` 1.0045, §2.33 SD stall). Fresh boot (first arm after boot,
  the case that always failed before), 60 s boot calibration + `CALIBRATE 180` (z bias −0.0462 °/s).
- Start: log file prepared in 1.19 s before arming (reported as a wheel-loop stall, wheels stopped); **no wheel faults.**
- **1 heading hold PASS:** max error 0.04°, jitter 0.011° rms, drift 0.000° over 60 s; **laser steady at −0.05°.**
- **2 SLEW YAW 4/4 PASS** (max yaw error 0.03 / 0.02 / 0.13 / 0.05°, roll ≤ 0.23°, pitch ≤ 0.16°). **Laser after the full
  360° turn: +0.02 to −0.03° against −0.05° before: ~0.05° error** (was +2.3° / −1.8° before the heading fix). Requirement 2
  confirmed by laser.
- **3 wheel B failure PASS:** detected 0.49 s, back within ±1° 0.5 s after the failure (peak estimate 0.90° yaw), 30 s hold
  max 0.36° yaw. Laser: peak −0.31° at the cut, then steady −0.18°.
- Summary line: `# DEMO ALL COMPLETE: 1 heading hold PASS (max 0.04 deg), 2 slews 4/4 PASS, 3 wheel failure wheel B PASS`.
- Wheel-loop stalls of 90–350 ms about once a second for the whole run (now reported). The same pattern is in the old
  firmware's logs (`DEMO_0018`: 116 stalls up to 338 ms in 508 s armed), so they are SD-write stalls, not new; the run
  passed through them. Next improvement: run the wheel loop from a timer interrupt so the card can't freeze it.
  **Deferred until after the final presentation (no firmware changes before it).**
- **Analysis** (`Reports/figures/demo_all_2026-11-01/`: figures, `RESULTS.md`, `make_figs.py`): gyro timestamps match the
  BNO085 sequence (ratio 0.99974); the integrated yaw rate gives +360.01° for the turn (estimator 360.0°, laser ≈ 360.05°);
  the PC replay reproduces the flown heading within 0.015°; the old estimator (leak + 1.009) replayed on this run would have
  ended the slews 0.46° off (1.7–2.3° on earlier runs: the leak varies with each run's tilt history). 101 wheel-loop pauses
  (median 118 ms) during the armed run.

## 3. Open issues (details and owners in `TODO.md`)
- **Wheel D's encoder connection is intermittent** (reseated twice 2026-10-30, failed again 2026-11-01, §2.28): replace its
  four wires, soldered + strain relief. Possibly also behind the unexplained Teensy reboots.
- **Table balance / pendulum** (§2.7, §2.18, §2.29): blocks levelling and tilted slews; requirements 1–3 work at the rest
  tilt. Rebalanced stiff (CG ~10 mm) on 11-01 evening.
- **Wheel D intermittent weakness** (§2.18): 25% slow earlier on 10-31, normal later; check its power-path connections.
- **Wheel A rub and low pack A; wheel C high duty and oscillation.**
- **Real table mass and inertia** still unmeasured (fits suggest x/y 0.05–0.13, z ~0.08 kg·m²).
- **Wheel-failure test** (requirement 3): all four wheels run again; ready for a first table run once wheel D's connection is permanent.
- BNO085 periodic 60–90 ms stalls (cause unknown, currently harmless).
- EKF noise retune from the static logs; wheel static-friction compensation; rotor momentum in the wheel model.

## 4. Firmware commands (quick reference; full list in `CLAUDE.md`)
`ARM`, `DISARM`/`KILL`, `STATUS`, `PING`, `CALIBRATE [s]`, `TEST <A-D> <duty>`, `SPEED <A-D|ALL> <rpm>`,
`COUNTS`, `ZERO`, `BEGIN STATIC TEST [rpm]`, `MAG MAP`, `DEMO SPIN`, `STOP`.

## 5. Data and analysis index (`test_runs/`)
| File | What it is |
|---|---|
| `2026-10-15_*` CSV/HTML | Bench speed sweeps, A/B driver swap, single-wheel and hand-turn tests (rpm 1.6× low) |
| `STATIC_0001.CSV`, `STATIC_0001_analysis.html` | First static IMU test: yaw drift, Allan variance, sample loss |
| `STATIC_0005.CSV`, `STATIC_motors_off_vs_on_analysis.html` | Motors-on static test, warm-up bias, EKF replay |
| `MAGMAP_0001.CSV`, `MAGMAP_0001_analysis.html` | Magnetometer offset vs wheel speed/direction |
| `MAGCAL_2026-10-27_t1..t4_*.txt` | Magnetometer calibration and yaw-aid tests (§2.12, report in `Reports/`) |
| `DEMO_0001.CSV` | First `DEMO SPIN` attempts on the air bearing (§2.7) |
| `STATIC_0008.CSV`, `STATIC_0009.CSV` | IMU sample-loss verification after the INT/RST/SD fixes (§2.8) |
