derek-weissinger-usafa/Astro-331-Lab-8/Reports/Astro 331 Lab 8_2_3 Body Problem_Prelim_Pres_FILLED.pptx

## Lab 8: Preliminary Data Review

2/3 Body Problem
C2C Gowri Ramaprasad
C2C Derek Weissinger
C2C Owen Crawley

Notes: https://www.youtube.com/watch?v=jVXgWGK9Kr8

## Overview/Objectives

- Using the small air bearing table, develop a 3 degrees of freedom (3DoF) reaction wheel attitude control system.
- Develop a robust sensor fusion algorithm using gyroscopes, magnetometers and accelerometers to accurately determine attitude at any given state.


## Requirements: Verification & Status

Requirement | Verification method / pass criterion | Status at review
(1) Hold heading, no visible jitter or drift | ARM on the free-floating table, hold yaw = 0 for 1 min, log attitude. Pass: |yaw error| < 1°, no visible jitter | In progress: controller built and simulated; closed-loop test awaiting table balance
(2) Attitude ±1° in all 3 axes | Steady measured EKF attitude for roll and pitch, magnetometer + marked turns for yaw. Pass: error < 1° over the run | Roll/pitch verified at rest (σ = 0.02°). Yaw: 3 °/h after warm-up (replay); moving-table test next
(3) Detect wheel failure and compensate | Disable a wheel (command or unplug) during a maneuver. Pass: fault flagged < 1 s and (1), (2) still met | In progress: 3-wheel allocation implemented; detection not started
Stretch: 4-attitude optimal slew and hold | Command 4 points along quaternion (shortest) paths. Pass: each reached and held for 5 s within ±1° | In progress: DEMO SPIN optimal trajectory generator is reusable

## Theory: Estimation & Control Loop


- Multiplicative EKF on the Teensy: 6 error states (3 attitude + 3 gyro bias), attitude kept as a quaternion
- Predict at 100 Hz with the gyro; update with the accelerometer (gravity direction) → corrects roll and pitch; rejects when |a| is not ≈ 1 g (accelerating)
- Yaw is gyro-only: gravity carries no heading, and the magnetometer is disturbed by the wheel motors (see Data). The z-gyro bias comes from a 60–180 s calibration at rest
- Frames: body z up, x = roll, y = pitch (right-handed); q maps inertial → body

## Theory: Control Law & Wheel Allocation

- Quaternion PD with feed-forward:
τ = −Kp θₑ − Kd (ω − ω_ref) + I α_ref + ω × (Iω + h_w)
Kp = I ωₙ², Kd = 2ζ I ωₙ (ref. Engr 341 2nd-order system, ωₙ = 2 rad/s, ζ = 0.9)
- 4 wheels in a 45° pyramid: any 3 still span all axes → the basis for wheel-failure tolerance (Req. 3)
- Minimum-norm allocation u = −D⁺τ over the enabled wheels; the 4th-wheel null mode [+1, −1, +1, −1] holds a bias speed
- Inner loop: 100 Hz wheel-speed PI with a back-EMF current limit (2.5 A, no current sensor)
- Physics limit: wheels cannot dump momentum.


Wheel J = 3.06×10⁻⁴ kg·m² (CAD); table I ≈ 0.062 kg·m² (model)
Speed limit 60 rad/s → ≈ 24 mN·m·s per tilt axis

Notes: I * alpha_ref is feed-forward: we know acceleration dynamics, so we just put it in control law instead of waiting for error to build up.

D⁺: pseudo-inverse of D, gives least wheel torque for desired body torque

## Build Progress: Hardware


- Power system: separate 5V logic pack, one 12 V pack per wheel, low-side motor switch, star ground, bench wiring sheet
- Verified on the table: pin map and encoder wiring corrected, wheel/encoder signs set; gearboxes found to be 6.3:1, not 10:1 (hand-turn encoder counts)
- Added IMU data-ready (INT) and reset (RST) wires → reliable data at 100 Hz

## Build Progress: Hardware

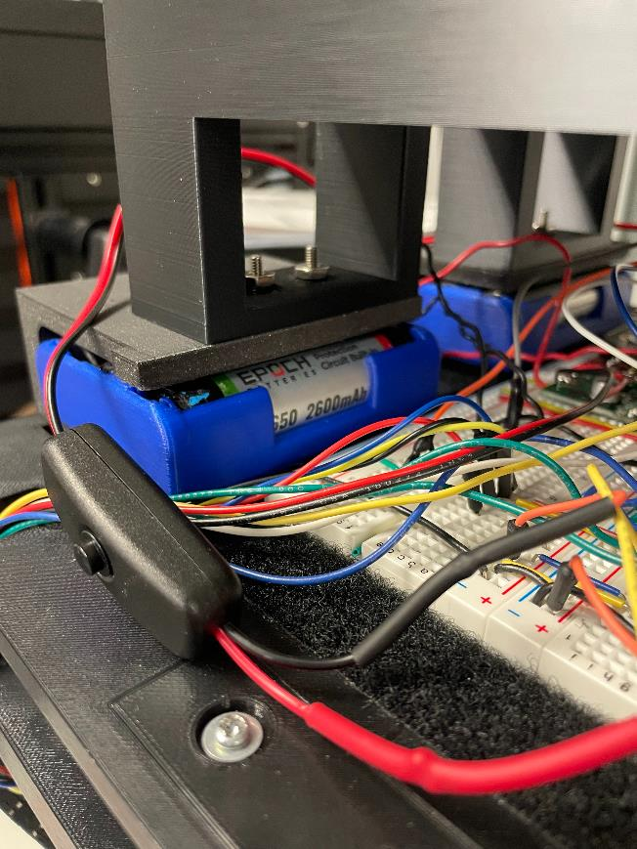
[picture p148: figure]

Battery Holder Detail


Battery Holder CAD

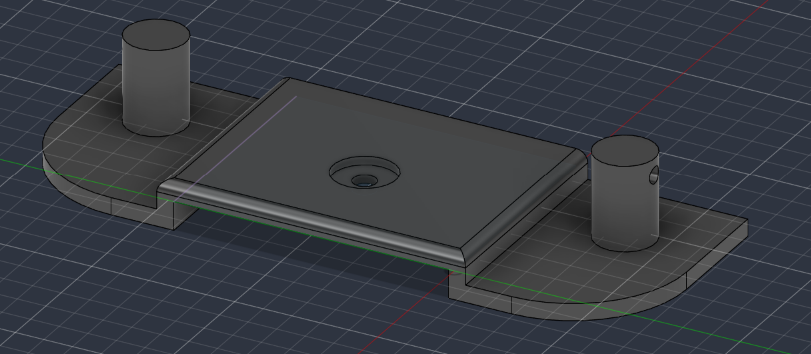
[picture p149: figure]

Washer Holder CAD

## Progress: Software Build & Tests

Teensy software (C++, PlatformIO):
- EKF, attitude controller, wheel allocation, wheel speed loops, safety supervisor
- Logger: every sample to SD (100 Hz), fractional live stream over XBee
- XBee/USB commands: ARM, KILL, STATUS, SPEED, TEST, CALIBRATE, BEGIN STATIC TEST, MAG MAP, DEMO SPIN
- SPEED manual closed-loop wheel mode with ramps and filtering to analyze motor control

Date | Test | Key result
10-08 | Wheel spin direction signs | Wiring corrected, signs set
10-15 | Bench speed sweeps, hand-turn counts | 6.3:1 gearing; Motor A rubs; Motor C oscillates
10-15 | Static IMU test (37 min) | Roll/pitch 0.02°; gyro yaw drift −27 °/h; ¼ of samples lost
10-16 | Motors-on static test, MAG MAP | Gyro warm-up drift; magnetometer disturbance mapped
10-16 | First DEMO SPIN on air bearing | Table is pendulous; wheels saturate
10-20 | IMU INT/RST + driver fixes | Sample loss 25% → 0.085%
10-21 | Battery Holders and CoM Calibration; Automatic Leveler Test via DEMO SPIN | Visible leveling, not meeting 1° error requirement.

## Data: Wheel Speed Control


MEASURE: Commanded vs. measured speed, all 4 wheels, 0 → 480 → 0 rpm cosine command profile (12 V packs).
COMPARE: Expected tight tracking from the 100 Hz PI + feed-forward control. B and D hold ±1 rpm; A and C swing ±10–16 rpm; no wheel moves until the command reaches ≈ 46 rpm.
EXPLAIN: Same gains on every wheel, so A/C differences are hardware: A rubs; C is still unexplained. The start delay is static friction.
NEXT: Fix A’s rub; check C’s pack voltage under load and its encoder; add static-friction compensation. Repeat test.

## Data: Attitude Determination at Rest


MEASURE: 37 min with the IMU fixed and motors off: EKF roll/pitch/yaw plus the independent magnetometer heading.
COMPARE: Requirement ±1°. Theory: a 3 s gyro-bias average leaves ≈ 26 °/h of yaw drift.
EXPLAIN: Roll/pitch σ = 0.02°, far inside ±1°. Yaw drifted −27 °/h, matching the predicted calibration error; the magnetometer stayed flat. Fixes: 60–180 s calibration, calibrate after a 10 min warm-up → ≈ 3 °/h in replay.
NEXT: Verify on the moving table; 3 °/h keeps yaw within ±1° for ≈20 min. Longer runs need a magnetometer aid.

## Data: IMU Data Integrity (Unexpected Result)


MEASURE: Time between every gyro sample logged to SD, IMU at rest, before and after our fixes.
COMPARE: Expected 10 ms. Before: 25% of samples lost and 38 gaps > 100 ms, each of which would have disarmed the wheels.
EXPLAIN: Root causes: the IMU library kept only the last report of each I²C read, SD writes blocked the loop, and no data-ready line. Fixed: INT/RST wired, IMU serviced during SD waits, SD in Direct Memory Access (DMA) mode.
NEXT: Remaining 60–90 ms stalls come from inside the BNO085 (every ≈22 s): under the 100 ms timeout and now integrated by the EKF. Monitor on long runs.

## Data: Magnetometer vs. Wheel Motors


MEASURE: Raw magnetometer heading on a fixed table while the wheels step through ±50/100/200 rpm.
COMPARE: A heading aid must be steady to well under 1°; with motors off it showed 0.7° noise and no drift.
EXPLAIN: Spinning wheels add 4.6–7.5° of fast, filterable noise. Stopped wheels leave a random offset up to ≈ 10° set by where each shaft stops (motor magnets), so no fixed calibration exists → yaw stays gyro-only.
NEXT: DEMO SPIN keeps every shaft at ±100 rpm so offsets average out; calibrate hard iron from a full turn, then add a gated magnetometer yaw update.

## Data: First DEMO SPIN (Unsuccessful)


MEASURE: Roll/pitch and wheel speeds with the table floating; three DEMO SPIN attempts (level, then spin).
COMPARE: Simulation (CG at the bearing center) levelled from 30° in ≈11 s. On the table each attempt hit the 55 rad/s wheel limit within 1–2 s.
EXPLAIN: The satellite is a pendulum on the table: 1.8 s period, resting ≈3° off level. Gravity ≈ 16 mN·m per degree, so holding level needs ≈50 mN·m against ≈24 mN·m·s of wheel storage. Fits confirmed wheel signs and I ≈ 0.05–0.13 kg·m².
NEXT: Return the satellite to its original CoM configuration; add bottom weights and lateral trim screws to refine CoM placement to center on table bubble.

## Data: DEMO SPIN Leveling


MEASURE: Six DEMO SPIN attempts after adding balance weights: roll, wheel speeds, and the free swing.
COMPARE: Expected: level (< 1° for 3 s), then spin. Instead, every attempt stayed in Level and stopped at the 55 rad/s wheel limit after 2.2–3.7 s (1–2 s before the weights).
EXPLAIN: Weights cut gravity’s pull ≈3× (swing period 1.8 → 3.3 s) and balanced pitch, but roll still rests ≈3.3° off level (−y side heavy). Holding roll at ≈2° pushes ≈8 mN·m against gravity and fills wheel A in ≈3 s; the stop then brakes the wheels and kicks the table.
NEXT: Trim roll (weight toward +y, ≈15 mN·m); new DEMO LEVEL test (level + hold, no spin) to measure hold time; ramp the wheels down instead of braking. Increase allowable wheel limit to greater than 55 rad/s for more momentum storage.

## DEMO SPIN

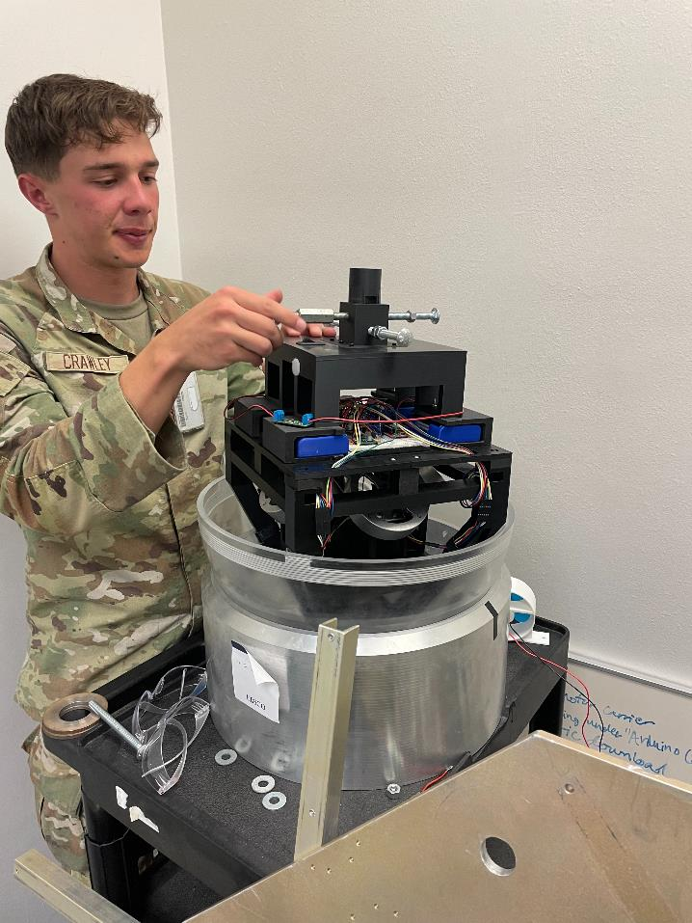
[picture p150: figure]

Setting Up for Spin

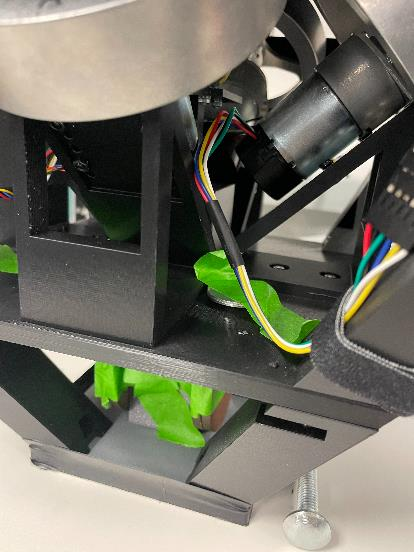
[picture p151: figure]

Additional Weight Detail

## DEMO SPIN: Leveling Video

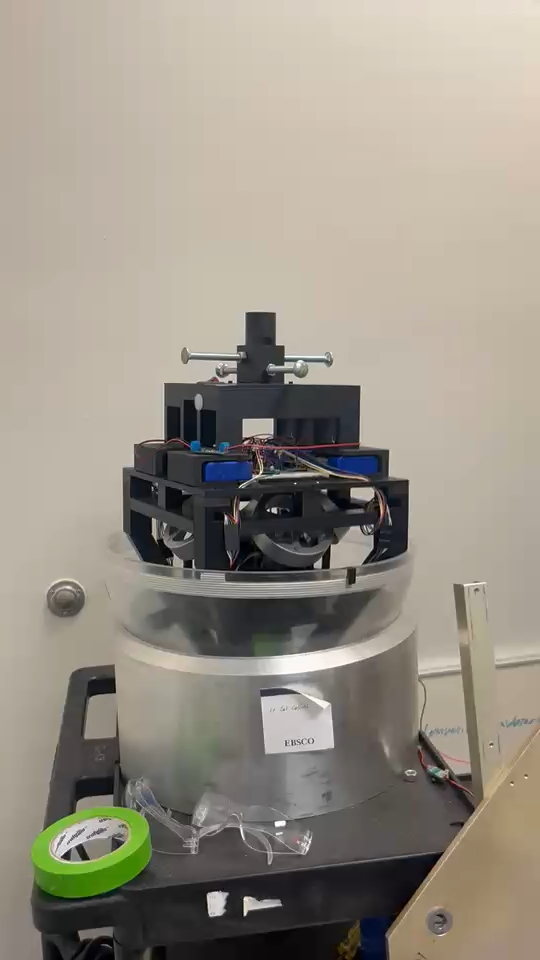
[picture p152: figure]

## Future Plans: Where We Stand

Complete

- Attitude estimator: roll/pitch 0.02° at rest
- Reliable 100 Hz IMU data (0.085% lost)
- Wheel speed control loop on all 4 wheels at 12 V
- SD + XBee logging and command link
- Wheel geometry and signs verified on the air bearing

Needs improvement

- Table balance: pitch fixed, roll still ≈3° off level
- Yaw drift: ≈3 °/h after warm-up
- Wheel A rub; wheel C oscillation
- Static friction at low wheel speed
- Real inertia

Remaining

- Magnetometer sensor fusion
- Heading hold on the free table (Req. 1)
- Yaw accuracy on a moving table (Req. 2)
- Wheel-failure detection + 3-wheel control (Req. 3)
- Stretch: 4-point optimal course slew

## Future Plans: Path to Lesson 31

# | Next task | Verifies | Complete By

1 | Trim roll balance (weight toward +y); measure hold time with the new DEMO LEVEL test | Enables hold | Lsn 27
2 | ARM heading hold on the free table for 5 min, logged | Req. 1 | Lsn 28
3 | Yaw truth test: marked turns + calibrated magnetometer | Req. 2 | Lsn 29
4 | Wheel-failure detection → drop to 3-wheel allocation | Req. 3 | Lsn 30
5 | 4-attitude slew along quaternion (shortest) paths | Stretch | Lsn 31

Key risks
- Balance limits hold time (wheels store only ≈24 mN·m·s per axis in current configuration, unknown how much it can reliably increase)
- Yaw drift on long runs without a magnetometer aid
- Unexplained wheel A/C hardware faults

Improvements beyond KestrelSAT
- Use of Air Bearing Table
- Interrupt-driven IMU pipeline with per-sample logging (25% → 0.085% loss)
- 4-wheel pyramid allowing 3DOF attitude control

Notes: Good baseline for pres, enlarge requirements (symbology: checkmarks), practice brief before final pres, add in/out to control loop, self-sustaining plots (have them be able to tell their own story, note important points), have pics tell story as well, include code snips (parse out each section + theory), why does ADSC matter???

## GenAI Use Documentation

- Primary Tool: Claude Code, Opus Model
  - Firmware: drafted the EKF, controller, wheel allocation, IMU driver, logger and command set from the team’s requirements and design decisions; the team reviewed, uploaded and tested every build on the hardware
  - Analysis: wrote the Python scripts and plots for each test log; the team ran the tests and checked the conclusions
  - Documentation: CLAUDE.md, TODO.md, PROGRESS_LOG.md and a first draft of these slides
- Team-owned: hardware build, wiring and power system, requirement and design decisions, test design, execution, and final review of every result
- Full record of work: PROGRESS_LOG.md and the git history in the team repository
