derek-weissinger-usafa/Astro-331-Lab-8/Reports/figures/sim3_hold_and_wheel_failure.png

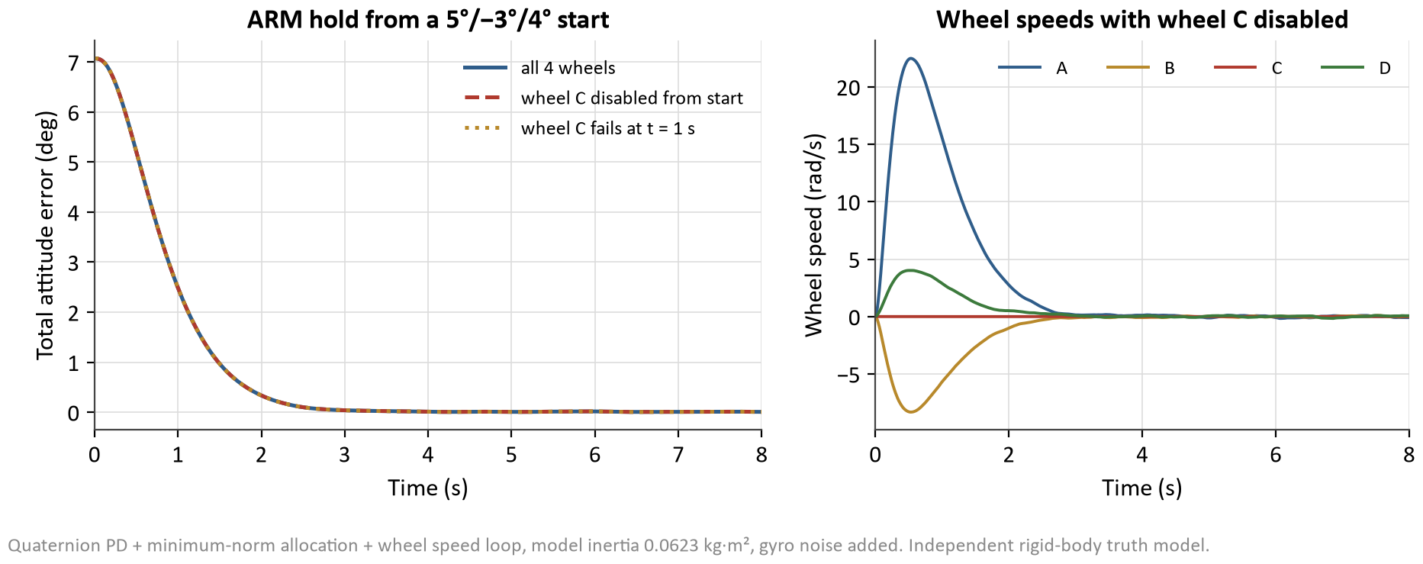
Reports/figures/sim3_hold_and_wheel_failure.png
