derek-weissinger-usafa/Astro-331-Lab-8/teensy_pin_out.pdf

# Welcome to Teensy 4.1

To begin using Teensy, please visit the website & click Getting Started.

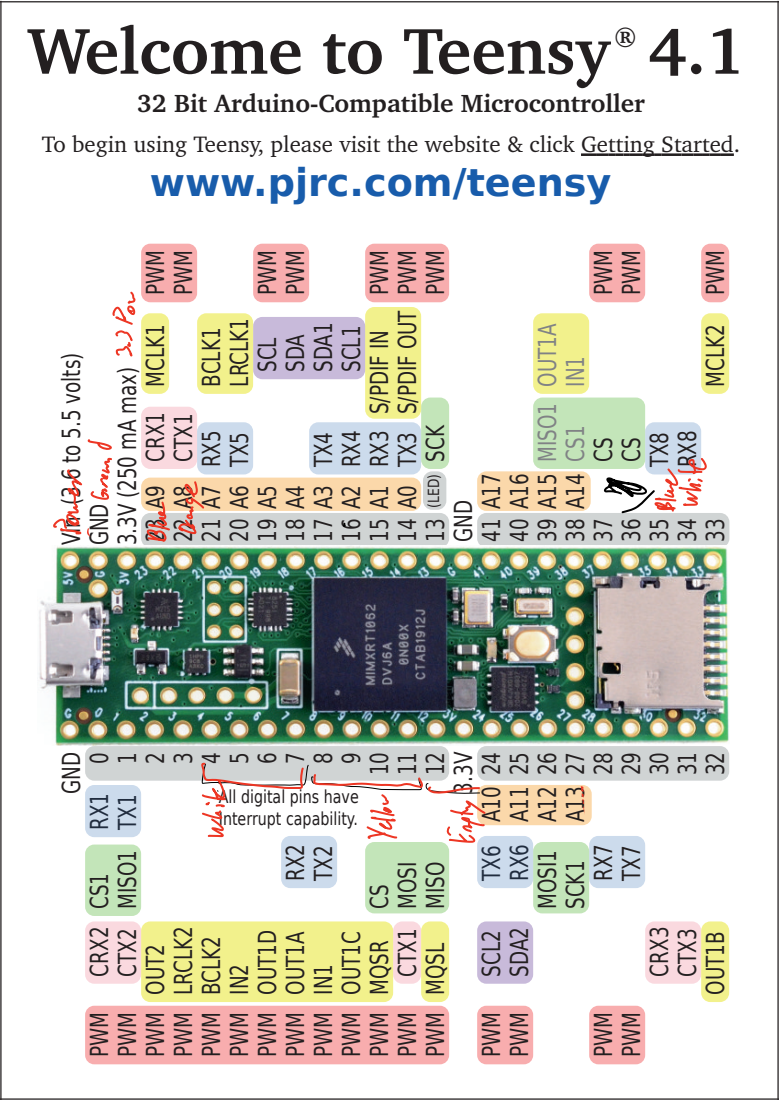
[picture p154: page 1]
Vin (3.6; olt; MIS; 1 MIS; SI MIS; Interrupt capability.; DIF IN; DIF; ATE

32 Bit Arduino-Compatible Microcontroller
www.pjrc.com/teensy

All digital pins have

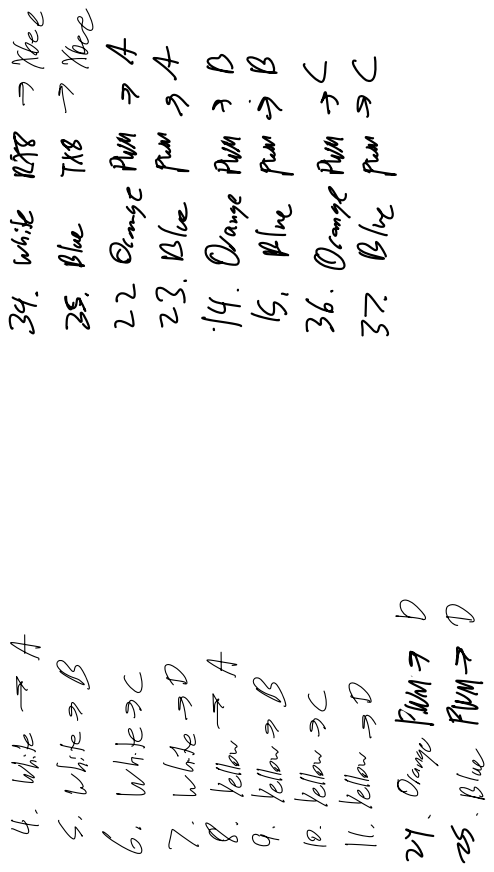
[picture p155: page 2]
ÉÉ Iii
