derek-weissinger-usafa/Astro-331-Lab-8/Astro 331 Lab 8/src/main.cpp

#include <Arduino.h>

#include "attitude_ctrl.h"
#include "attitude_ekf.h"
#include "command_link.h"
#include "control_params.h"
#include "data_logger.h"
#include "demo_spin.h"
#include "full_demo.h"
#include "slew_test.h"
#include "step_test.h"
#include "frames.h"
#include "imu_bno085.h"
#include "mag_aid.h"
#include "mag_map.h"
#include "mag_test.h"
#include "null_bias.h"
#include "tune.h"
#include "pins.h"
#include "wheel_fault.h"
#include "wheel_geometry.h"
#include "wheel_motor.h"
#include "wheel_speed_ctrl.h"

// Reaction-wheel attitude hold (level, yaw 0) on a BNO085 gyro+accel MEKF.
// States: Calibrating (hold still, ~3 s) -> Idle (wheels off) -> Armed (hold).
// Commands arrive over the XBee (Serial8) and, for bench use, USB Serial.
// Sensors and control run at 100 Hz. One data row per gyro sample (~100 Hz) streams to the
// XBee (every kXbeeLogDecimation-th row) and, after "BEGIN STATIC TEST", to an SD file until
// power is removed (data_logger.h). No SD file is created at boot.
// "DEMO SPIN" runs the level-then-spin demonstration (demo_spin.h) in the Armed state.

using namespace wheel_geometry;

static Bno085Imu imu(kPinImuReset, kPinImuInt);
static AttitudeEKF ekf;
static AttitudeController ctrl;
static CommandLink xbee(XBEE_SERIAL);
static CommandLink usb(Serial);
static DataLogger logger(XBEE_SERIAL);
static DemoSpin demo;
static SlewTest slew;
static MagAid magAid;  // magnetometer heading aid (mag_aid.h)
static MagTest magTest;  // MAG TEST: fixed-table validation of the aid (mag_test.h)
static StepTest stepTest;  // STEP TEST: heading steps on top of DEMO LEVEL (step_test.h)
static FullDemo fullDemo;  // DEMO ALL: hold -> SLEW YAW -> FAULT TEST in one armed run (full_demo.h)
// Heading holds: null-mode bias keeping every wheel >= tune::holdMinRadS from zero (null_bias.h).
static NullBias holdBias;
static uint32_t lastMagUs = 0;
static bool haveLastMag = false;
static MagResult lastMagResult = MagResult::Gated;

// Serial8's built-in TX buffer is only 40 bytes; without this, any line longer than
// that (data rows, STATUS replies) is always dropped by the non-blocking senders.
static uint8_t xbeeTxExtra[1024];

static WheelMotor wheels[kN] = {
    WheelMotor(kPinWheelPwm1[0], kPinWheelPwm2[0], kPinWheelEncA[0], kPinWheelEncB[0],
               params::kMotorSign[0], params::kEncoderSign[0]),
    WheelMotor(kPinWheelPwm1[1], kPinWheelPwm2[1], kPinWheelEncA[1], kPinWheelEncB[1],
               params::kMotorSign[1], params::kEncoderSign[1]),
    WheelMotor(kPinWheelPwm1[2], kPinWheelPwm2[2], kPinWheelEncA[2], kPinWheelEncB[2],
               params::kMotorSign[2], params::kEncoderSign[2]),
    WheelMotor(kPinWheelPwm1[3], kPinWheelPwm2[3], kPinWheelEncA[3], kPinWheelEncB[3],
               params::kMotorSign[3], params::kEncoderSign[3]),
};
static WheelSpeedLoop speedLoops[kN];
static bool wheelEnabled[kN] = {true, true, true, true};  // fault-handling hook
// Encoder fault detection (wheelLoop): a wheel driven hard that never shows speed, or whose
// speed jumps faster than the motor could accelerate it, is disabled (wheelEnabled = false).
// 2026-10-27: wheel D's encoder lost a channel; D spun at ~500 rpm reading 0 and glitched to
// -165 rad/s while still, which disarmed and even drove D through its own speed loop.
static float encFaultS[kN] = {0, 0, 0, 0};
static float prevSpeed[kN] = {0, 0, 0, 0};
// Dead-motor detection (requirement 3, wheel_fault.h): a wheel driven hard that doesn't accelerate
// is disabled and then coasts (wheelDead). FAULT TEST injects such a failure and grades recovery.
static DeadMotorDetector deadDet[kN];
static bool wheelDead[kN] = {false, false, false, false};
static FaultTest fault;
static float wheelCmd[kN] = {0, 0, 0, 0};                 // wheel speed setpoints, rad/s
static float manualTarget[kN] = {0, 0, 0, 0};             // SPEED targets; wheelCmd ramps to these
static float manualSpeed[kN] = {0, 0, 0, 0};              // low-passed wheel speed, rad/s (Manual)

// Manual: each wheel's speed loop tracks a setpoint typed with SPEED (bench / spin-up).
enum class State : uint8_t { Calibrating, Idle, Armed, Manual };
static State state = State::Calibrating;
static char stateChar() {
  switch (state) {
    case State::Calibrating: return 'C';
    case State::Idle: return 'I';
    case State::Armed: return 'A';
    default: return 'M';
  }
}

// ---- Static calibration accumulators ----
static constexpr float kCalMaxGyroStd = 0.01f;    // rad/s per axis, else "not still"
static constexpr float kCalMaxGyroMean = 0.05f;   // rad/s, rejects a rotating table
static constexpr uint32_t kMinCalSamples = 100;

static uint32_t calStartMs = 0, calProgressMs = 0;
static uint32_t calDurationMs = params::kCalDurationMs;  // boot default; CALIBRATE <s> overrides
static uint32_t calGyroN = 0, calAccelN = 0;
static double gSum[3], gSumSq[3], aSum[3];

// ---- IMU sample-loss diagnostics (gyro stream, all states) ----
// seqMissed: reports the BNO085 sent but the Teensy never received (gaps in its sequence number).
// chipGaps:  intervals > kImuGapMs with NO sequence gap, i.e. the BNO085 itself sent late.
static uint8_t lastGyroSeq = 0;
static uint32_t lastGyroSeqUs = 0;
static bool haveGyroSeq = false;
static uint32_t seqMissed = 0, chipGaps = 0;
static float maxGyroGapMs = 0.0f;

static uint32_t lastGyroUs = 0, lastGyroMs = 0;
static bool haveLastGyro = false;
static uint32_t lastUsbMs = 0, lastWheelUs = 0;
// RAW ON: USB carries one raw row per magnetometer sample instead of the estimator CSV.
static bool usbRaw = false;
// 64-bit sample clock for log timestamps (micros() wraps every ~71.6 min).
static uint64_t logClockUs = 0;
static uint32_t logLastRawUs = 0;
static bool logClockStarted = false;
static AccelResult lastAccelResult = AccelResult::Applied;

// IMU mounting (tune::imuRoll0Deg / imuPitch0Deg, LEVEL ZERO): every sample is rotated by
// mountT = A(q_mount)^T from the IMU frame into the table frame. Rebuilt when SET changes them.
static Mat<3, 3> mountT;
static bool mountOn = false;
static uint32_t mountVersion = 0xFFFFFFFF;
// LEVEL ZERO: averaging the raw accelerometer (deck level) for kLevelZeroS, then CALIBRATE.
static bool levelZeroActive = false;
static uint32_t levelZeroStartMs = 0, levelZeroN = 0;
static double levelZeroSum[3];

static void updateMount() {
  if (mountVersion == tune::version()) return;
  mountVersion = tune::version();
  mountOn = tune::imuRoll0Deg != 0.0f || tune::imuPitch0Deg != 0.0f;
  const Mat<3, 3> A = qToMatrix(qFromEuler321(tune::imuRoll0Deg * kDegToRad, tune::imuPitch0Deg * kDegToRad, 0.0f));
  for (int r = 0; r < 3; r++)
    for (int c = 0; c < 3; c++) mountT(r, c) = A(c, r);
}

static Vec3 toTable(const Vec3& v) {
  if (!mountOn) return v;
  return {mountT(0, 0) * v.x + mountT(0, 1) * v.y + mountT(0, 2) * v.z,
          mountT(1, 0) * v.x + mountT(1, 1) * v.y + mountT(1, 2) * v.z,
          mountT(2, 0) * v.x + mountT(2, 1) * v.y + mountT(2, 2) * v.z};
}

// Latest raw sensor values, for the data log (updated in every state).
static Vec3 latestGyro{0, 0, 0}, latestAccel{0, 0, 0}, latestMag{0, 0, 0};

// Bench wheel test (Idle only)
static int testWheel = -1;
static float testDuty = 0.0f;
static uint32_t testEndMs = 0;

static void sayAll(const char* msg) {
  xbee.send(msg);
  usb.send(msg);
}

static void stopAllWheels() {
  for (int i = 0; i < kN; i++) wheels[i].stop();
}

// MAG MAP progress: current schedule step (-1 = not running) and when it started.
static int magStep = -1;
static uint32_t magStepStartMs = 0;

static void disarm(const char* reason) {
  stopAllWheels();
  testWheel = -1;
  demo.abort();
  slew.abort();
  magStep = -1;
  if (state == State::Armed || state == State::Manual) state = State::Idle;
  char msg[96];
  if (magTest.active()) {
    snprintf(msg, sizeof(msg), "# MAGTEST STOPPED at step %d/%d: %d/%d PASS so far\n", magTest.index() + 1,
             magTest.total(), magTest.passCount(), magTest.doneCount());
    sayAll(msg);
    magTest.abort();
  }
  if (stepTest.active()) {
    snprintf(msg, sizeof(msg), "# STEP TEST STOPPED in segment %d/%d\n", stepTest.index(), StepTest::kSteps);
    sayAll(msg);
    stepTest.abort();
  }
  snprintf(msg, sizeof(msg), "# DISARM %s\n", reason);
  sayAll(msg);
  if (fault.active()) {
    fault.abort();
    sayAll("# FAULT TEST ABORTED (disarmed)\n");
  }
  if (fullDemo.active()) {
    if (fullDemo.phase() == FullDemo::Phase::Done) {
      sayAll("# DEMO ALL ENDED\n");
    } else {
      snprintf(msg, sizeof(msg), "# DEMO ALL STOPPED in part %d/3\n", fullDemo.part());
      sayAll(msg);
    }
    fullDemo.abort();
  }
}

// ---- Wheel failure (requirement 3) ----
static char wheelChar(int i) { return i < 0 ? '?' : (char)('A' + i); }

// 4-char wheel status for STATUS and the log: '.' in service, 'x' in service but its motor is
// failed by FAULT TEST (not detected yet), 'D' dead motor detected (out of service, coasting),
// '-' out of service (WHEEL x OFF or encoder fault).
static void wheelStatus(char out[kN + 1]) {
  for (int i = 0; i < kN; i++)
    out[i] = wheelEnabled[i] ? (wheels[i].simulatedDead() ? 'x' : '.') : (wheelDead[i] ? 'D' : '-');
  out[kN] = '\0';
}

// DEMO ALL summary (full_demo.h): all three parts on one line, then it keeps holding until STOP.
static void finishFullDemo(bool faultRan) {
  char part3[64] = "not run";
  if (faultRan)
    snprintf(part3, sizeof(part3), "wheel %c %s", wheelChar(fault.wheel()), fault.pass() ? "PASS" : "FAIL");
  char msg[224];
  snprintf(msg, sizeof(msg),
           "# DEMO ALL COMPLETE: 1 heading hold %s (max %.2f deg), 2 slews %d/%d PASS, 3 wheel failure %s; "
           "holding until STOP\n",
           fullDemo.holdPass() ? "PASS" : "FAIL", fullDemo.holdMaxErrDeg(), slew.passCount(), params::kSlewNumTargets,
           part3);
  sayAll(msg);
  fullDemo.setPhase(FullDemo::Phase::Done);
}

static void reportFault(FaultTest::Event ev) {
  char msg[200];
  const Vec3 pk = fault.peakErrDeg(), hm = fault.holdMaxDeg();
  switch (ev) {
    case FaultTest::Event::Inject:
      wheels[fault.wheel()].setSimulatedDead(true);
      snprintf(msg, sizeof(msg), "# FAULT TEST: wheel %c motor now DEAD (simulated; controller not told)\n",
               wheelChar(fault.wheel()));
      break;
    case FaultTest::Event::Recovered:
      snprintf(msg, sizeof(msg),
               "# FAULT TEST: back within +/-%.1f deg %.1f s after the %s, peak err %.2f %.2f %.2f deg; holding %.0f s\n",
               params::kFaultTolDeg, fault.recoverS(), fault.real() ? "detection" : "failure", pk.x, pk.y, pk.z,
               params::kFaultHoldS);
      break;
    case FaultTest::Event::Pass:
    case FaultTest::Event::Fail: {
      char det[24] = "n/a (REAL)";
      if (!fault.real()) snprintf(det, sizeof(det), "%.2f s", fault.detectS());
      snprintf(msg, sizeof(msg),
               "# FAULT TEST %s%s%s: wheel %c, detected %s, recovered %.1f s, peak err %.2f %.2f %.2f, hold max "
               "%.2f %.2f %.2f deg\n",
               fault.pass() ? "PASS" : "FAIL", fault.pass() ? "" : " - ", fault.failReason(),
               wheelChar(fault.wheel()), det, fault.recoverS(), pk.x, pk.y, pk.z, hm.x, hm.y, hm.z);
      break;
    }
    default:
      return;
  }
  sayAll(msg);
  if ((ev == FaultTest::Event::Pass || ev == FaultTest::Event::Fail) && fullDemo.phase() == FullDemo::Phase::Fault)
    finishFullDemo(true);
}

// A detector took wheel i out of service: tell the fault test.
static void onWheelFailed(int i) {
  const FaultTest::Event ev = fault.onFailure(i);
  if (ev != FaultTest::Event::None) reportFault(ev);
}

static void startFaultTest(const Command& c, CommandLink& from) {
  if (state != State::Idle && state != State::Armed) {
    from.send("# FAULT TEST REFUSED: Idle or Armed only\n");
    return;
  }
  if (fault.active()) {
    from.send("# FAULT TEST REFUSED: already running\n");
    return;
  }
  if (c.wheel >= 0 && (!wheelEnabled[c.wheel] || wheels[c.wheel].simulatedDead())) {
    from.send("# FAULT TEST REFUSED: that wheel is already out of service\n");
    return;
  }
  int n = 0;
  for (int i = 0; i < kN; i++) n += wheelEnabled[i] ? 1 : 0;
  const float delay = c.hasValue ? c.value : params::kFaultDelayS;
  fault.start(c.wheel, delay);
  if (n < kN) {
    fault.setWheelBias(0.0f);  // the null mode needs all four wheels
    sayAll("# FAULT TEST WARNING: not all 4 wheels in service - no wheel bias; one more failure may leave too few\n");
  }
  char msg[128];
  if (fault.real()) {
    snprintf(msg, sizeof(msg), "# FAULT TEST REAL: watching for a dead motor - remove power from one wheel%s\n",
             state == State::Armed ? " now" : " once Armed");
  } else {
    snprintf(msg, sizeof(msg), "# FAULT TEST: wheel %c motor fails after %.0f s Armed%s\n", 'A' + c.wheel, delay,
             state == State::Armed ? "" : " (now start ARM / DEMO LEVEL / SLEW TEST)");
  }
  sayAll(msg);
}

static void clearFaults(CommandLink& from) {
  if (state != State::Idle) {
    from.send("# FAULT CLEAR REFUSED: not idle\n");
    return;
  }
  fault.abort();
  for (int i = 0; i < kN; i++) {
    wheels[i].setSimulatedDead(false);
    if (wheelDead[i]) wheelEnabled[i] = true;
    wheelDead[i] = false;
    deadDet[i].reset();
    encFaultS[i] = 0.0f;
    prevSpeed[i] = wheels[i].speed();
  }
  char ws[kN + 1];
  wheelStatus(ws);
  char msg[64];
  snprintf(msg, sizeof(msg), "# FAULT CLEAR: wheels %s\n", ws);
  sayAll(msg);
}

static void arm(CommandLink& from) {
  if (state != State::Idle) {
    from.send("# ARM REFUSED: not idle\n");
    return;
  }
  const Vec3 e = ekf.eulerRad();
  const float lim = params::kMaxTiltDeg * kDegToRad;
  if (fabsf(e.x) > lim || fabsf(e.y) > lim) {
    from.send("# ARM REFUSED: tilt too large\n");
    return;
  }
  ctrl.reset();
  ctrl.setReference({1.0f, 0.0f, 0.0f, 0.0f});  // level, yaw 0
  holdBias.reset();
  for (int i = 0; i < kN; i++) {
    speedLoops[i].reset();
    wheelCmd[i] = wheels[i].speed();
  }
  state = State::Armed;
  sayAll("# ARMED\n");
}

// Total wheel angular momentum in the body frame: h = sum a_i J (w_i + a_i . omega).
static Vec3 wheelMomentum(const Vec3& omega) {
  Vec3 h{0, 0, 0};
  for (int i = 0; i < kN; i++) {
    const Vec3 a = axis(i);
    h = h + a * (params::kWheelInertia * (wheels[i].speed() + dot(a, omega)));
  }
  return h;
}

// Highest demo yaw rate the wheels can absorb: margin * sum(a_i.z) J w_max / I_zz, capped at
// the requested 30 rpm. Only enabled wheels count.
static float demoTargetRate() {
  float az = 0.0f;
  bool all = true;
  for (int i = 0; i < kN; i++) {
    if (wheelEnabled[i]) az += fabsf(axis(i).z);
    all = all && wheelEnabled[i];
  }
  // The null-mode wheel bias (all four wheels only) uses part of each wheel's speed range.
  const float usable = params::kWheelMaxSpeedRadS - (all ? params::kDemoWheelBiasRadS : 0.0f);
  const float cap = params::kDemoMomentumMargin * az * params::kWheelInertia * usable / tune::inertia[2];
  return cap < params::kDemoRequestedRateRadS ? cap : params::kDemoRequestedRateRadS;
}

// DEMO LEVEL summary: total time armed and how long level (within tolerance) was held.
static void reportLevelHold(const char* why) {
  char msg[112];
  const Vec3 e = ekf.eulerRad() * kRadToDeg;
  snprintf(msg, sizeof(msg), "# %s: armed %.1f s, rest tilt held %.1f s, roll %.2f pitch %.2f deg\n", why,
           demo.elapsed(), demo.levelHoldTime(), e.x, e.y);
  sayAll(msg);
}

// levelOnly: DEMO LEVEL (level and hold, no spin). Otherwise DEMO SPIN.
static void startDemo(CommandLink& from, bool levelOnly) {
  if (state != State::Idle) {
    from.send("# DEMO REFUSED: not idle (wait for calibration / DISARM first)\n");
    return;
  }
  const Vec3 e = ekf.eulerRad();
  const float lim = params::kMaxTiltDeg * kDegToRad;
  if (fabsf(e.x) > lim || fabsf(e.y) > lim) {
    from.send("# DEMO REFUSED: tilt over 30 deg\n");
    return;
  }
  for (int i = 0; i < kN; i++) {
    if (fabsf(wheels[i].speed()) > params::kDemoStartMaxWheelRadS) {
      from.send("# DEMO REFUSED: wheels still turning\n");
      return;
    }
  }
  if (!logger.sdActive()) logger.startFile("DEMO");  // record the run if nothing is logging yet

  const float rate = demoTargetRate();
  ctrl.reset();
  holdBias.reset();
  demo.start(ekf.quaternion(), rate, levelOnly);
  ctrl.setTrajectory(demo.ref().q, demo.ref().w, demo.ref().a);
  for (int i = 0; i < kN; i++) {
    speedLoops[i].reset();
    wheelCmd[i] = wheels[i].speed();
  }
  state = State::Armed;
  char msg[128];
  if (levelOnly) {
    snprintf(msg, sizeof(msg), "# DEMO LEVEL START: holding the natural rest tilt (STOP to end)%s%s\n",
             logger.sdActive() ? ", log " : "", logger.sdActive() ? logger.fileName() : "");
  } else {
    snprintf(msg, sizeof(msg), "# DEMO START: leveling, then spin CCW to %.2f rad/s (%.1f rpm)%s%s\n", rate,
             rate * 60.0f / 6.2831853f, logger.sdActive() ? ", log " : "",
             logger.sdActive() ? logger.fileName() : "");
  }
  sayAll(msg);
}

// ---- SLEW TEST (stretch requirement) ----
static void sayTarget(const char* head, int i) {
  char msg[128];
  if (slew.tilt()) {
    const SlewTest::Target& g = slew.tiltTarget(i);
    snprintf(msg, sizeof(msg), "# %s %d: roll %+.1f pitch %+.1f deg from the rest tilt, yaw %+.1f deg (rel. to start)\n",
             head, i + 1, g.rollDeg, g.pitchDeg, g.yawDeg);
    sayAll(msg);
    return;
  }
  const SlewTest::Target& g = slew.target(i);
  if (slew.yawOnly()) {
    snprintf(msg, sizeof(msg), "# %s %d: yaw %+.1f deg (rel. to start) at the rest tilt\n", head, i + 1, g.yawDeg);
    sayAll(msg);
    return;
  }
  snprintf(msg, sizeof(msg), "# %s %d: roll %.1f pitch %.1f yaw %+.1f deg (yaw rel. to start)\n", head, i + 1,
           g.rollDeg, g.pitchDeg, g.yawDeg);
  sayAll(msg);
}

static void sayTiltTarget(const char* head, int i) {
  const SlewTest::Target& g = slew.tiltTarget(i);
  char msg[128];
  snprintf(msg, sizeof(msg), "# %s %d: roll %+.1f pitch %+.1f deg from the rest tilt, yaw %+.1f deg (rel. to start)\n",
           head, i + 1, g.rollDeg, g.pitchDeg, g.yawDeg);
  sayAll(msg);
}

static void reportSlewResult(int i) {
  const SlewTest::Result& r = slew.result(i);
  char msg[176];
  if (slew.yawOnly()) {
    snprintf(msg, sizeof(msg),
             "# SLEW %d/%d %s: %s, max err yaw %.2f deg, roll %.2f pitch %.2f from the rest tilt (%.2f, %.2f) over %.0f s\n",
             i + 1, params::kSlewNumTargets, r.pass ? "PASS" : "FAIL", r.settled ? "settled" : "NOT settled",
             r.maxErrDeg.z, r.maxErrDeg.x, r.maxErrDeg.y, r.restRollDeg, r.restPitchDeg, params::kSlewHoldS);
    sayAll(msg);
    return;
  }
  if (slew.tilt()) {
    const SlewTest::Target& g = slew.tiltTarget(i);
    snprintf(msg, sizeof(msg),
             "# SLEW %d/%d %s: %s, max err roll %.2f pitch %.2f yaw %.2f deg over %.0f s (target rest %.2f/%.2f %+.1f/%+.1f)\n",
             i + 1, params::kSlewNumTargets, r.pass ? "PASS" : "FAIL", r.settled ? "settled" : "NOT settled",
             r.maxErrDeg.x, r.maxErrDeg.y, r.maxErrDeg.z, params::kSlewHoldS, r.restRollDeg, r.restPitchDeg,
             g.rollDeg, g.pitchDeg);
    sayAll(msg);
    return;
  }
  snprintf(msg, sizeof(msg), "# SLEW %d/%d %s: %s, max err roll %.2f pitch %.2f yaw %.2f deg over %.0f s\n", i + 1,
           params::kSlewNumTargets, r.pass ? "PASS" : "FAIL", r.settled ? "settled" : "NOT settled",
           r.maxErrDeg.x, r.maxErrDeg.y, r.maxErrDeg.z, params::kSlewHoldS);
  sayAll(msg);
}

static void sayNextSlew() {
  char msg[112];
  snprintf(msg, sizeof(msg), "# SLEW %d/%d: %.1f deg in %.1f s\n", slew.index() + 1, params::kSlewNumTargets,
           slew.slewAngleDeg(), slew.slewDuration());
  sayAll(msg);
}

static const char* slewName(SlewTest::Mode m) {
  return m == SlewTest::Mode::YawOnly ? "YAW" : m == SlewTest::Mode::Tilt ? "TILT" : "TEST";
}

static void startSlew(CommandLink& from, SlewTest::Mode mode) {
  if (state != State::Idle || demo.active()) {
    from.send("# SLEW REFUSED: not idle (wait for calibration / DISARM first)\n");
    return;
  }
  const Vec3 e = ekf.eulerRad();
  const float lim = params::kMaxTiltDeg * kDegToRad;
  if (fabsf(e.x) > lim || fabsf(e.y) > lim) {
    from.send("# SLEW REFUSED: tilt over 30 deg\n");
    return;
  }
  for (int i = 0; i < kN; i++) {
    if (fabsf(wheels[i].speed()) > params::kDemoStartMaxWheelRadS) {
      from.send("# SLEW REFUSED: wheels still turning\n");
      return;
    }
  }
  if (mode == SlewTest::Mode::Tilt) {
    // Tilted targets need the gravity stiffness, and each must fit the wheels' x/y momentum.
    if (tune::gravK <= 0.0f) {
      from.send("# SLEW TILT REFUSED: set GRAV_K first (N m/rad = I (2 pi / swing period)^2)\n");
      return;
    }
    const float cap = SlewTest::tiltCapacity();
    for (int i = 0; i < params::kSlewNumTargets; i++) {
      const float h = slew.tiltBudget(i, tune::gravK);
      if (h > params::kTiltBudgetFrac * cap) {
        const SlewTest::Target& g = slew.tiltTarget(i);
        const float off = sqrtf(g.rollDeg * g.rollDeg + g.pitchDeg * g.pitchDeg);
        char msg[160];
        snprintf(msg, sizeof(msg),
                 "# SLEW TILT REFUSED: target %d needs %.1f mN m s, limit %.1f: reduce its tilt to <= %.1f deg (now %.1f)\n",
                 i + 1, h * 1e3f, params::kTiltBudgetFrac * cap * 1e3f, off * params::kTiltBudgetFrac * cap / h, off);
        from.send(msg);
        return;
      }
    }
  }
  if (!logger.sdActive()) logger.startFile("SLEW");
  ctrl.reset();
  slew.start(ekf.quaternion(), mode, tune::gravK);
  ctrl.setTrajectory(slew.refQ(), slew.refW(), slew.refA());
  for (int i = 0; i < kN; i++) {
    speedLoops[i].reset();
    wheelCmd[i] = wheels[i].speed();
  }
  state = State::Armed;
  char msg[96];
  snprintf(msg, sizeof(msg), "# SLEW %s START: %d targets, +/-%.1f deg, hold %.0f s%s%s\n", slewName(mode),
           params::kSlewNumTargets, params::kSlewTolDeg, params::kSlewHoldS, logger.sdActive() ? ", log " : "",
           logger.sdActive() ? logger.fileName() : "");
  sayAll(msg);
  for (int i = 0; i < params::kSlewNumTargets; i++) sayTarget("SLEW target", i);
  if (mode == SlewTest::Mode::Tilt) {
    snprintf(msg, sizeof(msg), "# SLEW TILT: rest-tilt scan, 360 deg in %.0f s (roll/pitch free)\n",
             slew.slewDuration());
    sayAll(msg);
  } else {
    sayNextSlew();
  }
}

// ---- DEMO ALL (full_demo.h): hold -> SLEW YAW -> FAULT TEST without disarming ----
static void startFullDemo(const Command& c, CommandLink& from) {
  if (state != State::Idle) {
    from.send("# DEMO ALL REFUSED: not idle (wait for calibration / DISARM first)\n");
    return;
  }
  // Part 3 needs a spare wheel: all four in service, none failed by an earlier FAULT TEST.
  for (int i = 0; i < kN; i++) {
    if (!wheelEnabled[i] || wheels[i].simulatedDead()) {
      from.send("# DEMO ALL REFUSED: needs all 4 wheels in service (FAULT CLEAR / WHEEL x ON first)\n");
      return;
    }
  }
  if (fault.active()) {
    from.send("# DEMO ALL REFUSED: a FAULT TEST is pending (FAULT CLEAR first)\n");
    return;
  }
  float hold = c.hasValue ? c.value : params::kFullHoldS;
  if (hold < params::kFullHoldMinS) hold = params::kFullHoldMinS;
  if (hold > params::kFullHoldMaxS) hold = params::kFullHoldMaxS;
  const int w = c.wheel >= 0 ? c.wheel : params::kFullFaultWheel;
  startDemo(from, true);  // DEMO LEVEL; refuses (and says why) unless the tilt is ok and the wheels stopped
  if (!demo.active()) return;
  fullDemo.start(hold, w);
  char msg[200];
  snprintf(msg, sizeof(msg),
           "# DEMO ALL: 1 heading hold %.0f s once settled, 2 SLEW YAW (%d targets), 3 wheel %c fails %.0f s after "
           "the slews; STOP ends it\n",
           hold, params::kSlewNumTargets, wheelChar(w), params::kFaultDelayS);
  sayAll(msg);
}

// Part 1 done: grade it and hand the held heading to SLEW YAW (no reset: the wheels keep their speeds).
static void beginFullSlew() {
  char msg[200];
  snprintf(msg, sizeof(msg),
           "# DEMO ALL 1/3 %s: heading max err %.2f deg, jitter %.3f deg rms, drift %+.3f deg over %.0f s (estimate)\n",
           fullDemo.holdPass() ? "PASS" : "FAIL", fullDemo.holdMaxErrDeg(), fullDemo.holdJitterDeg(),
           fullDemo.holdDriftDeg(), fullDemo.holdS());
  sayAll(msg);
  const float yaw0 = demo.startYaw();
  demo.abort();
  slew.start(ekf.quaternion(), SlewTest::Mode::YawOnly, 0.0f, yaw0);
  ctrl.setTrajectory(slew.refQ(), slew.refW(), slew.refA());
  fullDemo.setPhase(FullDemo::Phase::Slew);
  sayAll("# DEMO ALL 2/3: SLEW YAW from the held heading\n");
  for (int i = 0; i < params::kSlewNumTargets; i++) sayTarget("SLEW target", i);
  sayNextSlew();
}

// Part 2 done (SLEW YAW now holds the start heading): fail the wheel after kFaultDelayS.
static void beginFullFault() {
  const int w = fullDemo.faultWheel();
  for (int i = 0; i < kN; i++) {
    if (!wheelEnabled[i]) {
      // A real failure already happened (and was handled): failing another could leave too few.
      char msg[112];
      snprintf(msg, sizeof(msg), "# DEMO ALL 3/3 SKIPPED: wheel %c is already out of service\n", wheelChar(i));
      sayAll(msg);
      finishFullDemo(false);
      return;
    }
  }
  fault.start(w, params::kFaultDelayS);
  fullDemo.setPhase(FullDemo::Phase::Fault);
  char msg[112];
  snprintf(msg, sizeof(msg), "# DEMO ALL 3/3: wheel %c motor fails in %.0f s (read the laser now)\n", wheelChar(w),
           params::kFaultDelayS);
  sayAll(msg);
}

// Called every control step while the slew test runs. Returns false if it disarmed.
static bool stepSlew(float dt, const Vec3& hWheels) {
  switch (slew.step(dt, ekf.quaternion(), hWheels)) {
    case SlewTest::Event::ScanDone: {
      const float* r = slew.restRollFitDeg();
      const float* p = slew.restPitchFitDeg();
      char msg[176];
      snprintf(msg, sizeof(msg),
               "# SLEW TILT scan: rest roll %.2f %+.2f cos %+.2f sin, pitch %.2f %+.2f cos %+.2f sin deg (heading wave %.2f / %.2f)\n",
               r[0], r[1], r[2], p[0], p[1], p[2], sqrtf(r[1] * r[1] + r[2] * r[2]), sqrtf(p[1] * p[1] + p[2] * p[2]));
      sayAll(msg);
      break;
    }
    case SlewTest::Event::UnloadDone: {
      char msg[128];
      snprintf(msg, sizeof(msg), "# SLEW %d/%d unloaded: |h_xy| %.1f -> %.1f mN m s in %.1f s\n", slew.index() + 1,
               params::kSlewNumTargets, slew.hxyAtUnloadStart() * 1e3f,
               sqrtf(hWheels.x * hWheels.x + hWheels.y * hWheels.y) * 1e3f, slew.lastUnloadS());
      sayAll(msg);
      sayNextSlew();
      break;
    }
    case SlewTest::Event::Settled: {
      char msg[80];
      snprintf(msg, sizeof(msg), "# SLEW %d/%d reached (+/-%.1f deg) %.1f s after the slew, holding\n",
               slew.index() + 1, params::kSlewNumTargets, params::kSlewTolDeg, slew.result(slew.index()).settleS);
      sayAll(msg);
      break;
    }
    case SlewTest::Event::SettleTimeout: {
      const Vec3 e = slew.errorDeg();
      char msg[112];
      snprintf(msg, sizeof(msg), "# SLEW %d/%d NOT reached in %.0f s (err %.2f %.2f %.2f deg), holding anyway\n",
               slew.index() + 1, params::kSlewNumTargets, params::kSlewSettleTimeoutS, e.x, e.y, e.z);
      sayAll(msg);
      break;
    }
    case SlewTest::Event::TargetDone:
      reportSlewResult(slew.index() - 1);
      if (!slew.tilt()) sayNextSlew();  // tilt: announced after unloading
      break;
    case SlewTest::Event::Complete: {
      reportSlewResult(params::kSlewNumTargets - 1);
      char msg[96];
      snprintf(msg, sizeof(msg), "# SLEW %s COMPLETE: %d/%d PASS, holding target %d until STOP\n",
               slewName(slew.mode()), slew.passCount(), params::kSlewNumTargets, params::kSlewNumTargets);
      sayAll(msg);
      if (fullDemo.phase() == FullDemo::Phase::Slew) beginFullFault();
      break;
    }
    default:
      break;
  }
  float wmax = 0.0f;
  for (int i = 0; i < kN; i++) wmax = fmaxf(wmax, fabsf(wheels[i].speed()));
  if (wmax > params::kDemoWheelAbortRadS) {
    char msg[96];
    snprintf(msg, sizeof(msg), "# SLEW %d/%d: wheel at %.0f rad/s (limit), stopping after %.1f s\n",
             slew.index() + 1, params::kSlewNumTargets, wmax, slew.elapsed());
    sayAll(msg);
    disarm("SLEW_WHEEL_LIMIT");
    return false;
  }
  ctrl.setTrajectory(slew.refQ(), slew.refW(), slew.refA());
  return true;
}

static void stopDemo(CommandLink& from) {
  if (!demo.active()) {
    from.send("# STOP: no demo running\n");
    return;
  }
  if (demo.levelOnly()) reportLevelHold("DEMO LEVEL STOPPED");
  switch (demo.requestStop()) {
    case DemoSpin::Event::Complete:
      disarm("DEMO_STOPPED");  // stopped while leveling: nothing is spinning
      break;
    case DemoSpin::Event::SpinDownStarted:
      sayAll("# DEMO STOP: spinning down\n");
      break;
    default:
      from.send("# STOP: already spinning down\n");
      break;
  }
}

// ---- STEP TEST: heading steps on top of DEMO LEVEL (step_test.h) ----
static void startStepTest(const Command& c, CommandLink& from) {
  float amp = c.hasValue ? c.value : params::kStepDefaultDeg;
  if (amp > params::kStepMaxDeg) amp = params::kStepMaxDeg;
  if (amp < -params::kStepMaxDeg) amp = -params::kStepMaxDeg;
  if (amp == 0.0f) amp = params::kStepDefaultDeg;
  startDemo(from, true);  // refuses (and says why) unless Idle, tilt ok, wheels stopped
  if (!demo.active()) return;
  stepTest.start(amp);
  char msg[128];
  snprintf(msg, sizeof(msg),
           "# STEP TEST: once settled, heading +%.1f, 0, -%.1f, 0 deg, %.0f s each (bw %.2f rad/s, zeta %.2f, Izz %.4f)\n",
           amp, amp, params::kStepHoldS, tune::attBw, tune::attZeta, tune::inertia[2]);
  sayAll(msg);
}

// Per control step once DEMO LEVEL has settled. Returns false if it disarmed.
static bool stepStepTest(float dt, float yawRad) {
  float rel = yawRad - demo.startYaw();
  while (rel > 3.14159265f) rel -= 6.2831853f;
  while (rel < -3.14159265f) rel += 6.2831853f;
  const Vec3 omega = ekf.bodyRate();
  const StepTest::Event ev = stepTest.update(dt, rel * kRadToDeg, omega.z, wheelMomentum(omega).z);
  if (ev == StepTest::Event::None) return true;
  const StepTest::Result& r = stepTest.lastResult();
  char msg[176];
  if (ev == StepTest::Event::BaselineDone) {
    snprintf(msg, sizeof(msg), "# STEP baseline: heading error %+.3f deg, jitter %.3f deg rms\n", r.errDeg, r.jitterDeg);
  } else {
    char rise[12] = "n/a", settle[12] = "n/a";
    if (r.riseS >= 0.0f) snprintf(rise, sizeof(rise), "%.2f s", r.riseS);
    if (r.settleS >= 0.0f) snprintf(settle, sizeof(settle), "%.2f s", r.settleS);
    snprintf(msg, sizeof(msg),
             "# STEP %+.1f deg: rise %s, overshoot %.0f%%, settle %s, error %+.3f deg, jitter %.3f deg rms, Izz %.4f, "
             "yaw drag %.3f mN m\n",
             r.targetDeg, rise, r.overshootPct, settle, r.errDeg, r.jitterDeg, r.izz, r.dragMNm);
  }
  sayAll(msg);
  if (ev == StepTest::Event::Complete) {
    snprintf(msg, sizeof(msg), "# STEP TEST COMPLETE: measured Izz %.4f kg m^2 (model %.4f; SET IZZ to use it)\n",
             stepTest.meanIzz(), tune::inertia[2]);
    sayAll(msg);
    disarm("STEP_TEST_COMPLETE");
    return false;
  }
  return true;
}

static void startCalibration(const Command& c, CommandLink& from);

// LEVEL ZERO (Idle, deck level by a spirit level, table clamped): measure how the IMU sits on its
// mount, then recalibrate in the corrected frame.
static void startLevelZero(CommandLink& from) {
  if (state != State::Idle || levelZeroActive) {
    from.send("# LEVEL ZERO REFUSED: not idle\n");
    return;
  }
  levelZeroActive = true;
  levelZeroStartMs = millis();
  levelZeroN = 0;
  levelZeroSum[0] = levelZeroSum[1] = levelZeroSum[2] = 0.0;
  char msg[96];
  snprintf(msg, sizeof(msg), "# LEVEL ZERO: deck must be LEVEL and still; measuring %.0f s\n", params::kLevelZeroS);
  sayAll(msg);
}

static void updateLevelZero(CommandLink& link) {
  if (!levelZeroActive || millis() - levelZeroStartMs < (uint32_t)(params::kLevelZeroS * 1000.0f)) return;
  levelZeroActive = false;
  if (levelZeroN < 100 || state != State::Idle) {
    sayAll("# LEVEL ZERO FAILED: too few samples or not idle\n");
    return;
  }
  const Vec3 a{(float)(levelZeroSum[0] / levelZeroN), (float)(levelZeroSum[1] / levelZeroN),
               (float)(levelZeroSum[2] / levelZeroN)};
  const float n = norm(a);
  const Vec3 u = a * (1.0f / n);  // "up" in the IMU frame with the deck level
  // Same construction as AttitudeEKF::initialize: shortest arc from ez to u, yaw removed.
  Quat q = qnormalize({1.0f + u.z, -u.y, u.x, 0.0f});
  q = qnormalize(qmul(q, qFromRotVec({0.0f, 0.0f, qToEuler321(q).z})));
  const Vec3 e = qToEuler321(q) * kRadToDeg;
  tune::set("IMU_ROLL0", e.x);
  tune::set("IMU_PITCH0", e.y);
  char msg[200];
  snprintf(msg, sizeof(msg),
           "# LEVEL ZERO: IMU sits at roll %+.3f pitch %+.3f deg on the level deck (|a| %.3f m/s^2); applied - put "
           "kImuMountRollDeg/PitchDeg in control_params.h to keep it\n",
           e.x, e.y, n);
  sayAll(msg);
  Command c;
  startCalibration(c, link);  // the filter state is in the old frame: recalibrate (keep still)
}

static void resetCalibration() {
  calStartMs = calProgressMs = millis();
  calGyroN = calAccelN = 0;
  for (int i = 0; i < 3; i++) gSum[i] = gSumSq[i] = aSum[i] = 0.0;
}

// CALIBRATE [seconds]: redo the static gyro-bias calibration (table must stay still). Idle only.
// Best done after ~10 min powered: the BNO085 z bias drifts ~0.007 deg/s (~25 deg/h of yaw)
// over the first ~5 min while the chip warms up (static tests 2026-10-15/16).
static void startCalibration(const Command& c, CommandLink& from) {
  if (state != State::Idle) {
    from.send("# CALIBRATE REFUSED: not idle\n");
    return;
  }
  if (c.hasValue) {
    float s = c.value;
    if (s < 10.0f) s = 10.0f;
    if (s > 900.0f) s = 900.0f;
    calDurationMs = (uint32_t)(s * 1000.0f);
  }
  state = State::Calibrating;
  haveLastGyro = false;
  resetCalibration();
  char msg[72];
  snprintf(msg, sizeof(msg), "# CALIBRATING: hold the table still for %lu s\n",
           (unsigned long)(calDurationMs / 1000));
  sayAll(msg);
}

// Track the BNO085's gyro report sequence numbers and arrival gaps.
static void trackGyroSequence(const ImuSample& s) {
  if (haveGyroSeq) {
    const uint8_t dseq = (uint8_t)(s.seq - lastGyroSeq);  // wraps mod 256
    const float gapMs = (uint32_t)(s.t_us - lastGyroSeqUs) * 1.0e-3f;
    if (dseq > 1) seqMissed += dseq - 1;
    if (gapMs > params::kImuGapMs && dseq == 1) chipGaps++;
    if (gapMs > maxGyroGapMs) maxGyroGapMs = gapMs;
  }
  lastGyroSeq = s.seq;
  lastGyroSeqUs = s.t_us;
  haveGyroSeq = true;
}

// Wheel speed as the active loop sees it: low-passed in Manual, raw filter otherwise.
static float shownSpeed(int i) { return state == State::Manual ? manualSpeed[i] : wheels[i].speed(); }

static void printUsbTelemetry() {
  const Quat q = ekf.quaternion();
  const Vec3 e = ekf.eulerRad() * kRadToDeg;
  const Vec3 b = ekf.gyroBias() * kRadToDeg;
  const Vec3 s = ekf.sigmaRad() * kRadToDeg;
  Serial.printf(
      "%lu,%.5f,%.5f,%.5f,%.5f,%.3f,%.3f,%.3f,%.4f,%.4f,%.4f,%.3f,%.3f,%.3f,%d,%.1f,%.1f,%.1f,%.1f,%c,"
      "%.3f,%.3f,%.3f,%.3f,%c,%.2f\n",
      millis(), q.w, q.x, q.y, q.z, e.x, e.y, e.z, b.x, b.y, b.z, s.x, s.y, s.z,
      static_cast<int>(lastAccelResult), shownSpeed(0), shownSpeed(1), shownSpeed(2), shownSpeed(3),
      stateChar(), wheels[0].axisDuty(), wheels[1].axisDuty(), wheels[2].axisDuty(),
      wheels[3].axisDuty(), magAid.modeChar(), magAid.headingResidualDeg());
}

// RAW row (one per magnetometer sample): R,t_us,mag x/y/z (uT),encoder counts A-D,
// wheel speed A-D (rad/s),duty A-D,gyro z (rad/s),EKF yaw (deg),state. Counts give each motor
// shaft's angle (64 counts per motor turn), which sets the static field of its magnets.
static void printRawRow(uint32_t tUs) {
  const Vec3& m = latestMag;
  Serial.printf("R,%lu,%.3f,%.3f,%.3f,%ld,%ld,%ld,%ld,%.2f,%.2f,%.2f,%.2f,%.3f,%.3f,%.3f,%.3f,%.5f,%.3f,%c,%c,%.2f\n",
                (unsigned long)tUs, m.x, m.y, m.z, wheels[0].count(), wheels[1].count(), wheels[2].count(),
                wheels[3].count(), wheels[0].speed(), wheels[1].speed(), wheels[2].speed(), wheels[3].speed(),
                wheels[0].axisDuty(), wheels[1].axisDuty(), wheels[2].axisDuty(), wheels[3].axisDuty(),
                latestGyro.z, ekf.eulerRad().z * kRadToDeg, stateChar(), magAid.modeChar(),
                magAid.headingResidualDeg());
}

// One log row per gyro sample, stamped with that sample's arrival time.
static void logData(uint32_t sampleUs) {
  if (!logClockStarted) {
    logClockUs = sampleUs;
    logClockStarted = true;
  } else {
    logClockUs += (uint32_t)(sampleUs - logLastRawUs);  // wrap-safe delta
  }
  logLastRawUs = sampleUs;

  LogRow r;
  r.ms = (double)logClockUs * 1.0e-3;
  r.gyro = latestGyro;
  r.accel = latestAccel;
  r.mag = latestMag;
  constexpr float kRadSToRpm = 60.0f / 6.2831853f;
  for (int i = 0; i < kN; i++) {
    r.rpm[i] = wheels[i].speed() * kRadSToRpm;
    r.duty[i] = wheels[i].axisDuty();
    r.enc[i] = wheels[i].count();
  }
  r.q = ekf.quaternion();
  r.eulerDeg = ekf.eulerRad() * kRadToDeg;
  r.bias = ekf.gyroBias();
  r.sigmaDeg = ekf.sigmaRad() * kRadToDeg;
  r.accelStatus = static_cast<int>(lastAccelResult);
  r.state = stateChar();
  r.gyroSeq = lastGyroSeq;
  r.seqMissed = seqMissed;
  r.testStep = magTest.active() ? magTest.index() : stepTest.active() ? stepTest.index() : magStep;
  r.magMode = magAid.modeChar();
  r.magResidDeg = magAid.headingResidualDeg();
  if (demo.active()) {
    r.demoPhase = demo.phaseChar();
    r.rateRef = demo.rateRef();
    r.yawRefDeg = demo.yawRef() * kRadToDeg;
  }
  wheelStatus(r.wheelStatus);
  if (state == State::Armed) r.errDeg = ctrl.angleError() * kRadToDeg;
  r.faultPhase = fault.phaseChar();
  if (slew.active()) {  // SLEW TEST: phase S/W/H, |reference rate|, reference yaw, target index
    r.demoPhase = slew.phaseChar();
    r.rateRef = slew.refRate();
    r.yawRefDeg = slew.refYawDeg();
    r.testStep = slew.index();
  }
  logger.logRow(r);
}

// Manual (SPEED) mode: closed-loop speed setpoint for one wheel or all (Command::kAllWheels),
// entering Manual from Idle. Setpoints ramp at kManualAccelRadS2; overspeed disarms.
// ---- MAG MAP: step the wheels through mag_map::kSteps (Manual mode) while logging ----
static void applyMagStep() {
  constexpr float kRpmToRadS = 6.2831853f / 60.0f;
  const mag_map::Step& s = mag_map::kSteps[magStep];
  for (int i = 0; i < kN; i++) manualTarget[i] = s.rpm[i] * kRpmToRadS;
  magStepStartMs = millis();
  char msg[80];
  snprintf(msg, sizeof(msg), "# MAGMAP step %d/%d: A=%d B=%d C=%d D=%d rpm\n", magStep + 1, mag_map::kNumSteps,
           s.rpm[0], s.rpm[1], s.rpm[2], s.rpm[3]);
  sayAll(msg);
}

static void startMagMap(CommandLink& from) {
  if (state != State::Idle) {
    from.send("# MAGMAP REFUSED: not idle (wait for calibration / DISARM first)\n");
    return;
  }
  for (int i = 0; i < kN; i++) {
    if (fabsf(wheels[i].speed()) > params::kDemoStartMaxWheelRadS) {
      from.send("# MAGMAP REFUSED: wheels still turning\n");
      return;
    }
  }
  if (!logger.sdActive()) logger.startFile("MAGMAP");
  testWheel = -1;
  for (int i = 0; i < kN; i++) {
    speedLoops[i].reset();
    wheelCmd[i] = manualTarget[i] = 0.0f;
  }
  state = State::Manual;
  char msg[112];
  snprintf(msg, sizeof(msg), "# MAGMAP START: %d steps x %lu s (~%lu min), table must be FIXED%s%s\n",
           mag_map::kNumSteps, (unsigned long)(params::kMagMapStepMs / 1000),
           (unsigned long)(mag_map::kNumSteps * params::kMagMapStepMs / 60000 + 1),
           logger.sdActive() ? ", log " : ", NO SD LOG", logger.sdActive() ? logger.fileName() : "");
  sayAll(msg);
  magStep = 0;
  applyMagStep();
}

// Called every loop(): advance the schedule; end with the wheels stopped (logging continues).
static void updateMagMap() {
  if (magStep < 0) return;
  if (state != State::Manual) {  // overspeed or another command left Manual mode
    magStep = -1;
    sayAll("# MAGMAP ABORTED: left Manual mode\n");
    return;
  }
  if (millis() - magStepStartMs < params::kMagMapStepMs) return;
  if (++magStep >= mag_map::kNumSteps) {
    disarm("MAGMAP_COMPLETE");  // wheels stop; SD logging continues until power off
    return;
  }
  applyMagStep();
}

// ---- MAG TEST: fixed-table validation of the yaw aid (mag_test.h), Manual mode ----
static void applyMagTestStep() {
  constexpr float kRpmToRadS = 6.2831853f / 60.0f;
  const mag_test::Step& s = magTest.step();
  char pat[kN + 1];
  for (int i = 0; i < kN; i++) {
    manualTarget[i] = s.rpm[i] * kRpmToRadS;
    pat[i] = s.rpm[i] > 0 ? '+' : s.rpm[i] < 0 ? '-' : '0';
  }
  pat[kN] = '\0';
  char msg[112];
  snprintf(msg, sizeof(msg), "# MAGTEST %d/%d%s %s A=%d B=%d C=%d D=%d rpm %u s\n", magTest.index() + 1,
           magTest.total(), magTest.inDrift() ? " drift" : "", pat, s.rpm[0], s.rpm[1], s.rpm[2], s.rpm[3],
           (unsigned)s.s);
  sayAll(msg);
  if (s.kickDeg != 0) {
    ekf.perturbYaw(s.kickDeg * kDegToRad);
    snprintf(msg, sizeof(msg), "# MAGTEST KICK yaw estimate %+d deg (recover within %.0f s)\n", s.kickDeg,
             params::kMagTestRecoverS);
    sayAll(msg);
  }
}

static void reportMagTestStep() {
  const MagTest::Result& r = magTest.lastResult();
  char ws[kN + 1];
  wheelStatus(ws);
  char msg[160];
  if (r.kick) {
    snprintf(msg, sizeof(msg),
             "# MAGTEST %d/%d %s: kick recovered in %.0f s (peak %.1f), then max|yaw| %.2f, end %+.2f deg, aid %.0f%%, "
             "resid %.2f rms, wheels %s\n",
             magTest.doneCount(), magTest.total(), r.pass ? "PASS" : "FAIL", r.recoverS, r.peakDeg, r.maxAbsDeg,
             r.endDeg, r.aidFrac * 100.0f, r.residRmsDeg, ws);
  } else {
    snprintf(msg, sizeof(msg), "# MAGTEST %d/%d %s: max|yaw| %.2f, end %+.2f deg, aid %.0f%%, resid %.2f rms, wheels %s\n",
             magTest.doneCount(), magTest.total(), r.pass ? "PASS" : "FAIL", r.maxAbsDeg, r.endDeg,
             r.aidFrac * 100.0f, r.residRmsDeg, ws);
  }
  sayAll(msg);
}

static void startMagTest(const Command& c, CommandLink& from) {
  if (state != State::Idle) {
    from.send("# MAGTEST REFUSED: not idle (wait for calibration / DISARM first)\n");
    return;
  }
  if (!magAid.enabled()) {
    from.send("# MAGTEST REFUSED: mag aid is off (MAG ON first)\n");
    return;
  }
  for (int i = 0; i < kN; i++) {
    if (fabsf(wheels[i].speed()) > params::kDemoStartMaxWheelRadS) {
      from.send("# MAGTEST REFUSED: wheels still turning\n");
      return;
    }
  }
  float minutes = c.hasValue ? c.value : params::kMagTestDriftMin;
  if (minutes < 0.0f) minutes = 0.0f;
  if (minutes > params::kMagTestDriftMaxMin) minutes = params::kMagTestDriftMaxMin;
  const int driftSteps = (int)ceilf(minutes * 60.0f / mag_test::kDriftStepS);
  if (!logger.sdActive()) logger.startFile("MAGTEST");
  testWheel = -1;
  for (int i = 0; i < kN; i++) {
    speedLoops[i].reset();
    wheelCmd[i] = manualTarget[i] = 0.0f;
  }
  state = State::Manual;
  magTest.start(driftSteps);
  float totalS = driftSteps * mag_test::kDriftStepS;
  for (int i = 0; i < mag_test::kNumMain; i++) totalS += mag_test::kMain[i].s;
  char ws[kN + 1];
  wheelStatus(ws);
  char msg[160];
  snprintf(msg, sizeof(msg),
           "# MAGTEST START: %d steps (%d drift), ~%.0f min, |yaw| <= %.1f deg, table must be FIXED, wheels %s, "
           "aid %c%s%s\n",
           magTest.total(), driftSteps, totalS / 60.0f, params::kMagTestTolDeg, ws, magAid.modeChar(),
           logger.sdActive() ? ", log " : ", NO SD LOG", logger.sdActive() ? logger.fileName() : "");
  sayAll(msg);
  if (strcmp(ws, "....") != 0) sayAll("# MAGTEST WARNING: not all 4 wheels in service\n");
  if (magAid.modeChar() == 'x') sayAll("# MAGTEST WARNING: aid is stale (no reference) - CALIBRATE first\n");
  applyMagTestStep();
}

// Per gyro sample while the test runs: grade, then advance the schedule.
static void stepMagTest(float dt) {
  if (!magTest.active()) return;
  if (state != State::Manual) {  // overspeed or another command left Manual mode
    magTest.abort();
    sayAll("# MAGTEST ABORTED: left Manual mode\n");
    return;
  }
  const MagAid::Mode m = magAid.mode();
  const bool inUse = m == MagAid::Mode::Stopped || m == MagAid::Mode::Spinning;
  switch (magTest.update(dt, ekf.eulerRad().z * kRadToDeg, inUse, magAid.headingResidualDeg())) {
    case MagTest::Event::StepDone:
      reportMagTestStep();
      applyMagTestStep();
      break;
    case MagTest::Event::Complete: {
      reportMagTestStep();
      char msg[160];
      if (magTest.driftMinutes() > 0.0f) {
        snprintf(msg, sizeof(msg), "# MAGTEST DRIFT %.0f min: max|yaw| %.2f deg, trend %+.2f deg/h, aid %.0f%%\n",
                 magTest.driftMinutes(), magTest.driftMaxAbsDeg(), magTest.driftTrendDegPerH(),
                 magTest.driftAidFrac() * 100.0f);
        sayAll(msg);
      }
      snprintf(msg, sizeof(msg), "# MAGTEST COMPLETE: %d/%d steps PASS -> %s\n", magTest.passCount(),
               magTest.doneCount(), magTest.passCount() == magTest.doneCount() ? "PASS" : "FAIL");
      sayAll(msg);
      disarm("MAGTEST_COMPLETE");  // wheels stop; SD logging continues until power off
      break;
    }
    default:
      break;
  }
}

static bool setManualSpeed(int wheel, float rpm, CommandLink& from) {
  if (state != State::Idle && state != State::Manual) {
    from.send("# SPEED REFUSED: not idle/manual\n");
    return false;
  }
  if (state == State::Idle) {
    testWheel = -1;
    for (int i = 0; i < kN; i++) {
      speedLoops[i].reset();
      wheelCmd[i] = manualTarget[i] = 0.0f;
    }
    state = State::Manual;
  }
  constexpr float kRpmToRadS = 6.2831853f / 60.0f;
  float w = rpm * kRpmToRadS;
  if (w > params::kWheelMaxSpeedRadS) w = params::kWheelMaxSpeedRadS;
  if (w < -params::kWheelMaxSpeedRadS) w = -params::kWheelMaxSpeedRadS;
  for (int i = 0; i < kN; i++)
    if (wheel == Command::kAllWheels || wheel == i) manualTarget[i] = w;
  char msg[72];
  snprintf(msg, sizeof(msg), "# MANUAL rpm A=%.0f B=%.0f C=%.0f D=%.0f\n", manualTarget[0] / kRpmToRadS,
           manualTarget[1] / kRpmToRadS, manualTarget[2] / kRpmToRadS, manualTarget[3] / kRpmToRadS);
  sayAll(msg);
  return true;
}

static void handleCommand(const Command& c, CommandLink& from) {
  switch (c.cmd) {
    case Cmd::Kill:
    case Cmd::Disarm:
      disarm(c.cmd == Cmd::Kill ? "KILL" : "DISARM");
      break;
    case Cmd::Arm:
      arm(from);
      break;
    case Cmd::Ping:
      from.send("PONG\n");
      break;
    case Cmd::Status: {
      const Vec3 e = ekf.eulerRad() * kRadToDeg;
      const Vec3 s = ekf.sigmaRad() * kRadToDeg;
      char ws[kN + 1];
      wheelStatus(ws);
      char msg[384];
      snprintf(msg, sizeof(msg),
               "S,%c,%.1f,%.1f,%.1f,sig_yaw=%.2f,%.0f,%.0f,%.0f,%.0f,sd=%s,drop=%lu,demo=%c,"
               "miss=%lu,chipgap=%lu,maxgap=%.0f,lat=%.2f,int=%lu,svc=%lu/%lu,ev=%lu,rst=%lu,en=%lu/%d,intpin=%d,"
               "wheels=%c%c%c%c,mag=%c,mres=%.2f,bz=%.5f,wst=%s,fault=%c,mt=%d,hb=%.0f/%d,mpred=%d,all=%c\n",
               stateChar(), e.x, e.y, e.z, s.z, wheels[0].speed(), wheels[1].speed(), wheels[2].speed(),
               wheels[3].speed(), logger.sdActive() ? logger.fileName() : "off",
               (unsigned long)logger.droppedRows(), slew.active() ? slew.phaseChar() : demo.phaseChar(), (unsigned long)seqMissed,
               (unsigned long)chipGaps, maxGyroGapMs, imu.maxLatencyUs() * 1.0e-3f,
               (unsigned long)imu.intCount(), (unsigned long)imu.serviceCount(),
               (unsigned long)imu.freshCount(),
               (unsigned long)imu.eventCount(), (unsigned long)imu.resetCount(),
               (unsigned long)imu.enableCount(), imu.lastEnableOk() ? 1 : 0,
               kPinImuInt >= 0 ? digitalRead(kPinImuInt) : -1, wheelEnabled[0] ? 'A' : '-',
               wheelEnabled[1] ? 'B' : '-', wheelEnabled[2] ? 'C' : '-', wheelEnabled[3] ? 'D' : '-', magAid.modeChar(),
               magAid.headingResidualDeg(), ekf.gyroBias().z * kRadToDeg, ws, fault.phaseChar(), magTest.index() + 1,
               tune::holdMinRadS * 60.0f / 6.2831853f, holdBias.switches(), magAid.predictedCount(),
               fullDemo.phaseChar());
      from.send(msg);
      break;
    }
    case Cmd::DemoSpin:
      startDemo(from, false);
      break;
    case Cmd::DemoLevel:
      startDemo(from, true);
      break;
    case Cmd::DemoAll:
      startFullDemo(c, from);
      break;
    case Cmd::SlewTest:
      startSlew(from, SlewTest::Mode::Absolute);
      break;
    case Cmd::SlewYaw:
      startSlew(from, SlewTest::Mode::YawOnly);
      break;
    case Cmd::SlewTilt:
      startSlew(from, SlewTest::Mode::Tilt);
      break;
    case Cmd::SlewList:
      for (int i = 0; i < params::kSlewNumTargets; i++) sayTarget("SLEW target", i);
      for (int i = 0; i < params::kSlewNumTargets; i++) sayTiltTarget("SLEW TILT target", i);
      break;
    case Cmd::SlewTSet:
      if (state != State::Idle) {
        from.send("# SLEW TSET REFUSED: not idle\n");
      } else if (!slew.setTiltTarget(c.wheel, c.v[0], c.v[1], c.v[2])) {
        from.send("# SLEW TSET REFUSED: target 1-4, offsets <= 8 deg\n");
      } else {
        sayTiltTarget("SLEW TILT target set", c.wheel);
      }
      break;
    case Cmd::SlewSet:
      if (state != State::Idle) {
        from.send("# SLEW SET REFUSED: not idle\n");
      } else if (!slew.setTarget(c.wheel, c.v[0], c.v[1], c.v[2])) {
        from.send("# SLEW SET REFUSED: target 1-4, tilt <= 25 deg\n");
      } else {
        sayTarget("SLEW target set", c.wheel);
      }
      break;
    case Cmd::Calibrate:
      startCalibration(c, from);
      break;
    case Cmd::FaultTest:
      startFaultTest(c, from);
      break;
    case Cmd::FaultClear:
      clearFaults(from);
      break;
    case Cmd::Stop:
      if (slew.active()) {
        if (slew.done()) {
          char msg[64];
          snprintf(msg, sizeof(msg), "# SLEW TEST STOPPED: %d/%d PASS\n", slew.passCount(), params::kSlewNumTargets);
          sayAll(msg);
        }
        disarm(slew.done() ? "SLEW_TEST_DONE" : "SLEW_STOPPED");
      } else if (magStep >= 0) {
        disarm("MAGMAP_STOPPED");
      } else if (magTest.active()) {
        disarm("MAGTEST_STOPPED");
      } else {
        stopDemo(from);
      }
      break;
    case Cmd::MagMap:
      startMagMap(from);
      break;
    case Cmd::MagTest:
      startMagTest(c, from);
      break;
    case Cmd::StepTest:
      startStepTest(c, from);
      break;
    case Cmd::LevelZero:
      startLevelZero(from);
      break;
    case Cmd::Wheel: {
      // WHEEL <A-D> ON|OFF: take a wheel out of (or back into) service. Idle only.
      if (state != State::Idle) {
        from.send("# WHEEL REFUSED: not idle\n");
        break;
      }
      wheelEnabled[c.wheel] = c.value != 0.0f;
      wheelDead[c.wheel] = false;
      deadDet[c.wheel].reset();
      encFaultS[c.wheel] = 0.0f;
      prevSpeed[c.wheel] = wheels[c.wheel].speed();
      char msg[48];
      snprintf(msg, sizeof(msg), "# WHEEL %c %s\n", 'A' + c.wheel, wheelEnabled[c.wheel] ? "ON" : "OFF");
      sayAll(msg);
      break;
    }
    case Cmd::MagAidOn:
    case Cmd::MagAidOff:
      magAid.setEnabled(c.cmd == Cmd::MagAidOn);
      sayAll(magAid.enabled() ? "# MAG AID ON (relearns its references)\n" : "# MAG AID OFF (gyro-only yaw)\n");
      break;
    case Cmd::Set:
    case Cmd::Get: {
      char msg[96];
      if (c.cmd == Cmd::Set && !tune::set(c.name, c.value)) {
        snprintf(msg, sizeof(msg), "# SET REFUSED: unknown parameter %s (GET lists them)\n", c.name);
        from.send(msg);
        break;
      }
      if (c.name[0]) {
        const tune::Param* p = tune::find(c.name);
        if (!p) {
          snprintf(msg, sizeof(msg), "# GET: unknown parameter %s\n", c.name);
        } else {
          snprintf(msg, sizeof(msg), "# %s %s = %.6g (%s, range %.4g..%.4g)\n", c.cmd == Cmd::Set ? "SET" : "GET",
                   p->name, *p->value, p->what, p->lo, p->hi);
        }
        sayAll(msg);
        break;
      }
      // GET with no name: all of them, packed (the XBee's TX buffer is ~1 KB, shared with data rows)
      int len = snprintf(msg, sizeof(msg), "# GET");
      for (int i = 0; i < tune::count(); i++) {
        const tune::Param& p = tune::at(i);
        char item[32];
        const int n = snprintf(item, sizeof(item), " %s=%.5g", p.name, *p.value);
        if (len + n + 2 > (int)sizeof(msg)) {
          strcpy(msg + len, "\n");
          from.send(msg);
          len = snprintf(msg, sizeof(msg), "# GET");
        }
        strcpy(msg + len, item);
        len += n;
      }
      strcpy(msg + len, "\n");
      from.send(msg);
      break;
    }
    case Cmd::Bias: {
      tune::set("HOLD_MIN", c.value > 0.0f ? c.value * 6.2831853f / 60.0f : 0.0f);
      char msg[96];
      snprintf(msg, sizeof(msg), "# BIAS heading holds keep wheels >= %.0f rpm from zero%s\n",
               tune::holdMinRadS * 60.0f / 6.2831853f, tune::holdMinRadS > 0.0f ? "" : " (off)");
      sayAll(msg);
      break;
    }
    case Cmd::Kick: {
      // KICK <deg>: test only - rotate the yaw estimate (not the table) to watch the aid pull it back.
      ekf.perturbYaw(c.value * kDegToRad);
      char msg[48];
      snprintf(msg, sizeof(msg), "# KICK yaw estimate %+.1f deg\n", c.value);
      sayAll(msg);
      break;
    }
    case Cmd::RawOn:
    case Cmd::RawOff:
      usbRaw = c.cmd == Cmd::RawOn;
      from.send(usbRaw ? "# RAW ON\n" : "# RAW OFF\n");
      break;
    case Cmd::BeginStatic: {
      // "BEGIN STATIC TEST [rpm]": SD log + all four wheels held at a constant speed (default
      // kStaticTestWheelRpm; 0 = motors off) to measure magnetometer/IMU behaviour with the
      // motors running. DISARM/KILL stops the wheels; logging continues until power off.
      if (state == State::Calibrating) {
        from.send("# BEGIN REFUSED: still calibrating - keep the table still and retry\n");
        break;
      }
      const float rpm = c.hasValue ? c.value : params::kStaticTestWheelRpm;
      if (rpm != 0.0f && state != State::Idle && state != State::Manual) {
        from.send("# BEGIN REFUSED: not idle (DISARM first)\n");
        break;
      }
      char msg[112];
      if (logger.sdActive()) {
        snprintf(msg, sizeof(msg), "# STATIC TEST already running: %s\n", logger.fileName());
        from.send(msg);
        break;
      }
      if (!logger.startFile("STATIC")) break;  // startFile reports the reason itself
      snprintf(msg, sizeof(msg), "# STATIC TEST STARTED: logging 100 Hz to %s until power off, wheels %.0f rpm\n",
               logger.fileName(), rpm);
      sayAll(msg);
      if (rpm != 0.0f) setManualSpeed(Command::kAllWheels, rpm, from);
      break;
    }
    case Cmd::Test: {
      if (state != State::Idle) {
        from.send("# TEST REFUSED: not idle\n");
        break;
      }
      float d = c.value;
      if (d > params::kTestMaxDuty) d = params::kTestMaxDuty;
      if (d < -params::kTestMaxDuty) d = -params::kTestMaxDuty;
      testWheel = c.wheel;
      testDuty = d;
      testEndMs = millis() + params::kTestDurationMs;
      break;
    }
    case Cmd::Speed:
      setManualSpeed(c.wheel, c.value, from);
      break;
    case Cmd::Counts: {
      long n[kN];
      for (int i = 0; i < kN; i++) n[i] = wheels[i].count();
      const float k = 1.0f / params::kEncoderCountsPerRev;
      char msg[128];
      snprintf(msg, sizeof(msg), "COUNTS A=%ld B=%ld C=%ld D=%ld turns A=%.3f B=%.3f C=%.3f D=%.3f\n", n[0],
               n[1], n[2], n[3], n[0] * k, n[1] * k, n[2] * k, n[3] * k);
      from.send(msg);
      break;
    }
    case Cmd::Zero:
      for (int i = 0; i < kN; i++) wheels[i].zeroCount();
      from.send("# ZERO counts\n");
      break;
    default:
      from.send("# ?\n");
      break;
  }
}

static void pollCommands() {
  Command c;
  while (xbee.poll(c)) handleCommand(c, xbee);
  while (usb.poll(c)) handleCommand(c, usb);
}

// Returns a reason string if the Armed state must be abandoned, else nullptr.
static const char* safetyViolation() {
  const Vec3 e = ekf.eulerRad();
  // SLEW TEST keeps the table under 25 deg (the bubble has no top).
  const float lim = (slew.active() ? params::kSlewMaxTiltDeg : params::kMaxTiltDeg) * kDegToRad;
  if (fabsf(e.x) > lim || fabsf(e.y) > lim) return "TILT";
  if (norm(ekf.bodyRate()) > params::kMaxRateRadS) return "RATE";
  for (int i = 0; i < kN; i++)
    if (wheelEnabled[i] && fabsf(wheels[i].speed()) > params::kWheelOverspeedRadS) return "WHEEL_OVERSPEED";
  return nullptr;
}

// Attitude loop: runs on every gyro sample while armed.
static void controlStep(float dt) {
  const char* bad = safetyViolation();
  if (bad) {
    disarm(bad);
    return;
  }

  if (slew.active() && !stepSlew(dt, wheelMomentum(ekf.bodyRate()))) return;

  if (demo.active()) {
    const Vec3 e = ekf.eulerRad();
    if (stepTest.active()) demo.setHeadingOffset(stepTest.offsetRad());
    switch (demo.step(dt, e.x, e.y)) {
      case DemoSpin::Event::Leveled: {
        char msg[112];
        if (demo.levelOnly()) {
          snprintf(msg, sizeof(msg), "# DEMO LEVEL: settled after %.1f s at rest tilt roll %.2f pitch %.2f deg\n",
                   demo.elapsed(), demo.restRoll() * kRadToDeg, demo.restPitch() * kRadToDeg);
          if (fullDemo.phase() == FullDemo::Phase::Hold) {
            sayAll(msg);
            snprintf(msg, sizeof(msg), "# DEMO ALL 1/3: holding the heading %.0f s (read the laser now)\n",
                     fullDemo.holdS());
          }
        } else {
          snprintf(msg, sizeof(msg), "# DEMO LEVEL: spinning up to %.1f rpm\n",
                   demo.targetRate() * 60.0f / 6.2831853f);
        }
        sayAll(msg);
        break;
      }
      case DemoSpin::Event::LevelTimeout:
        disarm("DEMO_LEVEL_TIMEOUT");
        return;
      case DemoSpin::Event::HoldStarted:
        sayAll("# DEMO HOLD\n");
        break;
      case DemoSpin::Event::SpinDownStarted:
        sayAll("# DEMO SPIN DOWN\n");
        break;
      case DemoSpin::Event::Settling:
        sayAll("# DEMO SETTLE\n");
        break;
      case DemoSpin::Event::Complete:
        disarm("DEMO_COMPLETE");
        return;
      default:
        break;
    }
    if (stepTest.active() && demo.phase() == DemoPhase::LevelHold && !stepStepTest(dt, e.z)) return;
    bool toSlew = false;
    if (fullDemo.phase() == FullDemo::Phase::Hold && demo.phase() == DemoPhase::LevelHold) {
      float err = e.z - demo.startYaw();
      while (err > 3.14159265f) err -= 6.2831853f;
      while (err < -3.14159265f) err += 6.2831853f;
      toSlew = fullDemo.holdStep(dt, err * kRadToDeg);
    }
    // Momentum budget guard: a wheel near its cap means the inertia model is off (or drag).
    float wmax = 0.0f;
    for (int i = 0; i < kN; i++) wmax = fmaxf(wmax, fabsf(wheels[i].speed()));
    if (wmax > params::kDemoWheelAbortRadS) {
      if (demo.phase() == DemoPhase::Level || demo.phase() == DemoPhase::LevelHold) {
        if (demo.levelOnly()) reportLevelHold("DEMO LEVEL WHEEL LIMIT");
        disarm("DEMO_WHEEL_LIMIT");
        return;
      }
      if (demo.requestStop() == DemoSpin::Event::SpinDownStarted)
        sayAll("# DEMO ABORT: wheel near limit, spinning down\n");
    }
    ctrl.setTrajectory(demo.ref().q, demo.ref().w, demo.ref().a);
    if (toSlew) beginFullSlew();  // DEMO ALL: the hold hands over to SLEW YAW on the next step
  }

  const Vec3 omega = ekf.bodyRate();
  ctrl.setFeedforward(slew.active() && slew.tilt() ? slew.gravityFF() : Vec3{0.0f, 0.0f, 0.0f});
  const Vec3 tau = ctrl.update(ekf.quaternion(), omega, dt, wheelMomentum(omega));
  if (fault.active())
    reportFault(fault.step(dt, ctrl.angleError() * kRadToDeg, fault.wheel() >= 0 ? wheels[fault.wheel()].speed() : 0.0f));

  float u[kN];
  if (!allocate(tau, wheelEnabled, u)) {
    disarm("ALLOC");
    return;
  }
  bool all = true;
  float spd[kN];
  for (int i = 0; i < kN; i++) {
    all = all && wheelEnabled[i];
    spd[i] = wheels[i].speed();
  }
  // Null mode: hold the [+1,-1,+1,-1] wheel-speed combination at the bias (no body torque).
  // DEMO SPIN keeps the wheels at ~100 rpm so no shaft sits still (magnetometer, mag_map.h).
  float nullBias = demo.active() ? demo.wheelBias() : params::kNullBiasRadS;
  // Heading holds (ARM, DEMO LEVEL): keep every wheel away from zero for the magnetometer aid.
  // That also keeps them turning for FAULT TEST, so it replaces the test's fixed bias.
  // SLEW YAW holds roll/pitch at the rest tilt like DEMO LEVEL, so it gets the same bias.
  const bool hold = all && tune::holdMinRadS > 0.0f && (!slew.active() || slew.yawOnly()) &&
                    (!demo.active() || demo.levelOnly());
  if (hold) {
    nullBias = holdBias.update(spd, tune::holdMinRadS, tune::holdMaxPeak, dt);
  } else if (fault.wheelBias() > nullBias) {
    // FAULT TEST keeps the wheels turning so a dead motor shows up at once (wheel_fault.h).
    nullBias = fault.wheelBias();
  }
  if (all) addNullSpaceTorque(spd, params::kWheelInertia, tune::nullGain, nullBias, u);

  for (int i = 0; i < kN; i++) {
    if (!wheelEnabled[i]) continue;
    float cmd = wheelCmd[i] + (u[i] / params::kWheelInertia) * dt;
    // Keep the setpoint within what the motor can follow (limits wind-up).
    const float lead = params::kWheelCmdLeadRadS;
    if (cmd > spd[i] + lead) cmd = spd[i] + lead;
    if (cmd < spd[i] - lead) cmd = spd[i] - lead;
    if (cmd > params::kWheelMaxSpeedRadS) cmd = params::kWheelMaxSpeedRadS;
    if (cmd < -params::kWheelMaxSpeedRadS) cmd = -params::kWheelMaxSpeedRadS;
    wheelCmd[i] = cmd;
  }
}

// Inner loop at kSpeedLoopHz: encoder speeds, speed PI, motor outputs, bench test.
static void wheelLoop(float dt) {
  // Manual-mode low-pass runs in every state so it is already settled when SPEED starts.
  const float lpfA = dt / (params::kManualSpeedLpfTauS + dt);
  for (int i = 0; i < kN; i++) {
    wheels[i].updateSpeed(dt);
    manualSpeed[i] += lpfA * (wheels[i].speed() - manualSpeed[i]);
  }
  // loop() was blocked (e.g. the SD card): the speed is now an average over the whole gap and the
  // duty was frozen through it, so the fault checks can't judge this step, and the speed loop and
  // slew limit use a normal step (else one step integrates the whole gap).
  const bool stalled = dt > params::kWheelLoopStallS;
  if (stalled) {
    char msg[96];
    snprintf(msg, sizeof(msg), "# WHEEL LOOP STALLED %.0f ms: fault checks skipped for this step\n", dt * 1e3f);
    sayAll(msg);
    dt = 1.0f / params::kSpeedLoopHz;
  }
  for (int i = 0; i < kN; i++) {
    const float w = wheels[i].speed();
    const bool jump = !stalled && dt > 0.0f && fabsf(w - prevSpeed[i]) > params::kEncFaultMaxAccelRadS2 * dt;
    prevSpeed[i] = w;
    if (stalled) deadDet[i].reset();
    const bool stuck = fabsf(wheels[i].axisDuty()) > params::kEncFaultDuty && fabsf(w) < params::kEncFaultSpeedRadS;
    encFaultS[i] = stuck && !stalled ? encFaultS[i] + dt : 0.0f;
    if (wheelEnabled[i] && (jump || encFaultS[i] > params::kEncFaultTimeS)) {
      wheelEnabled[i] = false;
      wheels[i].stop();
      char msg[96];
      snprintf(msg, sizeof(msg), "# WHEEL FAULT %c: %s - wheel disabled (WHEEL %c ON to re-enable)\n", 'A' + i,
               jump ? "speed jump (encoder glitch)" : "driven but encoder shows no motion", 'A' + i);
      sayAll(msg);
      onWheelFailed(i);
    }
    // Dead motor: driven hard (Armed) but the wheel doesn't accelerate. Uses the duty applied over
    // the last interval, which is what moved the wheel to its new speed.
    if (state != State::Armed || !wheelEnabled[i]) {
      deadDet[i].reset();
    } else if (deadDet[i].update(wheels[i].axisDuty() - w / params::kWheelFreeSpeedRadS, w, dt)) {
      wheelEnabled[i] = false;
      wheelDead[i] = true;
      wheels[i].coast();
      char msg[128];
      snprintf(msg, sizeof(msg),
               "# WHEEL FAULT %c: dead motor (driven, not accelerating) - disabled, coasting; control on the rest\n",
               'A' + i);
      sayAll(msg);
      onWheelFailed(i);
    }
  }

  const bool testing = testWheel >= 0 && (int32_t)(millis() - testEndMs) < 0;
  if (testWheel >= 0 && !testing) {
    char msg[64];
    snprintf(msg, sizeof(msg), "# TEST %c duty=%.2f speed=%.1f rad/s\n", 'A' + testWheel, testDuty,
             wheels[testWheel].speed());
    sayAll(msg);
    testWheel = -1;
  }

  if (state == State::Manual) {
    for (int i = 0; i < kN; i++) {
      if (wheelEnabled[i] && fabsf(wheels[i].speed()) > params::kWheelOverspeedRadS) {
        disarm("WHEEL_OVERSPEED");
        return;
      }
    }
  }

  for (int i = 0; i < kN; i++) {
    if (!wheelEnabled[i]) {
      // Disabled: never driven, in any mode. A dead motor coasts (zero current); others brake.
      if (wheelDead[i]) {
        wheels[i].coast();
      } else {
        wheels[i].stop();
      }
    } else if (state == State::Manual) {
      // Ramp the setpoint toward the SPEED target (limits overshoot and current surges).
      // The integrator is held while ramping so it doesn't wind up and overshoot at the end.
      const float step = params::kManualAccelRadS2 * dt;
      const float diff = manualTarget[i] - wheelCmd[i];
      const bool ramping = fabsf(diff) > step;
      wheelCmd[i] += ramping ? (diff > 0.0f ? step : -step) : diff;
      if (manualTarget[i] == 0.0f && wheelCmd[i] == 0.0f && fabsf(manualSpeed[i]) < params::kManualReleaseRadS) {
        // Stopped at a 0 target: release the drive. The integrator otherwise held ~-0.06 duty in a
        // stopped motor (2026-10-27), and that current moved the magnetometer by microtesla.
        speedLoops[i].reset();
        wheels[i].stop();
        continue;
      }
      wheels[i].setDuty(speedLoops[i].update(wheelCmd[i], manualSpeed[i], dt,
                                             params::kManualFreeSpeedRadS, !ramping),
                        dt);
    } else if (state == State::Armed && wheelEnabled[i]) {
      wheels[i].setDuty(speedLoops[i].update(wheelCmd[i], wheels[i].speed(), dt), dt);
    } else if (testing && i == testWheel) {
      wheels[i].setDuty(testDuty, dt);
    } else {
      wheels[i].stop();
    }
  }
}

static void handleCalibrationSample(const ImuSample& s) {
  if (s.kind == ImuSample::Gyro) {
    calGyroN++;
    gSum[0] += s.v.x;  gSumSq[0] += (double)s.v.x * s.v.x;
    gSum[1] += s.v.y;  gSumSq[1] += (double)s.v.y * s.v.y;
    gSum[2] += s.v.z;  gSumSq[2] += (double)s.v.z * s.v.z;
  } else if (s.kind == ImuSample::Accel) {
    calAccelN++;
    aSum[0] += s.v.x;
    aSum[1] += s.v.y;
    aSum[2] += s.v.z;
  }

  const uint32_t elapsed = millis() - calStartMs;
  if (elapsed < calDurationMs) {
    if (millis() - calProgressMs >= params::kCalProgressMs) {
      calProgressMs = millis();
      char msg[56];
      snprintf(msg, sizeof(msg), "# calibrating: %lu / %lu s, keep still\n", (unsigned long)(elapsed / 1000),
               (unsigned long)(calDurationMs / 1000));
      sayAll(msg);
    }
    return;
  }

  if (calGyroN < kMinCalSamples || calAccelN < kMinCalSamples / 2) {
    sayAll("# calibration: too few IMU samples, retrying\n");
    resetCalibration();
    return;
  }

  Vec3 mean, stdv;
  float* m[3] = {&mean.x, &mean.y, &mean.z};
  float* sd[3] = {&stdv.x, &stdv.y, &stdv.z};
  for (int i = 0; i < 3; i++) {
    const double mu = gSum[i] / calGyroN;
    const double var = gSumSq[i] / calGyroN - mu * mu;
    *m[i] = (float)mu;
    *sd[i] = sqrtf(var > 0.0 ? (float)var : 0.0f);
  }

  const bool still = stdv.x < kCalMaxGyroStd && stdv.y < kCalMaxGyroStd &&
                     stdv.z < kCalMaxGyroStd && norm(mean) < kCalMaxGyroMean;
  if (!still) {
    sayAll("# calibration: table is moving, HOLD STILL - restarting\n");
    resetCalibration();
    return;
  }

  const Vec3 accelMean = {(float)(aSum[0] / calAccelN), (float)(aSum[1] / calAccelN),
                          (float)(aSum[2] / calAccelN)};
  float worst = stdv.x;
  if (stdv.y > worst) worst = stdv.y;
  if (stdv.z > worst) worst = stdv.z;
  const float biasSigma = worst / sqrtf((float)calGyroN);  // std error of the mean

  if (!ekf.initialize(accelMean, mean, biasSigma)) {
    sayAll("# calibration: bad gravity vector, retrying\n");
    resetCalibration();
    return;
  }

  char msg[96];
  snprintf(msg, sizeof(msg), "# calibrated: bias[deg/s]=%.4f,%.4f,%.4f (N=%lu, %lu s)\n", mean.x * kRadToDeg,
           mean.y * kRadToDeg, mean.z * kRadToDeg, (unsigned long)calGyroN,
           (unsigned long)(calDurationMs / 1000));
  sayAll(msg);
  Serial.println(
      "# t_ms,qw,qx,qy,qz,roll,pitch,yaw,bx,by,bz,sig_roll,sig_pitch,sig_yaw,accel_status,w0,w1,w2,w3,state,"
      "dutyA,dutyB,dutyC,dutyD,mag_mode,mag_resid_deg");
  haveLastGyro = false;
  magAid.reset();  // the stopped reference is learned now, at yaw 0
  state = State::Idle;
  sayAll("# READY (idle). Send ARM to hold level.\n");
}

void setup() {
  Serial.begin(115200);
  XBEE_SERIAL.begin(params::kXbeeBaud);
  XBEE_SERIAL.addMemoryForWrite(xbeeTxExtra, sizeof(xbeeTxExtra));
  const uint32_t t0 = millis();
  while (!Serial && millis() - t0 < 3000) {
  }

  analogWriteResolution(params::kPwmBits);
  for (int i = 0; i < kN; i++) wheels[i].begin();

  logger.begin();

  IMU_I2C_BUS.begin();
  IMU_I2C_BUS.setClock(400000);
  // Keep retrying (each attempt hardware-resets the chip) and keep saying why, so the message
  // is seen even if the USB/XBee monitor was opened late. Halts in setup only.
  while (!imu.begin(IMU_I2C_BUS, kImuI2cAddr)) {
    stopAllWheels();
    char msg[112];
    // Wiring diagnostics: idle level of RST and INT with neither driven (RST has a pull-up on
    // the breakout, INT is driven by the chip), and every address that ACKs on the bus.
    if (kPinImuReset >= 0) pinMode(kPinImuReset, INPUT);
    if (kPinImuInt >= 0) pinMode(kPinImuInt, INPUT);
    delay(5);
    char found[48] = "";
    for (uint8_t a = 0x08; a < 0x78; a++) {
      IMU_I2C_BUS.beginTransmission(a);
      if (IMU_I2C_BUS.endTransmission() == 0 && strlen(found) < sizeof(found) - 6) {
        char h[6];
        snprintf(h, sizeof(h), "0x%02X ", a);
        strcat(found, h);
      }
    }
    snprintf(msg, sizeof(msg), "# ERROR: BNO085 not responding. RST(%d)=%d INT(%d)=%d i2c: %s\n",
             kPinImuReset, kPinImuReset >= 0 ? digitalRead(kPinImuReset) : -1, kPinImuInt,
             kPinImuInt >= 0 ? digitalRead(kPinImuInt) : -1, found[0] ? found : "none");
    sayAll(msg);
    delay(1000);
  }
  {
    char msg[72];
    snprintf(msg, sizeof(msg), "# BNO085 ready. HOLD THE TABLE STILL for %lu s calibration.\n",
             (unsigned long)(calDurationMs / 1000));
    sayAll(msg);
  }
  resetCalibration();
  lastGyroMs = millis();
  lastWheelUs = micros();
}

// Replaces the Teensy core's weak yield(). SdFat calls yield() while it waits on the SD card
// (and delay() calls it too), so reading the IMU here keeps it serviced through SD write stalls;
// the samples are queued and processed by loop() with their own timestamps. The core's default
// yield() only dispatches serialEvent*() (not used here) and EventResponder, kept below.
void yield() {
  imu.background();
  if (yield_active_check_flags & YIELD_CHECK_EVENT_RESPONDER) EventResponder::runFromYield();
}

void loop() {
  pollCommands();  // KILL is handled here, before any IMU work

  // Drain everything the IMU has queued, in arrival order.
  ImuSample s;
  updateMount();
  while (imu.poll(s)) {
    if (levelZeroActive && s.kind == ImuSample::Accel) {  // raw IMU frame, before the mounting rotation
      levelZeroSum[0] += s.v.x;
      levelZeroSum[1] += s.v.y;
      levelZeroSum[2] += s.v.z;
      levelZeroN++;
    }
    s.v = toTable(s.v);
    if (s.kind == ImuSample::Gyro) s.v.z *= tune::gyroScaleZ;  // yaw scale factor (kGyroScaleZ)
    if (s.kind == ImuSample::Gyro) {
      latestGyro = s.v;
      trackGyroSequence(s);
    } else if (s.kind == ImuSample::Accel) latestAccel = s.v;
    else if (s.kind == ImuSample::Mag) {
      latestMag = s.v;
      const float dtMag = haveLastMag ? (uint32_t)(s.t_us - lastMagUs) * 1.0e-6f : 0.0f;
      lastMagUs = s.t_us;
      haveLastMag = true;
      if (state != State::Calibrating && ekf.initialized() && dtMag > 0.0f && dtMag < 0.1f) {
        long cnt[kN];
        float spd[kN];
        for (int i = 0; i < kN; i++) {
          cnt[i] = wheels[i].count();
          spd[i] = wheels[i].speed();
        }
        Vec3 mUse, ref;
        lastMagResult = MagResult::Gated;
        // A dead-motor wheel still moves (coasting) and its encoder works: keep it in the mag aid's
        // wheel-state check so its new stopping place can't leave a stale field offset.
        bool magWheels[kN];
        for (int i = 0; i < kN; i++) magWheels[i] = wheelEnabled[i] || wheelDead[i];
        magAid.setHardIron({tune::magHard[0], tune::magHard[1], tune::magHard[2]});  // no-op unless SET changed it
        magAid.setRoomCorrection(tune::magRoom);
        if (magAid.update(s.v, cnt, spd, magWheels, ekf.quaternion(), dtMag, mUse, ref))
          lastMagResult = ekf.updateMagYaw(mUse, ref, tune::magSigma);
      }
      if (usbRaw) printRawRow(s.t_us);
    }

    if (state == State::Calibrating) {
      handleCalibrationSample(s);
      if (s.kind == ImuSample::Gyro) {
        lastGyroMs = millis();
        logData(s.t_us);
      }
      continue;
    }

    if (s.kind == ImuSample::Gyro) {
      lastGyroMs = millis();
      if (haveLastGyro) {
        const float dt = (uint32_t)(s.t_us - lastGyroUs) * 1.0e-6f;
        // Integrate gaps up to the IMU timeout with the new sample's rate (the BNO085 stalls for
        // 60-90 ms every ~22 s, and SD-logging stalls lose up to ~140 ms; skipping those would lose
        // the rotation during them). Longer gaps are dropped (and disarm when Armed).
        if (dt > 0.0f && dt <= params::kImuTimeoutMs * 1.0e-3f) {
          ekf.predict(s.v, dt);
          if (state == State::Armed) controlStep(dt);
          stepMagTest(dt);
        }
      }
      lastGyroUs = s.t_us;
      haveLastGyro = true;
      logData(s.t_us);
    } else if (s.kind == ImuSample::Accel) {
      lastAccelResult = ekf.updateAccel(s.v);
    }
  }

  if (state == State::Armed && millis() - lastGyroMs > params::kImuTimeoutMs) disarm("IMU_TIMEOUT");

  const uint32_t nowUs = micros();
  const uint32_t periodUs = (uint32_t)(1.0e6f / params::kSpeedLoopHz);
  if ((uint32_t)(nowUs - lastWheelUs) >= periodUs) {
    wheelLoop((uint32_t)(nowUs - lastWheelUs) * 1.0e-6f);
    lastWheelUs = nowUs;
  }

  updateMagMap();
  updateLevelZero(xbee);
  logger.service();  // rows are produced per gyro sample above

  if (!usbRaw && state != State::Calibrating && millis() - lastUsbMs >= params::kUsbTelemetryMs) {
    lastUsbMs = millis();
    printUsbTelemetry();
  }
}
