derek-weissinger-usafa/Astro-331-Lab-8/Astro 331 Lab 8/include/wheel_speed_ctrl.h

#pragma once
#include "control_params.h"
#include "tune.h"

// Inner wheel speed loop: feedforward + PI on encoder speed, output is motor duty
// in [-maxDuty, +maxDuty]. No current sensing is available, so this is the
// only per-wheel loop. Anti-windup by clamping the integrator. Gains: tune.h (SET SPD_KP / SPD_KI).
class WheelSpeedLoop {
 public:
  void reset() { integral_ = 0.0f; }

  // cmd, meas in rad/s. Returns duty (before the motor's slew limit).
  // freeSpeed: wheel speed per unit duty, for the feedforward term.
  // integrate = false holds the integrator (e.g. while a setpoint ramp is in progress).
  float update(float cmd, float meas, float dt, float freeSpeed = params::kWheelFreeSpeedRadS,
               bool integrate = true) {
    const float err = cmd - meas;
    if (integrate) integral_ += tune::speedKi * err * dt;
    if (integral_ > params::kSpeedIntegralClamp) integral_ = params::kSpeedIntegralClamp;
    if (integral_ < -params::kSpeedIntegralClamp) integral_ = -params::kSpeedIntegralClamp;

    float duty = cmd / freeSpeed + tune::speedKp * err + integral_;
    if (duty > params::kMaxDuty) duty = params::kMaxDuty;
    if (duty < -params::kMaxDuty) duty = -params::kMaxDuty;
    return duty;
  }

 private:
  float integral_ = 0.0f;
};
