derek-weissinger-usafa/Astro-331-Lab-8/Astro 331 Lab 8/src/data_logger.cpp

#include "data_logger.h"

#include <string.h>

#include "control_params.h"

static const char kHeader[] =
    "mcutime_ms,gyro_x_rad_s,gyro_y_rad_s,gyro_z_rad_s,accel_x_m_s2,accel_y_m_s2,accel_z_m_s2,"
    "mag_x_uT,mag_y_uT,mag_z_uT,motor_a_measured_rate_rpm,motor_b_measured_rate_rpm,"
    "motor_c_measured_rate_rpm,motor_d_measured_rate_rpm,"
    "motor_a_duty,motor_b_duty,motor_c_duty,motor_d_duty,"
    "qw,qx,qy,qz,roll_deg,pitch_deg,yaw_deg,bias_x_rad_s,bias_y_rad_s,bias_z_rad_s,"
    "sig_roll_deg,sig_pitch_deg,sig_yaw_deg,accel_status,state,demo_phase,rate_ref_rad_s,yaw_ref_deg,"
    "gyro_seq,gyro_seq_missed,test_step,mag_mode,mag_resid_deg,wheel_status,err_roll_deg,err_pitch_deg,"
    "err_yaw_deg,fault_phase,enc_a,enc_b,enc_c,enc_d\n";

// Built-in SD card in DMA mode. The SD library's own begin picks FIFO mode, whose write path
// spins (without yield()) while the card programs flash mid-write; that froze loop() for up to
// ~43 ms (2026-10-20 static test). In DMA mode every long card wait calls yield(), which keeps
// the IMU serviced. Throughput is lower but far above the ~26 KB/s this log needs.
static bool beginCard() { return SD.sdfs.begin(SdioConfig(DMA_SDIO)); }

void DataLogger::say(const char* msg) {
  const size_t n = strlen(msg);
  if ((size_t)radio_.availableForWrite() >= n) radio_.write((const uint8_t*)msg, n);
  Serial.print(msg);
}

bool DataLogger::begin() {
  sd_ = false;
  card_ = beginCard();
  say(card_ ? "# SD: card ready. Send BEGIN STATIC TEST to start logging.\n"
            : "# SD: not available (no card?)\n");

  const size_t h = sizeof(kHeader) - 1;
  if ((size_t)radio_.availableForWrite() >= h) radio_.write((const uint8_t*)kHeader, h);
  return card_;
}

bool DataLogger::startFile(const char* prefix) {
  if (sd_) return true;
  if (!card_) card_ = beginCard();  // card may have been inserted after boot
  if (!card_) {
    say("# SD: not available (no card?)\n");
    return false;
  }

  name_[0] = '\0';
  for (int i = 1; i <= 9999; i++) {
    snprintf(name_, sizeof(name_), "%s_%04d.CSV", prefix, i);
    if (!SD.exists(name_)) break;
    if (i == 9999) name_[0] = '\0';  // all names used
  }
  if (name_[0] != '\0') file_ = SD.open(name_, FILE_WRITE);
  if (name_[0] == '\0' || !file_) {
    name_[0] = '\0';
    say("# SD: could not create a log file\n");
    return false;
  }

  // Write the header now, padded with a '#' comment line to whole sectors, and flush: the card's
  // first write to a new file searches the FAT for free space, which blocked loop() for up to
  // ~0.5 s. The callers start logging just before arming, so done in service() that stall landed
  // in the first second of every first run after a boot (2026-11-01: the wheel loop then saw one
  // huge step, flagged every wheel dead and left some at full speed). Here the wheels are still
  // stopped. The padding keeps the file position sector-aligned for service().
  const size_t h = sizeof(kHeader) - 1;
  const size_t padded = (h + 2 + kSector - 1) / kSector * kSector;
  memcpy(buf_, kHeader, h);
  buf_[h] = '#';
  memset(buf_ + h + 1, ' ', padded - h - 2);
  buf_[padded - 1] = '\n';
  len_ = padded;
  dropped_ = 0;
  sd_ = true;
  if (!writeOut(padded)) {
    failSd();
    return false;
  }
  file_.flush();
  lastFlushMs_ = millis();
  return true;
}

void DataLogger::logRow(const LogRow& r) {
  char line[384];
  const int n = snprintf(
      line, sizeof(line),
      "%.3f,%.5f,%.5f,%.5f,%.3f,%.3f,%.3f,%.2f,%.2f,%.2f,%.1f,%.1f,%.1f,%.1f,%.3f,%.3f,%.3f,%.3f,"
      "%.6f,%.6f,%.6f,%.6f,%.3f,%.3f,%.3f,%.6f,%.6f,%.6f,%.3f,%.3f,%.3f,%d,%c,%c,%.4f,%.3f,%d,%lu,%d,%c,%.2f,%s,%.3f,%.3f,%.3f,%c,%ld,%ld,%ld,%ld\n",
      r.ms, r.gyro.x, r.gyro.y, r.gyro.z, r.accel.x, r.accel.y, r.accel.z, r.mag.x, r.mag.y,
      r.mag.z, r.rpm[0], r.rpm[1], r.rpm[2], r.rpm[3], r.duty[0], r.duty[1], r.duty[2], r.duty[3],
      r.q.w, r.q.x, r.q.y, r.q.z, r.eulerDeg.x, r.eulerDeg.y, r.eulerDeg.z, r.bias.x, r.bias.y,
      r.bias.z, r.sigmaDeg.x, r.sigmaDeg.y, r.sigmaDeg.z, r.accelStatus, r.state, r.demoPhase,
      r.rateRef, r.yawRefDeg, r.gyroSeq, (unsigned long)r.seqMissed, r.testStep, r.magMode,
      r.magResidDeg, r.wheelStatus, r.errDeg.x, r.errDeg.y, r.errDeg.z, r.faultPhase, r.enc[0], r.enc[1], r.enc[2], r.enc[3]);
  if (n <= 0 || n >= (int)sizeof(line)) return;

  if (sd_) {
    if (len_ + (size_t)n <= kBufBytes) {
      memcpy(buf_ + len_, line, n);
      len_ += n;
    } else {
      dropped_++;
    }
  }

  if (rowCount_ % params::kXbeeLogDecimation == 0 &&
      (size_t)radio_.availableForWrite() >= (size_t)n) {
    radio_.write((const uint8_t*)line, n);
  }
  rowCount_++;
}

bool DataLogger::writeOut(size_t n) {
  if (n == 0) return true;
  if (file_.write((const uint8_t*)buf_, n) != n) return false;
  memmove(buf_, buf_ + n, len_ - n);
  len_ -= n;
  return true;
}

void DataLogger::failSd() {
  sd_ = false;
  len_ = 0;
  file_.close();
  say("# SD: write failed - logging to radio only\n");
}

void DataLogger::service() {
  if (!sd_) return;
  // Don't queue behind a card that is still programming the last write: SdFat would busy-wait
  // (calling yield(), which services the IMU, but loop() and control would still stall).
  if (SD.sdfs.card()->isBusy()) return;

  // Whole sectors only, up to kMaxWrite per call (bounded latency, and the file position stays
  // sector-aligned so SdFat writes straight from the buffer as one multi-sector transfer).
  const size_t whole = (len_ < kMaxWrite ? len_ : kMaxWrite) / kSector * kSector;
  if (whole > 0) {
    if (!writeOut(whole)) failSd();
    return;
  }

  // Nothing whole to write: commit the file size/directory entry once per kSdFlushMs. The
  // remainder (< one sector, under 2 rows) stays in RAM to keep the alignment.
  if (millis() - lastFlushMs_ >= params::kSdFlushMs) {
    lastFlushMs_ = millis();
    file_.flush();
  }
}
