derek-weissinger-usafa/Astro-331-Lab-8/Astro 331 Lab 8/include/mag_test.h

#pragma once
#include <stdint.h>

// "MAG TEST": scripted validation of the magnetometer yaw aid (mag_aid.h) on the FIXED table, run
// over the XBee (TODO.md section 0, Owen's test 5 repeated with all four wheels). The table can't
// turn, so the true yaw is the one CALIBRATE defined (0): any yaw the estimate shows is error.
// Procedure: power on, wait ~10 min (gyro warm-up), CALIBRATE 180, then MAG TEST [drift min].
// The wheels follow the schedule below in Manual mode; KICK steps rotate the yaw ESTIMATE at the
// step start (as the KICK command does) to check that the aid pulls it back.
//
// Per step, graded on the EKF yaw (all samples, transitions included):
//   normal step: max |yaw| <= kMagTestTolDeg
//   KICK step:   |yaw| back within kMagTestTolDeg <= kMagTestRecoverS after the kick and never
//                outside it again for the rest of the step
// Also reported: the share of samples the aid applied an update (mode s/S) and the rms field
// residual while it did. After the drift run: max |yaw| and the yaw trend (least squares, deg/h).
//
// Parts (first visits to a direction pattern learn its reference; later visits reuse it):
//   1 stopped: baseline, then KICK +10
//   2 eleven direction patterns at 200 rpm, then repeats at 100 / 300 rpm and mixed speeds
//     (the speed model within a pattern, and stored references being reused)
//   3 KICK -10 and +10 while spinning, then stopped at the new shaft positions
//   4 drift run: kDrift (2 min steps) cycled for the requested time, ending stopped
// KICK steps last 120 s, so the kicked error has decayed (~0.1 deg) before the next pattern's
// reference is learned (the aid's known limit, mag_aid.h).
namespace mag_test {

struct Step {
  int16_t rpm[4];   // A, B, C, D
  uint16_t s;       // duration
  int8_t kickDeg;   // KICK at the step start (0 = none)
};

constexpr Step kMain[] = {
    // 1: stopped
    {{0, 0, 0, 0}, 60, 0},
    {{0, 0, 0, 0}, 120, 10},
    // 2: direction patterns (signs A B C D), first visits
    {{200, 200, 200, 200}, 60, 0},     // ++++
    {{200, -200, 200, -200}, 60, 0},   // +-+-  (the null-mode pattern)
    {{200, 200, -200, -200}, 60, 0},   // ++--
    {{200, -200, -200, 200}, 60, 0},   // +--+
    {{-200, 200, -200, 200}, 60, 0},   // -+-+
    {{-200, -200, -200, -200}, 60, 0}, // ----
    {{200, 200, 200, -200}, 60, 0},    // +++-
    {{-200, 200, 200, -200}, 60, 0},   // -++-
    {{200, -200, -200, -200}, 60, 0},  // +---
    {{-200, -200, 200, 200}, 60, 0},   // --++
    {{-200, 200, 200, 200}, 60, 0},    // -+++
    //    repeats at other speeds (stored references, speed model)
    {{100, 100, 100, 100}, 60, 0},     // ++++
    {{300, -300, 300, -300}, 60, 0},   // +-+-
    {{100, 100, -100, -100}, 60, 0},   // ++--
    {{-300, -300, -300, -300}, 60, 0}, // ----
    {{250, -100, 150, -300}, 60, 0},   // +-+- mixed speeds
    {{0, 0, 0, 0}, 60, 0},             // stopped somewhere new
    // 3: kicks while spinning, then stop
    {{200, -200, 200, -200}, 120, -10},
    {{200, 200, -200, -200}, 120, 10},
    {{0, 0, 0, 0}, 60, 0},
};
constexpr int kNumMain = sizeof(kMain) / sizeof(kMain[0]);
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
