derek-weissinger-usafa/Astro-331-Lab-8/(commit log)

2026-09-30 Add past documentation and document actual hardware in CLAUDE.md
    [Assembly.f3z, Basement.stl, Basement2.stl, Carrier V6.f3d, Carrier.step, Gearmotor_37D_100.step, Gemini (use in TinkerCad).brd, High Bar.f3d]
2026-10-02 Add Teensy pin out wiring labels
2026-10-02 Document Teensy pin assignments in CLAUDE.md
2026-10-02 Document BNO085 I2C wiring in CLAUDE.md
2026-10-02 Add gyro+accelerometer MEKF attitude determination for BNO085
    Multiplicative EKF (attitude error + gyro bias) with accelerometer-only
    updates; no magnetometer, so yaw is dead-reckoned. Includes BNO085 driver
    wrapper, startup static bias calibration, frame conventions (z up,
    right-handed), placeholder pins, and the BNO085 datasheet.
    [attitude_ekf.cpp, attitude_ekf.h, frames.h, imu_bno085.cpp, imu_bno085.h, main.cpp, pins.h]
2026-10-02 Clarify Teensy power pin labels in CLAUDE.md
2026-10-02 Fill in confirmed Teensy pin assignments and board wiring
2026-10-02 Document encoder supply moved to 3.3 V
2026-10-02 Document XBee 3 model and 3.3 V rail budget
2026-10-06 Document planned power subsystem: four 3S Epoch 18650 packs
2026-10-06 Power plan: separate PKCELL pack with 5 V boost for logic
2026-10-06 Correct Teensy VIN range note in power section
2026-10-06 Add reaction-wheel attitude hold controller and SD/XBee data logger
    Controller: quaternion PD holding level / yaw 0, min-norm allocation over
    the 4-wheel 45 deg pyramid (any 3 enabled wheels still span 3 axes),
    100 Hz encoder speed loops on the TB9051FTG drivers, supervisor with
    auto-disarm (KILL, IMU timeout, tilt, rate, wheel overspeed), and ASCII
    commands over XBee/USB (ARM, DISARM/KILL, STATUS, PING, TEST).
    Data logger: raw gyro/accel/mag (uncalibrated) and wheel rpm at 20 Hz to
    a new LOG_####.CSV on the built-in SD card each boot, every 4th row to
    the XBee at 9600 baud. Collection and control now run at 100 Hz. Adds
    1 KB of Serial8 TX buffer: the default 40 bytes made the non-blocking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
2026-10-06 Power: U3V70F5 boost (verified 5.09 V), low-side motor switch, star ground
2026-10-06 Note PWM-zeroing delay in power-up sequence
2026-10-08 Add power wiring bench sheet
2026-10-08 Add SPEED command for manual closed-loop wheel speed control
    SPEED <A-D|ALL> <rpm> enters a Manual state where each wheel's speed loop
    tracks the commanded rpm (clamped to kWheelMaxSpeedRadS, overspeed disarms).
    DISARM/KILL returns to Idle.
2026-10-08 Fix encoder pins to match table wiring; flip encoder signs
    Encoders are wired yellow -> 6-9 and white -> 2-5 (wheels A-D), not 8-11 / 4-7
    as on teensy_pin_out.pdf; found with hand-spin and TEST checks. +duty spins all
    four wheels CCW (+axis) but the encoders counted negative, so kEncoderSign = -1.
    [control_params.h, pins.h]
2026-10-08 Manual mode: ramp SPEED setpoints and use measured feedforward
    SPEED now sets a target that the setpoint ramps toward at kManualAccelRadS2
    (20 rad/s^2), and Manual mode's speed loop uses kManualFreeSpeedRadS = 88
    (measured: TEST 0.3 -> 24-28 rad/s) for its feedforward. The old 44 rad/s
    value doubled the feedforward and made each new speed overshoot. Armed mode is
    unchanged (still kWheelFreeSpeedRadS = 44, no ramp).
    [control_params.h, main.cpp, wheel_speed_ctrl.h]
2026-10-13 Manual mode: hold speed integrator while ramping, add speed low-pass
    - The speed-loop integrator is held while a SPEED setpoint is ramping, so it
    no longer winds up and overshoots at the end of the ramp (bench run: step
    overshoot/undershoot roughly halved, +1.7 -> +0.9 and -2.3 -> -1.3 rad/s).
    - Measured wheel speed gets an extra first-order low-pass
    (kManualSpeedLpfTauS = 0.1 s) for the Manual speed loop; USB telemetry and
    STATUS show the filtered speed while in Manual. The SD/XBee log and the
    overspeed check still use the unfiltered speed. Filter not yet bench-tested.
    Armed mode is unchanged.
2026-10-15 Fix wheel gear ratio (6.3:1), 12 V motor settings, duty telemetry, COUNTS/ZERO
    Bench session 2026-10-15; see HANDOFF_2026-10-15.md for the full write-up.
    - Motors are Pololu 37D 6.3:1 (gearboxes labeled GB37-6.3), not 10:1:
    hand-turn COUNTS test gave ~400 counts/turn on all four wheels.
    kEncoderCountsPerRev 640 -> 400. Speeds logged before this read 1.6x low.
    - Free speed measured at 12 V (~160 rad/s per unit duty): kWheelFreeSpeedRadS
    and kManualFreeSpeedRadS -> 160; speed-loop Kp/Ki scaled by 100/160 and
    kWheelCmdLeadRadS 8 -> 13 to keep the tested loop behavior.
    - 12 V settings: back-EMF current limit in WheelMotor::setDuty, max duty 0.95.
    - Applied motor duty added to USB CSV (a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
2026-10-15 Correct encoder supply: encoders are on Teensy 3.3 V, no level shifting needed
    973ecad's message and the first handoff note said the encoders ran from a
    ~5 V pack and needed dividers on Teensy pins 2-9. That was a mix-up: the
    4.96 V measurement was the motor drivers' VCC (5 V logic rail). The encoder
    Vcc (blue) wires are on the Teensy 3.3 V pin, so A/B swing 0-3.3 V and the
    pins are safe as wired. Updated HANDOFF_2026-10-15.md, CLAUDE.md and the
    pins.h comment; restored the below-spec 3.3 V encoder supply as a suspect
    for wheel C.
2026-10-16 Add static-test SD logging and DEMO SPIN level-then-spin demonstration
    Static test logging:
    - No SD file at boot. "BEGIN STATIC TEST" (XBee/USB) opens STATIC_####.CSV
    and logs every gyro sample (~100 Hz) until power is removed (1 s flush).
    - Rows add the EKF output (quaternion, roll/pitch/yaw, gyro bias, 1-sigma,
    accel status, state); 64-bit timestamps; 32 KB SD buffer; XBee gets every
    50th row (~2 Hz) to fit 9600 baud. STATUS reports sd=<file>,drop=<n>.
    DEMO SPIN (XBee/USB, from Idle, wheels stopped, tilt <= 30 deg):
    - Level (reference slews to level at <= 0.1 rad/s keeping heading), spin up
    CCW about +z over 10 s, hold 10 s, spin down 10 s, settle 3 s, Idle.
    - Rate = 80% of the wh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
2026-10-16 Static IMU test results, 60 s gyro calibration, IMU sequence diagnostics, TODO list
    Static test (STATIC_0001.CSV, 37 min at rest, motors off) + analysis page:
    - Roll/pitch excellent: 0.02 deg std dev, no drift.
    - Yaw drifted -27 deg/h (magnetometer flat, so pure estimator drift). Cause:
    the 3 s startup calibration left a -0.0078 deg/s z-gyro bias error, which
    gravity can't correct; gyro noise predicts exactly this.
    - ~1/3 of gyro samples lost and 38 stalls > 100 ms (the armed IMU timeout).
    Firmware:
    - Startup gyro-bias calibration 3 s -> 60 s (expected ~6 deg/h yaw drift),
    progress messages over XBee, new CALIBRATE command (Idle only).
    - Track the BNO085's own gyro report sequence num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
2026-10-17 Motors-on static test, MAG MAP test, EKF bias fix, demo wheel bias
    Tests and analysis (test_runs/):
    - STATIC_0005 (all wheels 100 rpm) vs STATIC_0001 (motors off): magnetometer
    is ~7x noisier with motors on (fast, filterable lines at shaft-related
    frequencies); averaged heading steady to 0.15 deg; motor start shifted
    heading ~7.6 deg. Gyro unaffected; vibration harmless.
    - Yaw drift root cause (confirmed by replaying the logs through a port of
    the EKF): BNO085 z-gyro bias shifts ~0.007 deg/s (~25 deg/h) during the
    first ~5 min after power-on; calibrating after warm-up gives ~3 deg/h.
    - MAGMAP_0001: the stopped-wheel magnetometer field depends on where each
    motor shaft stops (up t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
2026-10-21 BNO085 INT/RST support, keep every IMU report, service IMU during SD stalls
    - pins.h: BNO085 INT -> pin 20, RST -> pin 21 (wired 2026-10-20).
    - imu_bno085: hardware reset before init (no power cycle after uploads),
    INT-gated reads with a 20 ms fallback poll, per-report timestamps from
    the INT edge + SH2 delay, report watchdog, and our own SH2 callback +
    64-deep queue. Adafruit's getSensorEvent() kept only the last report of
    each transfer, which dropped most of the "missed" gyro samples.
    - main: yield() override reads the IMU while SdFat waits on the card;
    IMU init retries with I2C scan / pin diagnostics; STATUS adds lat/int/
    svc/ev/rst/en/intpin.
    - data_logger: SD card in DMA mod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
2026-10-21 Finish IMU sample-loss fixes, integrate gyro gaps, add team progress log
    - imu_bno085: trigger reads on any INT edge since the last read (the chip
    pulses INT; a level check missed some), backup poll 20 -> 5 ms, and turn
    off the chip's own calibration and DCD auto-save (unused; did not remove
    its periodic 60-90 ms stalls, documented as such).
    - main: EKF integrates gyro gaps up to the 100 ms IMU timeout instead of
    skipping anything over 50 ms (stalls lost ~3 deg of yaw each when spinning).
    - STATIC_0008/0009 logs: gyro loss now 25 of ~29,250 (0.085%), longest gap
    90 ms, no chip resets (was ~1/3 lost, 38 freezes > 100 ms).
    - PROGRESS_LOG.md: chronological record of all work and findi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
2026-10-21 Add DEMO LEVEL test, DEMO_0002 analysis, and balanced-demo slide
    - DEMO LEVEL command: same leveling as DEMO SPIN, then hold level at the
    start heading with no spin, no level timeout and no wheel bias, until
    STOP / KILL / wheel limit. New phase 'K' once level is reached; reports
    the armed and level-held times on STOP or the wheel limit.
    - test_runs/DEMO_0002.CSV: six DEMO SPIN attempts after the balance
    weights. All stayed in Level and stopped at the 55 rad/s wheel-A limit:
    roll settled at ~2 deg (resting roll still ~3.3 deg, -y side heavy).
    Weights balanced pitch and slowed the free swing 1.8 -> 3.3 s.
    - Prelim deck: new slide "Data: DEMO SPIN After Balancing" with
    Reports/fig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
2026-10-22 Update prelim deck with team edits, add theory briefing guide
    - Prelim deck (18 slides): hardware and balancing photos, battery-holder
    CAD, review fixes, schedule to Lsn 31; pictures compressed (62 MB ->
    3 MB).
    - Original template renamed to UNEDITED...Prelim_Pres.pptx.
    - Reports/Theory_Briefing_Guide.md: speaker notes and likely questions
    for the two theory slides (MEKF, control law, allocation, PI loop).
2026-10-23 Caption and lay out photos on prelim slides 7 and 15
    Slide 7: Overall View, Battery Holder Detail, Battery Holder CAD.
    Slide 15: Setting Up for Spin, Additional Weight Detail.
    Pictures aligned at equal height and centred; embedded fonts unchanged.
2026-10-23 Add DEMO LEVEL test log and analysis
    - test_runs/DEMO_0003.CSV: five DEMO LEVEL runs after the roll trim (the
    SD card saved them as DEMO_0002; renamed so the DEMO SPIN log in
    DEMO_0002.CSV is kept). All levelled and held steadily, up to 15.8 s
    level (20.8 s armed), before wheel B hit 55 rad/s.
    - test_runs/DEMO_LEVEL_analysis.html and Reports/figures/fig7_demo_level.png:
    held tilt matches the PD steady-state error (torque / Kp); leftover
    gravity torque 1.3-3.3 mN m, now mostly pitch.
    - PROGRESS_LOG.md: section 2.11.
2026-10-27 Add magnetometer yaw aid, wheel fault detection, and calibration report
    Fixed-table magnetometer calibration (2026-10-27): per-wheel spinning-field
    model for A-C, heading-only EKF magnetometer update that also estimates the
    z gyro bias, and a mag_aid module that gates on wheel state and learns
    per-state references. Adds MAG ON/OFF, KICK, RAW ON/OFF and WHEEL x ON|OFF
    commands, automatic encoder-fault wheel disable, tools/mag_cal.py, and the
    raw test captures.
    Works with wheels stopped (10 deg yaw error decays with tau ~25 s); not yet
    within +-1 deg with wheels spinning. Wheel D's encoder has a dead channel.
    Details and remaining work: Reports/Magnetometer_Yaw_Aid_Report_2026-10-27.md
    Co-Au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
2026-10-29 Mag aid: hysteresis, per-direction-pattern references, learning guard
    Fixes for the spinning case found in the 2026-10-27 validation:
    - decide the wheel state on low-passed speeds with 6/4 rad/s hysteresis;
    a field-strength reject no longer restarts the settle
    - one spinning reference per wheel direction pattern, so mixed-direction
    combos don't depend on single-wheel terms adding up
    - learn a reference only within 30 s of an applied update (mode x = stale)
    - Manual mode releases a stopped wheel at target 0 (no holding current)
    Stopped case re-checked on hardware (KICK +10 recovers, tau ~25 s);
    spinning case still needs the fixed-table re-test.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
2026-10-29 Add test 5 spinning validation of the mag aid (A+B, wheel C fault)
2026-10-29 DEMO LEVEL holds the natural rest tilt; add simulation report
    - DEMO LEVEL: heading held with the full PD; roll/pitch reference set to
    the measured tilt every step, so those axes are only damped and the
    table settles where gravity balances it (no steady roll/pitch torque).
    Settled = tilt within 0.25 deg of its 2 s average for 3 s; reports the
    rest tilt. Chosen over a slowly-tracking reference after a single-axis
    simulation (8 vs 42 mN m s stored for a 2 deg start). Not yet run on
    the table.
    - Reports/Simulation_Results.html + Reports/figures/sim1-sim6: all Python
    simulations re-run with current firmware settings (EKF vs truth, yaw
    drift vs calibration from logged data, hold a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
2026-10-29 Document Teensy power fault after test 5 and update progress log
    After the spinning validation (test 5) the Teensy stopped enumerating on
    USB. Boost output is 5 V and motor packs are >= 12 V, but there is no
    5 V at the Teensy VIN pin, no 3.3 V, no LEDs and no bootloader LED.
    Recorded as the top blocker in TODO.md section 0 with diagnosis steps,
    added report section 1.7, and brought PROGRESS_LOG 2.12 up to date with
    the 2026-10-29 aid fixes and test 5 results.
2026-10-30 Add SLEW TEST and FAULT TEST firmware with simulation report
    SLEW TEST (stretch requirement): four target attitudes reached along the
    shortest rotation on a smooth profile, each held within +/-1 deg for 5 s
    and graded PASS/FAIL. After target 4 the test holds it until STOP. The tilt
    safety limit is 25 deg while it runs. SLEW SET / SLEW LIST change and show
    the targets.
    FAULT TEST (requirement 3): a per-wheel dead-motor detector (driven hard but
    not accelerating for 0.2 s) takes the wheel out of service and coasts it at
    the zero-current duty; the other three wheels carry on. FAULT TEST <A-D>
    silently kills one motor's output and grades detection and recovery.
    FAULT TEST REAL grades a physical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
2026-10-30 Record Teensy failure diagnosis and spare bring-up
    The original Teensy's 3.3 V rail is shorted on the board itself (0.8 ohm
    bare, very hot when powered), so it is dead. No wiring cause was found:
    driver VIN-VCC and VM-VCC, and every motor lead to encoder lead, read open.
    The spare Teensy was flashed with 5ec01a5, its VIN-VUSB trace cut, and
    brought up in stages. IMU, XBee, encoders A-C and motors A-C all check out.
    Wheel C runs about 17% slow at 0.3 duty; wheel D stays off until its encoder
    is repaired.
2026-10-30 Record wheel D encoder fix (loose wire)
    Wheel D's dead encoder channel was an encoder wire that had almost pulled
    out. After reseating, TEST D +/-0.3 gives +44.9 / -46.8 rad/s with clean
    counts and no encoder-fault trips, so all four wheels are back in service
    and WHEEL D OFF is no longer needed.
2026-10-30 Add Teensy recovery report; wheel D encoder lead is intermittent
    Reports/Teensy_Recovery_2026-10-30.html records the session:
    - how the short was traced to the original Teensy (0.8 ohm on its 3.3 V
    rail; the board is dead);
    - the cause checks, which all read open, so the cause was not found;
    - the staged bring-up of the spare, with IMU and XBee health;
    - encoder hand-turn counts, and motor tests and breakaway for all four
    wheels.
    Wheel D's encoder lead failed again after the first reseat. It is now
    tracked as intermittent and needs soldering plus strain relief. Wheel C's
    slow first start did not repeat: pack C reads 12.3 V, it runs 46 rad/s
    at 0.3 duty, and it breaks away at the same du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
2026-10-31 Recalibrate magnetometer wheel model; document the new upload procedure
    MAG MAP on the fixed table (test_runs/MAGMAP_0003.CSV, analysis page
    alongside) recalibrated the per-wheel field model in mag_aid.cpp:
    - A-C repeat the 2026-10-27 fit within ~0.15 uT;
    - wheel D is measured for the first time;
    - speed slopes are tiny;
    - all four wheels reversing together add up within 0.2-0.45 deg.
    The raw field now carries a large table-fixed offset, so a hard-iron
    calibration is needed before tests where the table yaws.
    The spare Teensy's VIN-VUSB pads are still joined, so USB and the logic
    battery must never be on together. CLAUDE.md gains an "Uploading and
    running" procedure: upload over USB with the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
2026-10-31 Add MAG TEST, wheel-bias planner, live tuning, test tools; MAG TEST and air-bearing results
    - MAG TEST: scripted fixed-table validation of the magnetometer yaw aid, graded on board.
    - Heading-hold wheel bias (null_bias): keeps every wheel >= 100 rpm from zero in ARM /
    DEMO LEVEL; decides on low-passed speeds with a 5 s dwell after flipping 15 times on the
    table (DEMO_0003 test 2).
    - Mag aid: hard-iron correction, prediction fallback for stale patterns (learning in place
    stays the default after MAGTEST_0002), live SET/GET tuning, STEP TEST (inertia from
    momentum exchange), LEVEL ZERO (IMU mounting), encoder counts in the log.
    - SD logger: whole, sector-aligned writes up to 8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
2026-10-31 Balance session, start-from-rest fault fixes, 80 rad/s wheel limit, 300 ms IMU gap limit
    - Dead-motor detector and encoder check: a wheel at standstill now needs effort/duty >= 0.4
    before it counts as dead or encoder-faulted. Healthy wheels break away at 0.10-0.27 effort;
    14 false flags in DEMO_0004/0005 (13 on wheel D) all had a wheel stuck at 0.23-0.30.
    Replaying both logs with the new rule: 0 flags.
    - Wheel speed limit 60 -> 80 rad/s (full motor torque up to ~79 rad/s at 12 V), with the
    overspeed trip (90), demo/slew abort (75), hold-bias peak (65) and HOLD_PEAK range moved
    with it. Clamped vibration check up to +/-760 rpm: accel sd <= 0.1 m/s^2, gyro unaffected.
    - IMU gap limit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
2026-11-01 Hard iron, SLEW YAW, yaw gyro scale, aid off by default; 10-30/31 write-up and logs
    - Table hard iron (+20.5, -48.9, 0) uT from a free-turn circle fit: the uncorrected field
    (2.4x Earth's horizontal) made the aid pull the heading up to 9 deg on the air bearing.
    - SLEW YAW: stretch test as the pendulous table can do it - yaw follows the eigenaxis slew
    profile through the 4 targets' headings, roll/pitch only damped at the rest tilt; graded
    like SLEW TEST with roll/pitch from the rest tilt. 4/4 PASS on the table (x3).
    - Yaw gyro scale factor kGyroScaleZ 1.009 (SET GYRO_SZ): the BNO085 read ~0.9% short,
    ending SLEW YAW a few degrees past the marker after 360 deg. Now ends on th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
2026-11-02 SLEW TILT, momentum leak, laser scale; wheel D / pack A diagnosis
    - SLEW TILT: rest-tilt scan, gravity unload, tilted targets as offsets
    from the rest map, gravity feedforward (SET GRAV_K), budget check;
    SLEW TSET / SLEW LIST.
    - SLEW YAW and the scan: slow-drift reference rate and a momentum leak
    so x/y gyro bias times Kd no longer fills the wheels (DEMO_0012).
    - slewsim: tilt mode, CG height, tilt scale, GRAV_K error, gyro bias.
    - Laser scale sheet for a 2480 mm wall (tools/laser_scale.py + PDF).
    - PROGRESS_LOG 2.26-2.28: CG raise, SLEW YAW -0.1 deg after 360 deg by
    laser, laser hold drift, wheel D encoder lead and pack A lead faults,
    unexplained Teensy reboots. Balance iteration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
2026-11-02 DEMO ALL; EKF heading leak fix; SD stall fix; laser-verified demo run
    - DEMO ALL [s] [A-D] (full_demo.h/.cpp): heading hold, SLEW YAW from the
    held heading, then a wheel failure, in one armed run; summary line.
    - EKF: accelerometer update no longer moves heading (accelNoHeading); the
    MEKF yaw/tilt correlation took ~1% off every turn. kGyroScaleZ re-fitted
    1.009 -> 1.0045 by replaying logs against the laser.
    - SD: header written and flushed when the log file is opened, before
    arming; the first-write FAT search stalled the wheel loop and caused
    every first-arm-after-boot failure. Wheel loop skips fault checks on a
    stalled step and reports it.
    - Replay tool: --leak, --gyro-sz, --log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
2026-11-02 Final presentation rebuilt: everything since the prelim, ending in DEMO ALL
    - 51 slides (was 29): requirements all verified on hardware with laser
    numbers; bottom-line slide; code slides for the gravity-update fix and
    the DEMO ALL sequencer; laser truth setup; 10-31 / 11-01 test log;
    MAG TEST shown with both runs; presentation-spot magnetometer; balance,
    false dead-motor flags, STEP TEST, FAULT TEST, wheel D, tilted slews,
    SLEW YAW, SLEW TILT, laser holds, estimator heading leak, SD start
    stall; DEMO ALL overview + one slide per requirement; updated status,
    lessons learned / future work, GenAI. Speaker notes on new slides.
    - New figures (Reports/figures/final_2026-11-02, make_f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
2026-11-03 Final deck: projector-sized figures, reworked code section; firmware review
    - Nine presented data slides re-figured (deck_figs.py, rebuild_final.py): 13 pt
    text, wide format, key numbers on the plots; MEASURE/COMPARE text tightened.
    - Code section is now Attitude Estimation (MEKF, gravity fix included),
    Control Law & Wheel Allocation (moved up from backup), Wheel-Failure
    Detection (rework_code.py); 20 presented slides, backup from 21.
    - Briefing guide: new slide 6/7 sections, renumbered.
    - Firmware_Review_2026-11-02.md: 15 suggested changes, none applied
    (firmware frozen until after the presentation).
2026-11-03 Final deck: system block diagram, no progress wording, safe to edit
    - Slide 9 is the system block diagram; the laser-truth slide moves to
    backup (a heading-truth bullet stays on slide 9).
    - Progress-report titles and wording removed from slides and notes
    (Test Record, Results and Open Items, Battery & Washer Holders).
    - Edit safety (edit_safe.py): code panels are one filled shape; stat
    and numbered cards are grouped; text boxes shrink on overflow instead
    of growing over figures; every paragraph has an end-of-paragraph
    format. Render is pixel-identical on 48 of 53 slides, code text
    shifted ~0.03 in on the other 5.
    - Briefing guide: slide 9 section and backup table updated.
    Co-Aut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
2026-11-03 Final deck aligned with the course's final-presentation guidance
    - Requirement table: test method & pass criterion, measured outcome, and an
    explicit final status (PASS x3; stretch achieved in part).
    - Every result block is MEASURE / COMPARE / EXPLAIN / IMPROVE; COMPARE adds
    simulation / prediction where we have it, EXPLAIN states pass or fail,
    IMPROVE says what changed after testing and whether the retest worked.
    - Data figures titled with the test and its conditions; +-1 deg limits
    labelled.
    - New presented slide Hardware: Final Build (photos + CAD); Final Results &
    Limitations moved into the talk (22 presented slides).
    - Objective states the new KestrelSAT capability; GenAI slid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
2026-11-03 Final deck in plain, third-person language; briefing guide synced
    - Slide text (presented and backup) rewritten as short full sentences for a
    general audience, third person and active voice: MEASURE / COMPARE /
    EXPLAIN / IMPROVE blocks, takeaways, requirement table, theory and code
    bullets, results, lessons, future work. Numbers kept where they matter;
    jargon removed or explained. Code panels, equations, test-record tables,
    GenAI slide and speaker notes unchanged.
    - PowerPoint-measured: no text taller than its box; all text shapes shrink
    on overflow.
    - Briefing guide: 23 presented slides (IMU Data Integrity at 11), new IMU
    section, the team's four lessons, slide labels and cros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
2026-11-04 Final deck: standard theta on slide 5; team's PowerPoint edits
    - Slide 5: the error angle symbol in the control law rendered as the
    script form (the fallback font's italic theta); it is now set in
    Cambria Math, which draws the usual italic theta.
    - Slide 5: the inertia text box reached past the slide edge after the
    edit; clamped inside the slide.
    - Includes the team's edits saved in PowerPoint: slide 2 objective box
    removed, slide 3 and 5 wording, slide 1 notes link removed.
2026-11-04 Final deck: slide 2 cards are Overview, Objectives, Why it matters
    - Slide 2 retitled Overview & Objectives; the three cards now state what
    the team built, the lab objectives, and why attitude control and wheel
    failure tolerance matter (Kepler). Green requirement chips removed.
    - Speaker notes and the briefing guide's slide 2 section updated.
    - overview_cards.py reproduces the change on the team's current file.
2026-11-04 Final deck: projector colours, plots fill their space, "software" wording
    - Slide 14 legend names the calibration: red 5 min, blue and green 10 min.
    - Presented plots (slides 11-19) redrawn at the exact size of their plot area
    with a saturated palette and thicker lines; text blocks fitted at the bottom
    (fixes slide 15's text running off the slide). Backup plots trimmed, fitted
    and saturated; diagrams and slide accent colours more saturated.
    - "firmware" -> "software" in slide text, tables, notes, two backup figures
    and the briefing guide.
    - edit_safe.py keeps an existing shrink-to-fit scale.
2026-11-04 Final deck: source lines in code-slide notes; lavender wheel-failure shading
    - Speaker notes on the code slides (6, 7, 8, backups 27, 28) end with the
    file and line numbers of every excerpt (commit c9b219e), and say where the
    slide simplifies (code_notes.py).
    - DEMO ALL part 3 is shaded lavender instead of orange so wheel B's orange
    line shows on slide 16; slide 19's band matches.
    - projector.py: re-running no longer drops the image of an unchanged plot.
